lucaswewa/microscope/docs/adr/README.md

# Architecture decision records

An ADR records one significant decision: the context, what was decided, its consequences, and the alternatives that lost. [ADR-0001](0001-record-architecture-decisions.md) explains why we keep them.

## Process

1. Write the ADR in the pull request of the phase that makes the decision. Copy [template.md](template.md) to `NNNN-short-title.md`, using the next free number.
2. Give it the status *Accepted*. Approving the pull request accepts the ADR. If the review changes the decision, the ADR is edited in the same pull request. *Proposed* is only for an ADR written ahead of a decision, to collect review on it.
3. After acceptance, an ADR isn't edited except for its status line. To change a decision, write a new ADR and mark the old one *Superseded by ADR-NNNN*.
4. Add a row to the index below.

ADRs say *why*. What was built, and how, goes in the phase's [implementation notes](../milestone-1/notes/README.md).

## Index

| ADR | Title | Status | Phase |
|---|---|---|---|
| [0001](0001-record-architecture-decisions.md) | Record architecture decisions | Accepted | P00 |
| [0002](0002-independent-implementation-of-openflexure-inspired-behaviour.md) | Independent implementation of OpenFlexure-inspired behaviour | Accepted | P00 |
| [0003](0003-milestone-1-platform-windows-x86-64.md) | Milestone-1 platform: Windows x86_64 | Superseded by ADR-0038 | P00 |
| [0004](0004-depend-on-teta-wot-v0-1-0-without-upstream-changes.md) | Depend on `teta-wot` v0.1.0 without upstream changes | Accepted | P00 |
| [0005](0005-repository-layout-and-crate-boundaries.md) | Repository layout and crate boundaries | Accepted; amended by ADR-0041 | P01 |
| [0006](0006-own-the-server-lifecycle-around-teta-wots-runtime.md) | Own the server lifecycle around `teta-wot`'s runtime | Accepted | P02 |
| [0007](0007-api-prefix-and-openflexure-mirrored-names.md) | API prefix `/api/v1` and OpenFlexure-mirrored names | Accepted | P02 |
| [0008](0008-server-logging-and-log-endpoints.md) | Server logging and log endpoints | Accepted | P03 |
| [0009](0009-frontend-toolchain.md) | Frontend toolchain | Accepted | P04 |
| [0010](0010-rules-for-a-tauri-ready-web-app.md) | Rules for a Tauri-ready web app | Accepted | P04 |
| [0011](0011-design-tokens-and-theming.md) | Design tokens and theming | Accepted; superseded in part by ADR-0047 | P06 |
| [0012](0012-icon-set.md) | Icon set | Accepted | P07 |
| [0013](0013-own-components-on-reka-ui-primitives.md) | Own components on Reka UI primitives | Accepted | P08 |
| [0014](0014-client-transports-td-forms-fetch-streams-polled-invocations.md) | Client transports: TD forms, fetch streams, polled invocations | Accepted | P10 |
| [0015](0015-connection-model.md) | Connection model | Accepted | P11 |
| [0016](0016-serving-and-embedding-the-web-app.md) | Serving and embedding the web app | Accepted | P12 |
| [0017](0017-simulator-architecture.md) | Simulator architecture | Accepted | P13 |
| [0018](0018-hardware-abstraction-through-teta-wot-interfaces.md) | Hardware abstraction through `teta-wot` interfaces | Accepted; superseded in part by ADR-0044 | P15 |
| [0019](0019-stage-units-integer-steps-with-a-um-scale.md) | Stage units: integer steps with a µm scale | Accepted | P15 |
| [0020](0020-camera-frame-pipeline.md) | Camera frame pipeline | Accepted | P17 |
| [0021](0021-generated-api-types.md) | Generated API types | Accepted | P19 |
| [0022](0022-sharpness-metric-and-fast-autofocus.md) | Sharpness metric and fast autofocus | Superseded in part by ADR-0037 | P21 |
| [0023](0023-image-registration-by-phase-correlation.md) | Image registration by phase correlation | Accepted | P22 |
| [0024](0024-server-described-ui-elements.md) | Server-described UI elements | Accepted | P24 |
| [0025](0025-data-folder-layout-and-capture-metadata.md) | Data folder layout and capture metadata | Accepted | P26 |
| [0026](0026-gallery-index-and-data-route.md) | Gallery index and data route | Accepted | P31 |
| [0027](0027-deep-zoom-viewer.md) | Deep-zoom viewer | Accepted | P33 |
| [0028](0028-scan-planning-model.md) | Scan planning model | Accepted | P34 |
| [0029](0029-scan-engine-and-workflow-things.md) | Scan engine and workflow Things | Accepted | P35 |
| [0030](0030-position-based-stitching-with-dzi-output.md) | Position-based stitching with DZI output | Accepted; superseded in part by ADR-0046 | P38 |
| [0031](0031-sequence-model.md) | Sequence model | Accepted | P41 |
| [0032](0032-sidecar-process-contract.md) | Sidecar process contract | Accepted | P44 |
| [0033](0033-local-launcher-and-its-tauri-successor.md) | Local launcher and its Tauri successor | Accepted | P45 |
| [0034](0034-visual-regression-baselines.md) | Visual regression baselines | Accepted | P47 |
| [0035](0035-release-packaging-and-third-party-notices.md) | Release packaging and third-party notices | Accepted | P49 |
| [0036](0036-image-overlay-layers.md) | Image overlay layers | Accepted | P53 |
| [0037](0037-autofocus-accuracy.md) | Autofocus accuracy: focus at the curve's centroid | Accepted | P54 |
| [0038](0038-milestone-2-platforms.md) | Milestone-2 platforms: Windows, Linux and the Raspberry Pi 5 | Accepted; superseded in part by ADR-0040 | M2 P00 |
| [0039](0039-teta-wot-on-linux.md) | `teta-wot` on Linux | Accepted | M2 P01 |
| [0040](0040-linux-ci-on-request-and-parallel-tests.md) | Linux CI on request, and the Rust tests in parallel | Accepted | M2, after P01 |
| [0041](0041-hardware-drivers.md) | Hardware drivers: SDKs, device actors and hardware tests | Accepted | M2 P03a |
| [0042](0042-zaber-stages-through-the-ascii-protocol.md) | Zaber stages through the ASCII protocol | Accepted | M2 P04 |
| [0043](0043-the-sdk-camera-frame-pipeline.md) | The SDK camera frame pipeline | Accepted | M2 P06 |
| [0044](0044-one-camera-thing-for-every-sdk.md) | One camera Thing for every SDK, and Basler cameras through pylon | Accepted | M2 P07 |
| [0046](0046-correlation-stitching.md) | Correlation stitching | Accepted | M2 P12 |
| [0047](0047-accent-colours-a-person-can-choose.md) | Accent colours a person can choose | Accepted | M2, outside a phase |

The [implementation plan](../milestone-1/implementation-plan.md#adr-plan) lists the ADRs planned for later phases.
