lucaswewa/microscope/docs/milestone-2/notes/README.md

# Milestone 2 implementation notes

One file per phase, written in that phase's pull request from [template.md](template.md). The notes say what was built, how to try it, what hardware it was tried on, how it was designed, where it departs from the [phase spec](../phases.md), and what's left to do. The reasons behind significant decisions go in [ADRs](../../adr/README.md).

## Status

A phase's notes are marked *In review* in its own pull request. The next phase's pull request marks them, and the phase's row in the [plan's overview](../implementation-plan.md#7-phase-overview), *Done*, since a merged pull request can't be edited. A driver phase is *Done* only after the owner has run its "How to try it" on the device.

## Index

| Phase | Notes | Status |
|---|---|---|
| P00 | [Milestone 2 groundwork](P00-groundwork.md) | Done |
| P01 | [Linux builds and CI](P01-linux-ci.md) | Done |
| P02 | [The Linux service and packages](P02-linux-service.md) | Done |
| P03a | [Device actors and serial ports](P03a-device-actors.md) | Done |
| P03b | [The SDKs at run time, and listing devices](P03b-sdks.md) | Done |
| P04 | [Zaber stages](P04-zaber.md) | In review, until tried on the stage |
| P06 | [The SDK camera pipeline](P06-camera-pipeline.md) | Done |
| P07 | [Basler cameras](P07-basler.md) | In review, until tried on the camera |
| P12 | [Correlation placement](P12-correlation-placement.md) | In review |
