lucaswewa/microscope/docs/misc/optima.md

# Optic Platform for Targeted Imaging & Microscopy Automation (OPTIMA)

## Features
| Feature | Description |
|----|----|
| Standrd Objectives | 4x/10x/20x/40x |
| Automated motorized three-position turret | Customization possible |
| Excitation Wavelengths | 405 nm (e.g. DAPI) |
| Single-laser, dual laser or quad laser configuration | 488 nm (e.g. GFP) |
| Emission Wavelengths | 520 nm, (e.g. mCherry) |
|  | 635 nm, (e.g. AlexaFluor 647) |
|  | Custom Cube Setup (typically DAPI 488 nm, GFP 520 nm, mCherry) 635 nm, AlexaFluor 647 |
| Imaging Modes | Brightfield, Colored Brightfield, Phase Contrast, Fluorescence, DPC, FLIM (through FLIM Labs) |
| Operating Range (XYZ) | 100x100x20 mm |
| Focusing Drive Range (Zf) | 4 mm |
| Illumination options | LED array for phase-contrast |
| Labware Supported | Microplates (6x-384x), cell culture flasks (T25, T75), Petri- and cell culture dishes, microscope slides (4fold holder), count- and flow chambers, adapter for customized formats |
| Camera Compatibility | Single/Dual-camera in cube assembly (e.g. RGB for Histology, Monochrome for Fluorescence), overview camera top |
| Data Format | OME-ZARR, OME-TIF, JPEG, MP4, PNG, customized |
| Dimensions & Weight | 300x300x300 mm, <16Kg |
| Electric Input | Power Supply: 110/230V, 50/60Hz |
|  | 12V, 5A (optional: battery-driven) |
