lucaswewa/microscope/docs/misc/microscope_algorithms_and_workflows.md

# Microscope Software: Algorithm and Workflow Catalog

Prepared for software serving biotechnology, semiconductors, metallurgy, scientific research, optical device inspection, and adjacent industries.

Last reviewed: October 30, 2026.

## Scope and how to use this catalog

This is a broad planning catalog, rather than a claim to enumerate every microscopy method. It covers optical microscopy first, with extensions for electron, scanning probe, X-ray, and acoustic microscopy. Entries include individual algorithms, algorithm families, application analysis modules, and supporting software capabilities. End-to-end workflows are listed separately in Part II.

Each catalog entry gives a brief description and representative application areas. A family such as thresholding can support several selectable implementations. Application modules deliberately reuse the shared algorithms; for example, cell counting, inclusion counting, and wafer particle counting share detection and measurement infrastructure but need different recipes and validation.

The **Ref Link** column in the algorithm and workflow tables links to a representative application, worked example, or documented implementation. Related entries may share a resource when it demonstrates several methods.

For optical layouts, hardware requirements, open build resources, and a design mapping for all 57 workflows, see [Reference Microscope Designs](microscope_reference_designs.md).

**Input and hardware assumptions**

- Ordinary 2D images support many correction, segmentation, counting, and dimensional analysis methods. Physical measurements require calibrated pixel sizes and suitable image quality.
- Z stacks, time series, multiple channels, tiled acquisitions, spectra, diffraction patterns, and measured height maps carry different information; retain their axes, units, and acquisition metadata.
- Acquisition control requires compatible camera, stage, illumination, and instrument interfaces. Focus-derived height requires a calibrated Z axis and an appropriate sample surface.
- Interferometry, quantitative phase imaging, fluorescence lifetime imaging, Raman analysis, electron diffraction, and similar methods require their corresponding measurements or instrument configurations. They cannot be recovered reliably from arbitrary conventional images.
- Optical lateral resolution, axial resolution, localization precision, height precision, and measurement uncertainty are different quantities. Software must report the quantity actually measured.
- Quantitative analysis should retain raw data and record all corrections. Learned restoration, synthetic staining, and inferred structures need validation against independent measurements before their outputs are used quantitatively.

**Navigation**

- [Part I: Algorithms and analysis modules](#part-i-algorithms-and-analysis-modules)
  - [1. Acquisition and microscope automation](#1-acquisition-and-microscope-automation)
  - [2. Calibration and instrument characterization](#2-calibration-and-instrument-characterization)
  - [3. Image correction, denoising, and restoration](#3-image-correction-denoising-and-restoration)
  - [4. Filtering and feature extraction](#4-filtering-and-feature-extraction)
  - [5. Registration, stitching, and fusion](#5-registration-stitching-and-fusion)
  - [6. Segmentation and object detection](#6-segmentation-and-object-detection)
  - [7. Measurement, morphology, and spatial statistics](#7-measurement-morphology-and-spatial-statistics)
  - [8. Tracking, motion, and temporal analysis](#8-tracking-motion-and-temporal-analysis)
  - [9. Volumetric analysis and 3D reconstruction](#9-volumetric-analysis-and-3d-reconstruction)
  - [10. Computational and quantitative phase microscopy](#10-computational-and-quantitative-phase-microscopy)
  - [11. Quantitative fluorescence and single-molecule analysis](#11-quantitative-fluorescence-and-single-molecule-analysis)
  - [12. Spectral, chemical, and polarization microscopy](#12-spectral-chemical-and-polarization-microscopy)
  - [13. Cell, microbial, and biotechnology assays](#13-cell-microbial-and-biotechnology-assays)
  - [14. Tissue, histology, and organism analysis](#14-tissue-histology-and-organism-analysis)
  - [15. Semiconductor wafers, lithography, and photomasks](#15-semiconductor-wafers-lithography-and-photomasks)
  - [16. Electronics packaging, PCBs, and displays](#16-electronics-packaging-pcbs-and-displays)
  - [17. Metallography and materials microstructure](#17-metallography-and-materials-microstructure)
  - [18. Optical components, fibers, and photonic devices](#18-optical-components-fibers-and-photonic-devices)
  - [19. Surface texture and experimental mechanics](#19-surface-texture-and-experimental-mechanics)
  - [20. Electron microscopy and crystallography](#20-electron-microscopy-and-crystallography)
  - [21. Scanning probe microscopy](#21-scanning-probe-microscopy)
  - [22. X-ray tomography and acoustic microscopy](#22-x-ray-tomography-and-acoustic-microscopy)
  - [23. Additional scientific and industrial applications](#23-additional-scientific-and-industrial-applications)
  - [24. Machine learning and annotation](#24-machine-learning-and-annotation)
  - [25. Data management, visualization, and interoperability](#25-data-management-visualization-and-interoperability)
  - [26. Quality assurance and reproducible execution](#26-quality-assurance-and-reproducible-execution)
- [Part II: End-to-end workflows](#part-ii-end-to-end-workflows)
- [Part III: Implementation planning](#part-iii-implementation-planning)
- [Selected technical references](#selected-technical-references)
- [Reference microscope designs and hardware mappings](microscope_reference_designs.md)

## Part I: Algorithms and analysis modules

### 1. Acquisition and microscope automation

These capabilities operate the instrument or plan image collection. Motorized functions require device support. See the [Micro-Manager acquisition and autofocus guide](https://micro-manager.org/Micro-Manager_User%27s_Guide2) for a practical reference implementation of multidimensional acquisition.

| ID | Algorithm or module | Brief summary | Application areas | Ref Link |
| --- | --- | --- | --- | --- |
| ACQ-01 | Contrast-based autofocus | Maximize a focus score such as Tenengrad, Laplacian variance, or a frequency-domain metric over a Z search. | Routine microscopy, wafer inspection, metallography, slide scanning. | [Autofocus example](https://micro-manager.org/SimpleAutofocus) |
| ACQ-02 | Coarse-to-fine focus search | Find a promising Z interval with large steps, then refine it with smaller steps or fitted focus curves. | Automated scanning, high-magnification inspection, multiwell imaging. | [Autofocus example](https://micro-manager.org/SimpleAutofocus) |
| ACQ-03 | Predictive or learned autofocus | Predict focus displacement from calibrated image features or a trained model, with confidence and fallback search. | High-throughput screening, repetitive industrial inspection. | [Adaptive acquisition tutorials](https://pycro-manager.readthedocs.io/en/latest/tutorials.html) |
| ACQ-04 | Hardware focus-lock control | Maintain a measured reference plane using a focus sensor and feedback; apply specimen offsets separately. | Long live-cell experiments, high-NA imaging, repetitive scans. | [Multidimensional acquisition](https://micro-manager.org/Micro-Manager_User%27s_Guide2) |
| ACQ-05 | Focus surface mapping | Fit a plane, polynomial, spline, or local surface through sampled focus positions. | Tilted wafers, large tissue sections, metallographic mounts. | [Adaptive 3D acquisition](https://micro-manager.org/MicroMagellan) |
| ACQ-06 | Multidimensional acquisition scheduling | Coordinate positions, channels, Z slices, time points, and acquisition order. | Fluorescence experiments, plate screening, confocal research. | [Multidimensional acquisition](https://micro-manager.org/Micro-Manager_User%27s_Guide2) |
| ACQ-07 | Tile and region scan planning | Generate overlapping tiles within rectangular, polygonal, circular, or irregular regions. | Whole-slide imaging, wafers, large components, materials surveys. | [Adaptive 3D acquisition](https://micro-manager.org/MicroMagellan) |
| ACQ-08 | Stage path optimization | Reduce travel and settling time using serpentine routes or constrained route optimization. | High-content screening, wafer review, automated particle inspection. | [Adaptive 3D acquisition](https://micro-manager.org/MicroMagellan) |
| ACQ-09 | Exposure and illumination optimization | Select exposure, gain, and illumination within signal, saturation, and dose constraints. | Fluorescence, reflective surfaces, automated quality inspection. | [Adaptive acquisition tutorials](https://pycro-manager.readthedocs.io/en/latest/tutorials.html) |
| ACQ-10 | Trigger and timestamp synchronization | Align cameras, illumination, scanners, stages, and external stimuli using hardware events and recorded timing. | Fast dynamics, multiview imaging, optogenetics, mechanical testing. | [Fast triggered 3D imaging](https://pycro-manager.readthedocs.io/en/latest/application_notebooks/TZYX_fast_sequencing_z_indexing.html) |
| ACQ-11 | Adaptive region selection | Use an overview scan to select informative regions for higher-resolution acquisition. | Rare-cell search, defect review, tissue imaging, particle analysis. | [Targeted collagen imaging](https://pycro-manager.readthedocs.io/en/latest/application_notebooks/guiding_acq_with_neural_network_attention.html) |
| ACQ-12 | Event-triggered acquisition | Detect an event online and change recording rate, channels, or regions under defined rules. | Mitosis, calcium activity, crack initiation, droplet events. | [Event-driven live-cell imaging](https://pmc.ncbi.nlm.nih.gov/articles/PMC7613693/) |
| ACQ-13 | Dose-aware acquisition | Allocate illumination or electron exposure according to signal needs and cumulative dose budgets. | Live-cell imaging, photosensitive samples, electron microscopy. | [Adaptive acquisition tutorials](https://pycro-manager.readthedocs.io/en/latest/tutorials.html) |
| ACQ-14 | Stage drift feedback | Estimate displacement from references and correct stage or acquisition coordinates over time. | Long time series, nanostructure imaging, correlative microscopy. | [Data-driven microscopy](https://pmc.ncbi.nlm.nih.gov/articles/PMC10088093/) |
| ACQ-15 | Adaptive Z sampling | Adjust stack boundaries and spacing from surface estimates, signal content, and required axial sampling. | Thick specimens, uneven surfaces, organoids, industrial topography. | [Adaptive 3D acquisition](https://micro-manager.org/MicroMagellan) |
| ACQ-16 | Revisit and coordinate navigation | Transform stored object locations into current stage coordinates using fiducials and alignment models. | Defect review, cell revisiting, sample preparation, multimodal studies. | [Multidimensional acquisition](https://micro-manager.org/Micro-Manager_User%27s_Guide2) |

### 2. Calibration and instrument characterization

Calibration should be indexed by objective, zoom, camera mode, wavelength, and relevant instrument settings. The [ImageJ scientific imaging tutorials](https://imagej.net/imaging/) provide background on spatial calibration and chromatic shift.

| ID | Algorithm or module | Brief summary | Application areas | Ref Link |
| --- | --- | --- | --- | --- |
| CAL-01 | Pixel and voxel scale calibration | Estimate physical sampling from traceable grids, rulers, stage motion, and Z references. | All dimensional and volumetric measurements. | [Microscope QC application](https://pmc.ncbi.nlm.nih.gov/articles/9526251/) |
| CAL-02 | Camera-to-stage coordinate calibration | Fit rotation, scale, shear, and axis directions between pixels and stage coordinates. | Automated navigation, mosaics, robotic inspection. | [Adaptive 3D acquisition](https://micro-manager.org/MicroMagellan) |
| CAL-03 | Geometric distortion calibration | Fit radial, tangential, or spatial warp models using a known target. | Large-field metrology, optical inspection, precision mosaics. | [Camera calibration example](https://docs.opencv.org/4.x/dc/dbb/tutorial_py_calibration.html) |
| CAL-04 | Stage backlash and repeatability estimation | Measure approach-direction errors, hysteresis, and revisit variability. | Precision inspection, automated screening, coordinate transfer. | [Gauge R&R example](https://www.itl.nist.gov/div898/handbook/mpc/section4/mpc4.htm) |
| CAL-05 | Z-axis and axial scaling calibration | Measure Z travel and optical axial scaling, including refractive-index effects where modeled. | Confocal volumes, optical sectioning, focus-derived height. | [Microscope QC application](https://pmc.ncbi.nlm.nih.gov/articles/9526251/) |
| CAL-06 | Point spread function estimation | Estimate spatially invariant or varying blur from beads, edges, or an optical model. | Deconvolution, resolution checks, localization microscopy. | [Microscope QC application](https://pmc.ncbi.nlm.nih.gov/articles/9526251/) |
| CAL-07 | Resolution and transfer-function characterization | Measure edge, line, bead, or target responses to characterize image contrast versus spatial frequency. | Microscope acceptance, objective comparison, optical quality. | [MTF characterization example](https://www.imatest.com/imaging/validating_slanted_edge/) |
| CAL-08 | Camera noise and gain characterization | Estimate conversion gain, read noise, dark current, and variance behavior from calibration frames. | Low-light fluorescence, quantitative imaging, detector qualification. | [Camera characterization](https://www.emva.org/standards-technology/emva-1288/) |
| CAL-09 | Sensor nonlinearity and saturation calibration | Measure and correct response nonlinearity within a characterized operating range. | Intensity assays, reflectance imaging, detector comparison. | [Camera characterization](https://www.emva.org/standards-technology/emva-1288/) |
| CAL-10 | Illumination uniformity calibration | Estimate flat-field and shading maps for each relevant optical configuration. | Tile scanning, quantitative fluorescence, surface inspection. | [CellProfiler example pipelines](https://cellprofiler.org/examples) |
| CAL-11 | Chromatic alignment calibration | Estimate channel-dependent translation, distortion, and axial offsets using multicolor references. | Colocalization, multiplex assays, multichannel metrology. | [Microscope QC application](https://pmc.ncbi.nlm.nih.gov/articles/9526251/) |
| CAL-12 | Spectral crosstalk calibration | Measure channel mixing from single-label or single-component controls. | Fluorescence unmixing, spectral microscopy, multiplex assays. | [PixFRET application](https://imagej.net/plugins/pixfret) |
| CAL-13 | Color calibration and white balance | Map camera responses to a controlled color representation using reference targets and illumination. | Histology, mineralogy, industrial color inspection. | [Color-checker calibration example](https://docs.opencv.org/4.12.0/d1/dc1/tutorial_ccm_color_correction_model.html) |
| CAL-14 | Temporal and scan calibration | Characterize frame timing, trigger latency, rolling shutter, scan spacing, and line timing. | Motion measurement, high-speed imaging, raster microscopy. | [Fast triggered 3D imaging](https://pycro-manager.readthedocs.io/en/latest/application_notebooks/TZYX_fast_sequencing_z_indexing.html) |
| CAL-15 | Height-reference calibration | Verify vertical response and lateral sampling using step-height, flatness, or roughness artifacts. | Interferometry, confocal profilometry, scanning probe metrology. | [Calibration and uncertainties](https://gwyddion.net/documentation/user-guide-en/caldata.html) |
| CAL-16 | Measurement uncertainty propagation | Propagate calibration, repeatability, segmentation, and model contributions to reported uncertainty. | Industrial metrology, quantitative research, instrument validation. | [Dimensional uncertainty study](https://www.nist.gov/publications/dimensional-measurement-uncertainty-data-part-2-uncertainty-rr) |

### 3. Image correction, denoising, and restoration

Apply corrections in a documented order and preserve the unprocessed measurements. The [ImageJ deconvolution guide](https://imagej.net/imaging/deconvolution) describes PSF-based restoration and its input requirements.

| ID | Algorithm or module | Brief summary | Application areas | Ref Link |
| --- | --- | --- | --- | --- |
| COR-01 | Dark and offset correction | Subtract calibrated electronic offsets and exposure-dependent dark signal. | Fluorescence, spectroscopy, long-exposure imaging. | [Camera characterization](https://www.emva.org/standards-technology/emva-1288/) |
| COR-02 | Flat-field and shading correction | Normalize spatial sensitivity and illumination using matched reference images or estimated fields. | Quantitative intensity analysis, mosaics, whole-slide scans. | [CellProfiler example pipelines](https://cellprofiler.org/examples) |
| COR-03 | Background estimation and subtraction | Estimate background using rolling-ball, polynomial, morphological, or robust surface models. | Fluorescence spots, etched materials, uneven illumination. | [Use rolling-ball algorithm for estimating background intensity](https://scikit-image.org/docs/stable/auto_examples/segmentation/plot_rolling_ball.html) |
| COR-04 | Bad-pixel and impulse correction | Identify and replace hot, dead, or impulsive pixels while retaining a correction mask. | Scientific cameras, electron detectors, spectroscopy. | [Fill in defects with inpainting](https://scikit-image.org/docs/stable/auto_examples/filters/plot_inpaint.html) |
| COR-05 | Median and rank denoising | Suppress isolated noise using neighborhood order statistics. | Particle images, brightfield microscopy, detector artifacts. | [Denoising a picture](https://scikit-image.org/docs/stable/auto_examples/filters/plot_denoise.html) |
| COR-06 | Gaussian and variance-aware smoothing | Reduce high-frequency noise with explicit spatial scale and, where relevant, a noise model. | Segmentation preprocessing, low-signal imaging. | [Denoising a picture](https://scikit-image.org/docs/stable/auto_examples/filters/plot_denoise.html) |
| COR-07 | Bilateral and nonlocal means denoising | Average similar intensities or patches while reducing smoothing across strong boundaries. | Cells, materials textures, electron images. | [Non-local means denoising for preserving textures](https://scikit-image.org/docs/stable/auto_examples/filters/plot_nonlocal_means.html) |
| COR-08 | Wavelet and BM3D-style denoising | Shrink multiscale coefficients or jointly filter groups of similar patches. | Low-light microscopy, electron microscopy, textured specimens. | [Shift-invariant wavelet denoising](https://scikit-image.org/docs/stable/auto_examples/filters/plot_cycle_spinning.html) |
| COR-09 | Total variation and anisotropic diffusion | Regularize noise while favoring piecewise-smooth regions or directional structure. | Phase images, tomography, boundary-sensitive analysis. | [Denoising a picture](https://scikit-image.org/docs/stable/auto_examples/filters/plot_denoise.html) |
| COR-10 | Poisson-Gaussian noise treatment | Use count-aware estimators or variance stabilization matched to photon and read noise. | Fluorescence, low-dose electron imaging, quantitative restoration. | [Mixed-noise light-sheet reconstruction](https://pmc.ncbi.nlm.nih.gov/articles/PMC7613773/) |
| COR-11 | Wiener and regularized inverse filtering | Invert a characterized blur with stabilization against noise amplification. | Optical restoration, engineered imaging systems. | [Image Deconvolution](https://scikit-image.org/docs/stable/auto_examples/filters/plot_restoration.html) |
| COR-12 | Richardson-Lucy deconvolution | Iteratively estimate an object from a PSF and a photon-counting image formation model. | Widefield fluorescence, confocal stacks, light-sheet imaging. | [Image Deconvolution](https://scikit-image.org/docs/stable/auto_examples/filters/plot_restoration.html) |
| COR-13 | Blind and spatially varying deconvolution | Jointly estimate uncertain blur or use location-dependent PSFs under constraints. | Thick specimens, aberrated imaging, nonuniform optical systems. | [Depth-varying deconvolution study](https://pmc.ncbi.nlm.nih.gov/articles/PMC5155489/) |
| COR-14 | Learned and self-supervised denoising | Restore images using paired training, independent noisy observations, or valid noise assumptions. | Low-dose imaging, live cells, high-throughput research. | [Noise2Void microscopy examples](https://github.com/juglab/n2v) |
| COR-15 | Stripe, line, and scan artifact correction | Remove characterized banding, raster discontinuities, or light-sheet stripes with masks and filtering. | Light-sheet, SEM, confocal, scanning probe images. | [Scan Line Artefacts](https://gwyddion.net/documentation/user-guide-en/scan-line-defects.html) |
| COR-16 | Photobleaching trend correction | Estimate reference or model-based signal decay, preserving genuine biological changes separately. | Long fluorescence time series, FRAP preprocessing. | [Photobleaching correction examples](https://imagej.net/plugins/bleach-correction) |
| COR-17 | HDR radiometric fusion | Combine registered exposures with a calibrated response to extend measurable intensity range. | Reflective metals, optical components, mixed-brightness specimens. | [HDR exposure fusion example](https://docs.opencv.org/4.x/d2/df0/tutorial_py_hdr.html) |

### 4. Filtering and feature extraction

These are reusable building blocks rather than complete application workflows. Representative operations are documented in [scikit-image morphology](https://scikit-image.org/docs/stable/api/skimage.morphology).

| ID | Algorithm or module | Brief summary | Application areas | Ref Link |
| --- | --- | --- | --- | --- |
| FEA-01 | Contrast stretching and histogram equalization | Remap display intensities globally or locally, including CLAHE; track quantitative use separately. | Visual review, low-contrast structures, operator assistance. | [Local Histogram Equalization](https://scikit-image.org/docs/stable/auto_examples/color_exposure/plot_local_equalize.html) |
| FEA-02 | Gradient and edge detection | Compute Sobel, Scharr, Canny, or derivative-of-Gaussian responses. | Boundaries, scratches, dimensional measurement. | [Canny edge detector](https://scikit-image.org/docs/stable/auto_examples/edges/plot_canny.html) |
| FEA-03 | Laplacian and scale-space blob detection | Locate bright or dark spots across scales using LoG or DoG responses. | Nuclei, vesicles, particles, pinholes. | [Blob Detection](https://scikit-image.org/docs/stable/auto_examples/features_detection/plot_blob.html) |
| FEA-04 | Ridge and vessel enhancement | Use Hessian eigenvalues or directional filters to enhance elongated structures. | Neurites, vessels, cracks, fibers, interconnects. | [Ridge operators](https://scikit-image.org/docs/stable/auto_examples/edges/plot_ridge_filter.html) |
| FEA-05 | Mathematical morphology | Apply erosion, dilation, opening, closing, top-hat, and reconstruction operations. | Mask cleanup, small-feature extraction, background estimation. | [Morphological Filtering](https://scikit-image.org/docs/stable/auto_examples/applications/plot_morphology.html) |
| FEA-06 | Fourier-domain filtering | Apply low-pass, high-pass, band-pass, or notch filters with controlled frequency response. | Periodic structures, scan artifacts, spatial-frequency analysis. | [Butterworth Filters](https://scikit-image.org/docs/stable/auto_examples/filters/plot_butterworth.html) |
| FEA-07 | Wavelet and multiscale features | Describe structure at several spatial scales using localized basis functions. | Texture classification, defects, biological phenotypes. | [Shift-invariant wavelet denoising](https://scikit-image.org/docs/stable/auto_examples/filters/plot_cycle_spinning.html) |
| FEA-08 | Gabor and steerable filters | Measure oriented patterns at selected directions and wavelengths. | Fibers, machining marks, gratings, cell alignment. | [Gabor filter banks for texture classification](https://scikit-image.org/docs/stable/auto_examples/features_detection/plot_gabor.html) |
| FEA-09 | Structure tensor analysis | Estimate dominant orientation, coherence, and local directional organization. | Collagen, composites, grains, cellular alignment. | [Fiber orientation examples](https://bigwww.epfl.ch/demo/orientation/) |
| FEA-10 | Texture descriptors | Calculate co-occurrence, local binary pattern, run-length, or related texture statistics. | Histology, metallography, surface classification. | [GLCM Texture Features](https://scikit-image.org/docs/stable/auto_examples/features_detection/plot_glcm.html) |
| FEA-11 | Hough and Radon transforms | Detect parameterized lines, circles, or oriented structures by accumulating evidence. | Circular defects, fibers, wafer alignment, line arrays. | [Straight line Hough transform](https://scikit-image.org/docs/stable/auto_examples/edges/plot_line_hough_transform.html) |
| FEA-12 | Template and matched filtering | Find known patterns using normalized correlation or a noise-aware matched response. | Fiducials, repeated devices, fluorescent spots. | [Template Matching](https://scikit-image.org/docs/stable/auto_examples/features_detection/plot_template.html) |
| FEA-13 | Keypoint and local descriptor extraction | Identify distinctive points and compute descriptors for matching across images. | Registration, object retrieval, multimodal alignment. | [ORB feature detector and binary descriptor](https://scikit-image.org/docs/stable/auto_examples/features_detection/plot_orb.html) |
| FEA-14 | Color and optical-density features | Extract calibrated color components, ratios, or absorbance-like features from reference intensities. | Stained tissue, minerals, corrosion, coating inspection. | [Separating stains](https://qupath.readthedocs.io/en/stable/docs/tutorials/separating_stains.html) |

### 5. Registration, stitching, and fusion

Choose transformations consistent with the specimen and acquisition. A flexible warp can hide real deformation or manufacturing errors if applied without constraints.

| ID | Algorithm or module | Brief summary | Application areas | Ref Link |
| --- | --- | --- | --- | --- |
| REG-01 | Phase-correlation alignment | Estimate image translation from normalized Fourier cross-power spectra, optionally at subpixel precision. | Drift correction, tile placement, repeated inspections. | [Image Registration](https://scikit-image.org/docs/stable/auto_examples/registration/plot_register_translation.html) |
| REG-02 | Intensity-based rigid and affine registration | Optimize similarity while permitting selected translation, rotation, scale, or shear parameters. | Time series, channel alignment, reference comparison. | [Using geometric transformations](https://scikit-image.org/docs/stable/auto_examples/transform/plot_geometric.html) |
| REG-03 | Feature-based robust registration | Match local features and reject outliers using RANSAC or robust estimation. | Mosaics, damaged specimens, changing fields of view. | [Robust matching using RANSAC](https://scikit-image.org/docs/stable/auto_examples/transform/plot_matching.html) |
| REG-04 | Multimodal registration | Use mutual information, descriptors, or learned similarity across differing contrast mechanisms. | Optical-to-SEM correlation, fluorescence-to-brightfield alignment. | [Multimodal registration examples](https://simpleitk.readthedocs.io/en/master/registrationOverview.html) |
| REG-05 | Deformable registration | Fit B-spline, optical-flow, or diffeomorphic warps with regularization and deformation reporting. | Tissue sections, live specimens, serial imaging. | [Registration using optical flow](https://scikit-image.org/docs/stable/auto_examples/registration/plot_opticalflow.html) |
| REG-06 | Global tile graph optimization | Solve tile positions jointly from overlaps and stage priors to reduce accumulated mosaic error. | Whole slides, wafer mosaics, large-area materials scans. | [Large-volume stitching](https://imagej.net/plugins/bigstitcher/) |
| REG-07 | Mosaic seam and brightness balancing | Blend overlaps and compensate exposure differences while preserving quantitative originals. | Whole-slide viewing, component overviews, microscopy atlases. | [Microscopy stitching example](https://imagej.net/plugins/image-stitching) |
| REG-08 | 3D stack registration | Align volumes using image similarity, landmarks, or surface features. | Longitudinal imaging, serial scans, multiview microscopy. | [Large-volume stitching](https://imagej.net/plugins/bigstitcher/) |
| REG-09 | Fiducial-based coordinate transfer | Fit coordinate transformations from corresponding beads, markers, or lithographic landmarks. | Correlative microscopy, FIB targeting, repeat defect review. | [Correlative semiconductor failure analysis](https://www.zeiss.com/microscopy/us/applications/semiconductors-electronics/failure-analysis-3d-characterization.html) |
| REG-10 | Extended depth-of-field fusion | Select or blend locally sharp Z slices into an all-in-focus image. | Rough parts, insects, minerals, metallographic surfaces. | [Extended-focus specimen example](https://bigwww.epfl.ch/demo/edf/) |
| REG-11 | Multiview image fusion | Combine registered views using confidence, visibility, or joint deconvolution models. | Light-sheet microscopy, 3D specimen imaging. | [Multiview deconvolution example](https://imagej.net/plugins/multi-view-deconvolution) |
| REG-12 | Super-resolution from shifted frames | Reconstruct additional sampling information from calibrated subpixel shifts and an imaging model. | Static specimens, engineered acquisition, resolution research. | [Subpixel-shift super-resolution example](https://pmc.ncbi.nlm.nih.gov/articles/PMC3364049/) |
| REG-13 | Correlative layer overlays | Display aligned modalities, annotations, spectra, and measurement maps with coordinate provenance. | Failure analysis, multimodal biology, materials characterization. | [Correlative semiconductor failure analysis](https://www.zeiss.com/microscopy/us/applications/semiconductors-electronics/failure-analysis-3d-characterization.html) |

### 6. Segmentation and object detection

Support both conventional and learned approaches; object density, image contrast, sample preparation, and training coverage determine which works well.

| ID | Algorithm or module | Brief summary | Application areas | Ref Link |
| --- | --- | --- | --- | --- |
| SEG-01 | Global thresholding | Separate foreground using fixed, Otsu, entropy, triangle, or mixture-based thresholds. | Particles, phases, high-contrast cells, contamination. | [Thresholding](https://scikit-image.org/docs/stable/auto_examples/segmentation/plot_thresholding.html) |
| SEG-02 | Adaptive local thresholding | Compute spatially varying thresholds, including Sauvola- or Niblack-style methods. | Unevenly illuminated tissue, grains, low-contrast defects. | [Niblack and Sauvola Thresholding](https://scikit-image.org/docs/stable/auto_examples/segmentation/plot_niblack_sauvola.html) |
| SEG-03 | Multilevel and multichannel thresholding | Assign multiple classes using intensity bands, channel logic, or joint thresholds. | Material phases, fluorescence phenotypes, coating regions. | [Multi-Otsu Thresholding](https://scikit-image.org/docs/stable/auto_examples/segmentation/plot_multiotsu.html) |
| SEG-04 | Connected-component labeling | Assign object identities to connected foreground regions with explicit connectivity rules. | Object counting, defects, particles, pores. | [Label image regions](https://scikit-image.org/docs/stable/auto_examples/segmentation/plot_label.html) |
| SEG-05 | Marker-controlled watershed | Split touching structures using seed markers and distance or gradient landscapes. | Nuclei, grains, packed particles, droplets. | [Watershed segmentation](https://scikit-image.org/docs/stable/auto_examples/segmentation/plot_watershed.html) |
| SEG-06 | Region growing and reconstruction | Expand seed regions according to intensity, connectivity, or reference-mask constraints. | Voids, cells, inclusions, tissue compartments. | [Flood Fill](https://scikit-image.org/docs/stable/auto_examples/segmentation/plot_floodfill.html) |
| SEG-07 | Active contours and level sets | Evolve boundaries using image evidence and shape or smoothness priors. | Membranes, organoids, interfaces, irregular defects. | [Active Contour Model](https://scikit-image.org/docs/stable/auto_examples/edges/plot_active_contours.html) |
| SEG-08 | Graph cuts and random walker | Partition images using seeded graph optimization or probabilistic label propagation. | Interactive segmentation, complex backgrounds, materials phases. | [Random walker segmentation](https://scikit-image.org/docs/stable/auto_examples/segmentation/plot_random_walker_segmentation.html) |
| SEG-09 | Superpixel segmentation | Group locally similar pixels into compact regions for later classification or editing. | Whole-slide images, large materials maps, annotation tools. | [Comparison of segmentation and superpixel algorithms](https://scikit-image.org/docs/stable/auto_examples/segmentation/plot_segmentations.html) |
| SEG-10 | Pixel classification | Train random forests, boosting, or other classifiers on multiscale pixel features. | Small annotated datasets, phase identification, tissue classification. | [Trainable segmentation using local features and random forests](https://scikit-image.org/docs/stable/auto_examples/segmentation/plot_trainable_segmentation.html) |
| SEG-11 | Semantic deep segmentation | Use U-Net-like or transformer models to assign a class to each pixel or voxel. | Tissue regions, pores, cracks, fluorescence structures. | [Interactive classification examples](https://www.ilastik.org/documentation/) |
| SEG-12 | Instance segmentation | Separate individual objects using boundary, proposal, flow, or star-convex representations. | Cells, nuclei, colonies, overlapping particles. | [StarDist segmentation examples](https://github.com/stardist/stardist) |
| SEG-13 | Object detection and keypoint localization | Predict object boxes, centers, or landmarks when complete masks are unnecessary. | Defect triage, cell search, fiducials, device localization. | [Blob Detection](https://scikit-image.org/docs/stable/auto_examples/features_detection/plot_blob.html) |
| SEG-14 | Prompt-assisted segmentation | Produce editable masks from points, boxes, or reference objects using a suitable model. | Annotation, rare defects, interactive research analysis. | [Interactive microscopy segmentation](https://github.com/computational-cell-analytics/micro-sam) |
| SEG-15 | Anomaly segmentation | Localize deviations from a learned or measured normal appearance. | Rare manufacturing defects, contamination, process excursions. | [Visual anomaly detection examples](https://anomalib.readthedocs.io/en/latest/) |
| SEG-16 | Topology-aware mask refinement | Repair boundaries, separate bridges, fill selected holes, and enforce justified connectivity constraints. | Vessels, grain networks, interconnects, porous materials. | [3D morphology applications](https://imagej.net/plugins/morpholibj) |
| SEG-17 | Counting with border and overlap handling | Apply counting frames, exclusion rules, tile deduplication, or density estimation as appropriate. | Cell populations, particles, inclusion surveys, wafer scans. | [CellProfiler example pipelines](https://cellprofiler.org/examples) |

### 7. Measurement, morphology, and spatial statistics

Record coordinate systems and units for every result. Three-dimensional inferences from two-dimensional sections require explicit sampling and stereological assumptions.

| ID | Algorithm or module | Brief summary | Application areas | Ref Link |
| --- | --- | --- | --- | --- |
| MEA-01 | Interactive geometric measurement | Measure calibrated lengths, angles, areas, radii, and distances with editable annotations. | General microscopy, failure analysis, operator inspection. | [Feature Measurement](https://gwyddion.net/documentation/user-guide-en/feature-measurement.html) |
| MEA-02 | Subpixel edge and profile fitting | Fit intensity transitions or physical edge models to estimate boundary positions beyond pixel spacing. | Line widths, gaps, device dimensions, optical inspection. | [CD-SEM dimensional analysis](https://www.hitachi-hightech.com/us/en/products/advanced-analytical/microscopy/cdsem.html) |
| MEA-03 | Primitive and contour fitting | Fit lines, circles, ellipses, splines, or parametric shapes using robust residual minimization. | Holes, vias, fibers, roundness, dimensional metrology. | [Robust line model estimation using RANSAC](https://scikit-image.org/docs/stable/auto_examples/transform/plot_ransac.html) |
| MEA-04 | Size and shape descriptors | Calculate area, perimeter, Feret dimensions, equivalent diameter, circularity, solidity, and aspect ratio. | Cells, powders, inclusions, defects, droplets. | [Measure region properties](https://scikit-image.org/docs/stable/auto_examples/segmentation/plot_regionprops.html) |
| MEA-05 | Intensity and concentration-proxy statistics | Measure background-corrected intensity distributions with normalization and assay-specific calibration. | Fluorescence, absorption imaging, reporter assays. | [Measure fluorescence intensity at the nuclear envelope](https://scikit-image.org/docs/stable/auto_examples/applications/plot_fluorescence_nuclear_envelope.html) |
| MEA-06 | Boundary curvature and shape signatures | Describe contour curvature, Fourier descriptors, or shape deviations from a reference. | Cell morphology, edge defects, particle classification. | [Measure region properties](https://scikit-image.org/docs/stable/auto_examples/segmentation/plot_regionprops.html) |
| MEA-07 | Distance transforms and local thickness | Calculate distances to boundaries and local feature widths in calibrated coordinates. | Pore throats, membranes, fibers, coatings, cracks. | [3D structure measurements](https://bonej.org/) |
| MEA-08 | Skeleton and network graph analysis | Extract centerlines and measure branch lengths, junctions, connectivity, and path geometry. | Neurites, vessels, cracks, fibrous materials. | [Neuron tracing examples](https://imagej.net/plugins/snt/) |
| MEA-09 | Nearest-neighbor and proximity analysis | Quantify distances between objects, boundaries, phases, or compartments. | Cell interactions, defect spacing, inclusion distributions. | [Spatial cell-neighborhood example](https://squidpy.readthedocs.io/en/stable/notebooks/tutorials/tutorial_vizgen.html) |
| MEA-10 | Spatial point-pattern analysis | Use pair correlation, Ripley's functions, or spatial null models to characterize clustering. | Molecular organization, cell neighborhoods, particle distributions. | [Spatial cell-neighborhood example](https://squidpy.readthedocs.io/en/stable/notebooks/tutorials/tutorial_vizgen.html) |
| MEA-11 | Orientation and anisotropy distributions | Measure preferred directions and dispersion from objects, tensors, or frequency spectra. | Fibers, grains, collagen, patterned surfaces. | [Estimate anisotropy in a 3D microscopy image](https://scikit-image.org/docs/stable/auto_examples/applications/plot_3d_structure_tensor.html) |
| MEA-12 | Stereological estimation | Estimate quantities such as volume fraction or length density from appropriately sampled sections. | Metallography, histology, porous media, composites. | [3D structure measurements](https://bonej.org/) |
| MEA-13 | Size distributions and weighted summaries | Report number-, area-, or volume-weighted distributions with clear weighting and censoring rules. | Powders, grains, cells, pores, emulsion droplets. | [Particle Distribution Solutions](https://evidentscientific.com/en/landing/microscope-solutions-for-materialography/particle-distribution-solutions) |
| MEA-14 | Fractal and multiscale complexity | Estimate scale-dependent complexity with explicit fitting ranges and sensitivity checks. | Fractures, aggregates, porous structures, biological branching. | [Fractal Analysis](https://gwyddion.net/documentation/user-guide-en/fractal-analysis.html) |
| MEA-15 | Statistical comparison and confidence intervals | Compare specimen-level results using appropriate replication, bootstrap, or hierarchical models. | Assay comparisons, process validation, research studies. | [Measurement process examples](https://www.itl.nist.gov/div898/handbook/mpc/mpc_d.htm) |

### 8. Tracking, motion, and temporal analysis

The [TrackMate documentation](https://imagej.net/plugins/trackmate/) illustrates modular detection, linking, track editing, and trajectory measurements.

| ID | Algorithm or module | Brief summary | Application areas | Ref Link |
| --- | --- | --- | --- | --- |
| TRK-01 | Nearest-neighbor and assignment tracking | Link detected objects across frames using distance gates and linear assignment costs. | Cells, particles, droplets, moving defects. | [Cell and particle tracking](https://imagej.net/plugins/trackmate/) |
| TRK-02 | Kalman and particle-filter tracking | Predict motion and update uncertain states from noisy detections. | Fast particles, sparse trajectories, microfluidics. | [Particle-tracking walkthrough](https://soft-matter.github.io/trackpy/dev/tutorial/walkthrough.html) |
| TRK-03 | Global and network-flow tracking | Optimize trajectories over multiple frames, including missed detections and gap closing. | Crowded cells, long movies, challenging particle tracking. | [Cell and particle tracking](https://imagej.net/plugins/trackmate/) |
| TRK-04 | Lineage and division tracking | Model parent-child relationships and review division, fusion, or ambiguous events. | Cell proliferation, microbial lineages, developmental biology. | [Cell and particle tracking](https://imagej.net/plugins/trackmate/) |
| TRK-05 | Optical flow | Estimate dense or sparse apparent displacement between images. | Tissue motion, cell dynamics, material deformation. | [Registration using optical flow](https://scikit-image.org/docs/stable/auto_examples/registration/plot_opticalflow.html) |
| TRK-06 | Particle image and particle tracking velocimetry | Estimate flow from tracer ensembles or individual tracer trajectories. | Microfluidics, fluid mechanics, biological transport. | [Particle-image velocimetry example](https://openpiv.readthedocs.io/en/latest/src/tutorial1.html) |
| TRK-07 | Kymograph analysis | Convert intensity along a path over time into slopes, events, and transport measurements. | Axonal transport, cilia, moving interfaces, growth fronts. | [TrackMate kymograph example](https://imagej.net/plugins/trackmate/extensions/trackmate-kymograph) |
| TRK-08 | Trajectory statistics and diffusion models | Estimate speed, persistence, mean squared displacement, and diffusion parameters with noise corrections. | Single particles, membrane transport, cell migration. | [Particle-tracking walkthrough](https://soft-matter.github.io/trackpy/dev/tutorial/walkthrough.html) |
| TRK-09 | Motion-state classification | Infer confined, directed, diffusive, or switching behavior using explicit temporal models. | Molecular transport, vesicles, motility studies. | [Single-particle state analysis](https://github.com/bmelinden/vbSPT) |
| TRK-10 | Temporal signal and oscillation analysis | Measure peaks, periods, spectra, autocorrelation, and stimulus-locked responses. | Calcium activity, beating cells, cyclic mechanical response. | [Calcium-imaging analysis](https://caiman.readthedocs.io/en/latest/) |
| TRK-11 | Change-point and event detection | Detect abrupt shifts or onset times with model-based thresholds or statistical tests. | Cell death, phase changes, fracture onset, switching devices. | [Event-driven live-cell imaging](https://pmc.ncbi.nlm.nih.gov/articles/PMC7613693/) |
| TRK-12 | Dynamic boundary and front propagation | Track moving contours and estimate local expansion, erosion, or invasion speeds. | Wound closure, crystal growth, corrosion, solidification. | [Track solidification of a metallic alloy](https://scikit-image.org/docs/stable/auto_examples/applications/plot_solidification_tracking.html) |
| TRK-13 | Track quality and uncertainty scoring | Flag identity switches, implausible motion, missing frames, and low-confidence links for review. | Quantitative migration, automated screening, particle dynamics. | [Cell and particle tracking](https://imagej.net/plugins/trackmate/) |
| TRK-14 | Differential dynamic microscopy | Fit time-dependent image structure functions to estimate population dynamics under an appropriate imaging and motion model. | Colloids, microorganisms, soft matter, transport research. | [DDM flow-dynamics application](https://pmc.ncbi.nlm.nih.gov/articles/PMC8513683/) |
| TRK-15 | Particle-based microrheology | Infer viscoelastic response from calibrated probe motion with thermal, hydrodynamic, and material assumptions. | Gels, polymers, intracellular mechanics, biomaterials. | [Particle microrheology application](https://pmc.ncbi.nlm.nih.gov/articles/PMC4912560/) |

### 9. Volumetric analysis and 3D reconstruction

Use calibrated voxel spacing and distinguish reconstructed intensity volumes, estimated surfaces, and measured topography. An all-in-focus image alone is not a height measurement.

| ID | Algorithm or module | Brief summary | Application areas | Ref Link |
| --- | --- | --- | --- | --- |
| VOL-01 | Z projection and slab extraction | Generate maximum, minimum, mean, sum, percentile, or local-depth projections with recorded rules. | Fluorescence stacks, quick inspection, volumetric review. | [Explore 3D images (of cells)](https://scikit-image.org/docs/stable/auto_examples/applications/plot_3d_image_processing.html) |
| VOL-02 | Orthogonal and oblique reslicing | Sample arbitrary planes or curved paths through a calibrated volume. | Organoids, cross-sectional inspection, tomography. | [Explore 3D images (of cells)](https://scikit-image.org/docs/stable/auto_examples/applications/plot_3d_image_processing.html) |
| VOL-03 | 3D segmentation and labeling | Identify connected volumetric objects and boundaries while accounting for anisotropic sampling. | Cells, pores, inclusions, internal defects. | [Explore 3D images (of cells)](https://scikit-image.org/docs/stable/auto_examples/applications/plot_3d_image_processing.html) |
| VOL-04 | Surface meshing | Extract surfaces using marching-cubes-style methods and controlled mesh repair or simplification. | Morphometry, 3D inspection, export to modeling software. | [Marching Cubes](https://scikit-image.org/docs/stable/auto_examples/edges/plot_marching_cubes.html) |
| VOL-05 | Volumetric morphometry | Measure volume, surface area, sphericity, principal axes, and spatial distributions. | Organoids, particles, voids, reconstructed microstructures. | [Explore and visualize region properties with pandas](https://scikit-image.org/docs/stable/auto_examples/segmentation/plot_regionprops_table.html) |
| VOL-06 | 3D skeletons and topology | Measure branching, connected paths, Euler characteristics, and network properties. | Vasculature, porous media, fibers, neuronal networks. | [3D structure measurements](https://bonej.org/) |
| VOL-07 | Focus-variation surface estimation | Estimate surface height from local focus curves across a calibrated Z stack and reject ambiguous pixels. | Textured machined parts, fracture surfaces, rough specimens. | [Extended-focus specimen example](https://bigwww.epfl.ch/demo/edf/) |
| VOL-08 | Confocal height extraction | Fit axial intensity peaks to estimate surface positions and associated quality values. | Surface metrology, step heights, multilayer interfaces. | [Confocal step-height measurement](https://evidentscientific.com/en/applications/ie-step-measurement-of-transparent-film-applied-to-a-glass-surface) |
| VOL-09 | Stereo reconstruction | Triangulate corresponding points from calibrated viewing geometries. | SEM topography, microscopic assembly, surface reconstruction. | [SEM stereophotogrammetry example](https://pmc.ncbi.nlm.nih.gov/articles/PMC8168440/) |
| VOL-10 | Serial-section volume reconstruction | Align, order, and resample physical sections while tracking missing or distorted sections. | Histology, serial block-face imaging, metallography. | [Large-volume stitching](https://imagej.net/plugins/bigstitcher/) |
| VOL-11 | Pore-network extraction | Reduce segmented void space to pores and throats with connectivity and size measurements. | Batteries, catalysts, filtration, geological samples. | [Pore-network extraction example](https://porespy.org/examples/networks/tutorials/snow_advanced.html) |
| VOL-12 | Surface-to-reference comparison | Register measured surfaces to a nominal shape and map signed deviations without removing relevant errors. | Manufactured parts, optical devices, wear inspection. | [Fitting 3D Shapes](https://gwyddion.net/documentation/user-guide-en/fitting-3d-shapes.html) |
| VOL-13 | Volumetric colocalization and proximity | Measure 3D overlap and distances with resolution-aware interpretation and suitable null models. | Organelle contacts, multimaterial interfaces, spatial biology. | [Colocalization metrics](https://scikit-image.org/docs/stable/auto_examples/applications/plot_colocalization_metrics.html) |

### 10. Computational and quantitative phase microscopy

These methods depend on specific illumination, interferometric, defocus, angular, or wavefront measurements. The original [Fourier ptychographic microscopy paper](https://www.nature.com/articles/nphoton.2013.187) is a reference for angularly diverse intensity reconstruction.

| ID | Algorithm or module | Brief summary | Application areas | Ref Link |
| --- | --- | --- | --- | --- |
| QPI-01 | Transport-of-intensity phase recovery | Estimate phase from calibrated defocus intensity changes under a stated propagation model. | Label-free cells, transparent materials, optical research. | [Cell optical-path measurement](https://pmc.ncbi.nlm.nih.gov/articles/PMC4162510/) |
| QPI-02 | Differential phase contrast reconstruction | Recover phase from asymmetric illumination measurements and calibrated transfer functions. | Live-cell imaging, transparent specimens, computational microscopy. | [Time-lapse DPC application](https://pmc.ncbi.nlm.nih.gov/articles/PMC9110021/) |
| QPI-03 | Off-axis digital holographic reconstruction | Isolate a holographic sideband and recover complex optical fields from an interferogram. | Cell morphology, optical-path measurement, microfluidics. | [Holographic cell-mass study](https://pmc.ncbi.nlm.nih.gov/articles/PMC7809366/) |
| QPI-04 | Multi-height phase retrieval | Recover complex fields iteratively from intensity measurements at multiple propagation distances. | Lensless microscopy, particles, transparent structures. | [Multi-height phase recovery example](https://pmc.ncbi.nlm.nih.gov/articles/PMC5129015/) |
| QPI-05 | Fourier ptychographic reconstruction | Combine images from different illumination angles to estimate complex sample transmission and pupil effects. | Wide-field computational microscopy, pathology research, metrology research. | [Fourier ptychography application](https://pmc.ncbi.nlm.nih.gov/articles/PMC4277232/) |
| QPI-06 | Real-space ptychographic reconstruction | Recover a specimen and illumination probe from overlapping coherent measurements. | Optical, X-ray, and electron computational imaging. | [Live-cell real-space ptychography](https://pmc.ncbi.nlm.nih.gov/articles/PMC3734479/) |
| QPI-07 | Optical diffraction tomography | Reconstruct refractive-index volumes from angularly diverse complex-field measurements. | Label-free cell structure, biomaterials, transparent particles. | [Live-cell refractive-index mapping](https://pmc.ncbi.nlm.nih.gov/articles/PMC2832333/) |
| QPI-08 | Phase unwrapping | Resolve phase discontinuities using quality-guided, branch-cut, least-squares, or temporal methods. | Holography, interferometry, quantitative phase imaging. | [Phase Unwrapping](https://scikit-image.org/docs/stable/auto_examples/filters/plot_phase_unwrap.html) |
| QPI-09 | Phase aberration and background correction | Estimate reference wavefronts, background curvature, or pupil aberrations without erasing specimen signal. | Quantitative phase, holography, optical testing. | [DryMass cell-analysis example](https://pmc.ncbi.nlm.nih.gov/articles/PMC7268593/) |
| QPI-10 | Optical-path and dry-mass estimation | Convert phase to optical-path difference and, with justified refractive assumptions, cellular dry-mass estimates. | Cell growth, biophysics, label-free biotechnology. | [DryMass cell-analysis example](https://pmc.ncbi.nlm.nih.gov/articles/PMC7268593/) |
| QPI-11 | Light-field reconstruction and digital refocusing | Reconstruct depth or refocused images from calibrated microlens or angular measurements. | Fast volumetric imaging, neuroscience, particle fields. | [Neural activity by light-field imaging](https://pmc.ncbi.nlm.nih.gov/articles/PMC9723040/) |
| QPI-12 | Computational adaptive optics | Estimate and compensate wavefront errors using measured or model-based aberrations. | Deep tissue, advanced fluorescence, optical system research. | [Computational adaptive optics](https://pmc.ncbi.nlm.nih.gov/articles/PMC13100136/) |

### 11. Quantitative fluorescence and single-molecule analysis

The [Nikon MicroscopyU fluorescence resources](https://www.microscopyu.com/techniques/fluorescence) introduce acquisition methods, spectral unmixing, colocalization, and interaction measurements. Specialized methods below need their corresponding raw data and controls.

| ID | Algorithm or module | Brief summary | Application areas | Ref Link |
| --- | --- | --- | --- | --- |
| FLU-01 | Compartment fluorescence quantification | Measure corrected signal in nuclei, cytoplasm, membranes, or other segmented regions. | Reporter assays, protein expression, drug screening. | [Measure fluorescence intensity at the nuclear envelope](https://scikit-image.org/docs/stable/auto_examples/applications/plot_fluorescence_nuclear_envelope.html) |
| FLU-02 | Ratiometric fluorescence analysis | Form calibrated ratios with background, crosstalk, and denominator-quality checks. | Ion indicators, pH sensors, biosensors. | [CellProfiler example pipelines](https://cellprofiler.org/examples) |
| FLU-03 | Colocalization statistics | Calculate Pearson, Manders, object-based, or spatial statistics with thresholds and randomization controls. | Organelle relationships, molecular distribution, multiplex assays. | [Colocalization metrics](https://scikit-image.org/docs/stable/auto_examples/applications/plot_colocalization_metrics.html) |
| FLU-04 | FRET efficiency estimation | Estimate energy transfer using corrected intensity ratios, acceptor photobleaching, or donor lifetime data. | Protein interactions, biosensors, structural biology. | [PixFRET application](https://imagej.net/plugins/pixfret) |
| FLU-05 | FRAP recovery modeling | Fit normalized recovery curves with reference regions, bleaching corrections, and suitable kinetic models. | Membrane mobility, diffusion, binding dynamics. | [FRAP recovery analysis](https://imagej.net/plugins/frap-tools) |
| FLU-06 | FLIP and photoactivation analysis | Quantify signal redistribution after controlled bleaching or activation. | Cellular exchange, transport, compartment connectivity. | [Protein-transport FLIP application](https://pmc.ncbi.nlm.nih.gov/articles/PMC3557157/) |
| FLU-07 | Fluorescence lifetime fitting | Estimate lifetimes from time-domain or frequency-domain measurements, including instrument response. | FLIM, metabolic imaging, lifetime-based sensors. | [FLIM analysis example](https://imagej.net/plugins/flimj/) |
| FLU-08 | FLIM phasor analysis | Transform lifetime measurements into phasor coordinates for component interpretation and clustering. | Metabolism, mixed populations, fluorophore environments. | [FLIM analysis example](https://imagej.net/plugins/flimj/) |
| FLU-09 | Fluorescence correlation spectroscopy | Fit temporal correlation curves with geometry, background, and photophysical terms. | Molecular diffusion, concentration, reaction dynamics. | [Imaging FCS application](https://pmc.ncbi.nlm.nih.gov/articles/PMC9382319/) |
| FLU-10 | Number-and-brightness and image correlation | Estimate molecular brightness or dynamics from calibrated temporal fluctuations and spatial correlations. | Protein oligomerization, membrane organization, transport. | [Imaging FCS application](https://pmc.ncbi.nlm.nih.gov/articles/PMC9382319/) |
| FLU-11 | Single-emitter localization | Fit Gaussian or measured PSF models to estimate emitter coordinates and localization uncertainty. | PALM, STORM, single-particle measurements. | [ThunderSTORM localization example](https://zitmen.github.io/thunderstorm/) |
| FLU-12 | 3D and multi-emitter localization | Fit overlapping or engineered PSFs using calibrated axial models and appropriate noise likelihoods. | Dense localization microscopy, 3D molecular mapping. | [ThunderSTORM localization example](https://zitmen.github.io/thunderstorm/) |
| FLU-13 | Localization drift and blinking correction | Correct coordinate drift and assess repeated detections from emitter blinking. | Single-molecule reconstruction, quantitative molecule studies. | [ThunderSTORM localization example](https://zitmen.github.io/thunderstorm/) |
| FLU-14 | Localization rendering and clustering | Render localization lists and measure clusters with uncertainty and labeling-density checks. | Nanoscale membrane organization, molecular assemblies. | [ThunderSTORM localization example](https://zitmen.github.io/thunderstorm/) |
| FLU-15 | Structured illumination reconstruction | Reconstruct SIM data from calibrated pattern phases, orientations, and optical transfer functions. | Super-resolution fluorescence, live-cell structural research. | [SIM reconstruction examples](https://github.com/fairSIM/fairSIM) |
| FLU-16 | Fluctuation-based reconstruction | Use temporal cumulants or radial fluctuation models to reconstruct structure and quantify artifacts. | SOFI-like imaging, fluorescence method development. | [3D SOFI application](https://pmc.ncbi.nlm.nih.gov/articles/PMC2799731/) |
| FLU-17 | Resolution and reconstruction quality checks | Estimate Fourier correlation, localization precision, artifacts, and reference consistency using method-appropriate controls. | Super-resolution validation, imaging-core quality assurance. | [Resolution-check example](https://imagej.net/plugins/fourier-ring-correlation) |

### 12. Spectral, chemical, and polarization microscopy

These modules process measured spectra or polarization states. Chemical identification needs suitable reference libraries, calibration, and discrimination between plausible alternatives.

| ID | Algorithm or module | Brief summary | Application areas | Ref Link |
| --- | --- | --- | --- | --- |
| SPC-01 | Spectral axis and response calibration | Correct wavelength or wavenumber axes and detector response using reference measurements. | Raman, FTIR, hyperspectral fluorescence, reflectance. | [Built-in protocols](https://ramanspy.readthedocs.io/en/latest/auto_tutorials/v-preprocessing/plot_iv_predefined_pipeline.html) |
| SPC-02 | Spectral baseline and spike correction | Remove modeled backgrounds and cosmic-ray spikes while retaining narrow real peaks. | Raman maps, chemical imaging, materials spectroscopy. | [Built-in methods](https://ramanspy.readthedocs.io/en/latest/auto_tutorials/v-preprocessing/plot_i_predefined_methods.html) |
| SPC-03 | Spectral smoothing and normalization | Apply Savitzky-Golay or other controlled smoothing and physically appropriate normalization. | Spectral classification, comparison across measurements. | [Built-in methods](https://ramanspy.readthedocs.io/en/latest/auto_tutorials/v-preprocessing/plot_i_predefined_methods.html) |
| SPC-04 | Peak detection and spectral fitting | Fit peak locations, widths, areas, and overlapping components with residual and uncertainty checks. | Chemical mapping, stress-sensitive Raman peaks, phase identification. | [Cell phenotyping](https://ramanspy.readthedocs.io/en/latest/auto_examples/plot_i_package_overview.html) |
| SPC-05 | Reference-based spectral unmixing | Estimate component contributions using nonnegative or constrained mixture models. | Multiplex fluorescence, chemical mixtures, autofluorescence removal. | [Built-in unmixing methods](https://ramanspy.readthedocs.io/en/latest/auto_tutorials/vi-analysis/plot_iii_unmixing.html) |
| SPC-06 | Blind source separation | Use PCA, ICA, NMF, or multivariate curve resolution to explore mixed spectral signals. | Hyperspectral discovery, materials mixtures, tissue imaging. | [Built-in decomposition methods](https://ramanspy.readthedocs.io/en/latest/auto_tutorials/vi-analysis/plot_i_decomposition.html) |
| SPC-07 | Spectral library matching | Compare calibrated spectra using correlation, spectral angle, or model-based distances. | Contaminant identification, polymers, minerals, microplastics. | [Loading the RRUFF dataset](https://ramanspy.readthedocs.io/en/latest/auto_tutorials/iii-datasets/ii_rruff.html) |
| SPC-08 | Chemometric prediction | Predict composition or properties from validated regression or classification models. | Pharmaceutical particles, process monitoring, material identification. | [Integrative analysis: Support Vector Machine (SVM) classification](https://ramanspy.readthedocs.io/en/latest/auto_tutorials/vi-analysis/plot_iv_integrative_svm.html) |
| SPC-09 | Raman and FTIR chemical maps | Convert per-pixel spectra into peak, component, or class maps with spatial quality masks. | Drug formulation, biomaterials, semiconductors, contamination. | [Microplastic chemical mapping](https://www.renishaw.com/en/study-polymers-and-microplastics-with-raman-spectroscopy--25887) |
| SPC-10 | Stokes and Mueller matrix reconstruction | Recover polarization descriptors from calibrated analyzer and illumination states. | Optical coatings, anisotropic materials, polarization research. | [Tissue Mueller-matrix application](https://pmc.ncbi.nlm.nih.gov/articles/PMC8390965/) |
| SPC-11 | Retardance and birefringence mapping | Estimate retardance and optic-axis orientation from calibrated polarized measurements. | Polymers, crystals, collagen, glass stress. | [Quantitative retardance imaging](https://pmc.ncbi.nlm.nih.gov/articles/PMC6484989/) |
| SPC-12 | Polarization texture and domain analysis | Quantify angular response, domains, and orientation from rotating-polarizer or equivalent datasets. | Mineralogy, liquid crystals, metallurgy, optical devices. | [Tissue Stokes imaging example](https://pmc.ncbi.nlm.nih.gov/articles/PMC5695942/) |
| SPC-13 | Nonlinear optical signal analysis | Quantify measured SHG, THG, or coherent Raman images using modality-specific interpretation. | Collagen, crystal organization, label-free tissue, nonlinear optics. | [Targeted collagen imaging](https://pycro-manager.readthedocs.io/en/latest/application_notebooks/guiding_acq_with_neural_network_attention.html) |

### 13. Cell, microbial, and biotechnology assays

These are application analysis modules built from the shared methods above. The [CellProfiler example pipelines](https://cellprofiler.org/examples) provide practical examples of cell measurements and image-based assays.

| ID | Algorithm or module | Brief summary | Application areas | Ref Link |
| --- | --- | --- | --- | --- |
| BIO-01 | Cell and nucleus counting | Segment individual cells or nuclei and report counts, density, and exclusion reasons. | Cell culture, proliferation, assay normalization. | [CellProfiler example pipelines](https://cellprofiler.org/examples) |
| BIO-02 | Culture confluence estimation | Estimate the fraction of the valid culture area covered by cells and track it over time. | Bioprocessing, culture monitoring, treatment response. | [CellProfiler example pipelines](https://cellprofiler.org/examples) |
| BIO-03 | Viability and cytotoxicity analysis | Classify cells from validated live/dead indicators and report counts or assay-specific ratios. | Drug discovery, biomaterials, manufacturing quality. | [High-content assay examples](https://documents.thermofisher.com/TFS-Assets/BID/Reference-Materials/high-content-imaging-analysis-software-fluorescent-labels-bioprobes-77-article.pdf) |
| BIO-04 | Proliferation and cell-cycle analysis | Quantify divisions, incorporation markers, or calibrated DNA-content distributions. | Oncology research, cell biology, screening. | [High-content assay examples](https://documents.thermofisher.com/TFS-Assets/BID/Reference-Materials/high-content-imaging-analysis-software-fluorescent-labels-bioprobes-77-article.pdf) |
| BIO-05 | Apoptosis and cell-death phenotyping | Combine morphology and appropriate markers to classify defined death-related phenotypes. | Toxicology, therapeutic screening, stress-response research. | [Imaging apoptosis application](https://www.thermofisher.com/de/en/home/references/newsletters-and-journals/bioprobes-journal-of-cell-biology-applications/bioprobes-issues-2011/bioprobes-64-april-2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) |
| BIO-06 | Nuclear translocation | Measure nuclear-to-cytoplasmic signal ratios after compartment segmentation. | Signaling pathways, receptor activation, drug screening. | [CellProfiler example pipelines](https://cellprofiler.org/examples) |
| BIO-07 | Organelle morphology and distribution | Quantify mitochondrial, lysosomal, Golgi, or other labeled structures and spatial organization. | Cell health, metabolism, mechanism studies. | [Mitochondrial network analysis](https://imagej.net/plugins/mina) |
| BIO-08 | Puncta, foci, and aggregate analysis | Detect and measure labeled spots, count per-cell objects, and distinguish diffuse signal. | DNA damage, autophagy, protein aggregation, infection. | [CellProfiler example pipelines](https://cellprofiler.org/examples) |
| BIO-09 | Cell painting and morphological profiling | Aggregate multichannel shape, texture, and intensity features into normalized perturbation profiles. | Phenotypic screening, mechanism discovery, compound comparison. | [Cell Painting profiling application](https://www.broadinstitute.org/publications/broad10406) |
| BIO-10 | Wound-healing and migration analysis | Measure gap closure, boundary motion, and optionally individual trajectories. | Motility, tissue repair, cancer research. | [CellProfiler example pipelines](https://cellprofiler.org/examples) |
| BIO-11 | Invasion and chemotaxis analysis | Quantify directed migration and penetration into defined matrices or gradients. | Immunology, metastasis research, microfluidic assays. | [3D chemotaxis assay workflow](https://pmc.ncbi.nlm.nih.gov/articles/PMC6909357/) |
| BIO-12 | Colony and clonogenic analysis | Detect colonies and measure number, area, growth, and assay-specific survival fractions. | Microbiology, radiation biology, cell manufacturing. | [CellProfiler example pipelines](https://cellprofiler.org/examples) |
| BIO-13 | Microbial morphology and growth | Measure cell dimensions, growth rates, division timing, and filamentation in supported contrast modes. | Antibiotic research, fermentation, synthetic biology. | [Bacterial growth and lineage analysis](https://pmc.ncbi.nlm.nih.gov/articles/PMC8797229/) |
| BIO-14 | Biofilm structure analysis | Quantify biovolume, thickness, coverage, roughness, and labeled subpopulations in 3D. | Infection research, industrial fouling, environmental microbiology. | [Biofilm quantification examples](https://drescherlab.org/data/biofilmQ/) |
| BIO-15 | Spheroid and organoid analysis | Measure size, shape, viable regions, lumen structure, and longitudinal growth. | Drug response, developmental biology, tissue engineering. | [Gastruloid image-analysis example](https://github.com/fmi-basel/gliberal-gastruloid-2023-methods) |
| BIO-16 | Calcium and voltage activity extraction | Extract motion-corrected signals, events, and population activity from suitable indicators. | Neuroscience, cardiac research, functional screening. | [Calcium-imaging analysis](https://caiman.readthedocs.io/en/latest/) |
| BIO-17 | Comet and micronucleus assays | Measure DNA-damage-related tail features or micronuclei with explicit scoring rules. | Genotoxicity research, toxicology, biotechnology. | [CellProfiler example pipelines](https://cellprofiler.org/examples) |
| BIO-18 | Infection and intracellular pathogen burden | Associate pathogen signals with host cells and quantify infection fractions or burden. | Virology, parasitology, antimicrobial screening. | [Bioimage benchmark examples](https://bbbc.broadinstitute.org/) |
| BIO-19 | In situ hybridization spot analysis | Detect transcript or probe signals and assign them to cells, nuclei, or tissue regions. | Gene-expression research, FISH, spatial biology. | [Spatial cell-neighborhood example](https://squidpy.readthedocs.io/en/stable/notebooks/tutorials/tutorial_vizgen.html) |

### 14. Tissue, histology, and organism analysis

The [QuPath documentation](https://qupath.readthedocs.io/en/stable/index.html) covers whole-slide regions, stain separation, cell detection, classification, and multiplexed analysis. Research analysis modules need additional task-specific validation before clinical use.

| ID | Algorithm or module | Brief summary | Application areas | Ref Link |
| --- | --- | --- | --- | --- |
| TIS-01 | Tissue detection and artifact masking | Separate specimen from glass and flag folds, pen marks, blur, bubbles, or torn tissue. | Whole-slide research, automated slide quality control. | [Detecting tissue](https://qupath.readthedocs.io/en/stable/docs/tutorials/thresholding.html) |
| TIS-02 | Stain separation and normalization | Estimate stain contributions from optical-density images and harmonize defined acquisition variation. | Brightfield histology, immunohistochemistry research. | [Separating stains](https://qupath.readthedocs.io/en/stable/docs/tutorials/separating_stains.html) |
| TIS-03 | Positive-cell and positive-area scoring | Measure marker-positive cell fractions or stained area using assay-specific controls and thresholds. | Biomarker research, pathology studies, tissue screening. | [Cell detection](https://qupath.readthedocs.io/en/stable/docs/tutorials/cell_detection.html) |
| TIS-04 | Tissue compartment segmentation | Identify defined tissue regions, glands, vessels, stroma, or necrotic areas. | Tissue morphometry, oncology research, organ studies. | [Pixel classification](https://qupath.readthedocs.io/en/stable/docs/tutorials/pixel_classification.html) |
| TIS-05 | Multiplex cell phenotyping | Combine cell-level marker measurements into reviewed phenotype rules or trained classifiers. | Immunology, spatial proteomics, tumor microenvironment research. | [Multiplexed analysis](https://qupath.readthedocs.io/en/stable/docs/tutorials/multiplex_analysis.html) |
| TIS-06 | Spatial neighborhood and interaction analysis | Relate cell phenotypes to local composition, distance, and compartment context. | Spatial biology, immuno-oncology research. | [Spatial cell-neighborhood example](https://squidpy.readthedocs.io/en/stable/notebooks/tutorials/tutorial_vizgen.html) |
| TIS-07 | Collagen and extracellular matrix analysis | Quantify fiber orientation, thickness, density, and organization in supported contrast modes. | Fibrosis research, wound repair, biomaterials. | [Fiber orientation examples](https://bigwww.epfl.ch/demo/orientation/) |
| TIS-08 | Neurite tracing and Sholl analysis | Reconstruct neuronal processes and measure length, branching, and radial intersections. | Neurodevelopment, neurotoxicity, regeneration studies. | [Neuronal branching analysis](https://imagej.net/plugins/sholl-analysis) |
| TIS-09 | Synapse and dendritic spine analysis | Detect labeled synapses or spines and measure density, morphology, or longitudinal changes. | Neuroscience, plasticity research, advanced fluorescence. | [Dendritic spine analysis](https://imagej.net/plugins/spot-spine) |
| TIS-10 | Vascular and angiogenesis analysis | Segment vascular networks and measure length, branching, coverage, and sprouting. | Drug development, tissue engineering, cancer research. | [Vessel-formation assay analysis](https://pmc.ncbi.nlm.nih.gov/articles/PMC7360583/) |
| TIS-11 | Embryo and developmental lineage analysis | Track cells and anatomical landmarks across time with lineage and stage annotations. | Developmental biology, model organisms, morphogenesis. | [Cell and particle tracking](https://imagej.net/plugins/trackmate/) |
| TIS-12 | Small-organism pose and behavior | Estimate posture, locomotion, trajectories, and stimulus responses for defined organisms. | C. elegans, zebrafish, toxicology, behavioral research. | [Worm phenotyping examples](https://cellprofiler.org/wormtoolbox) |
| TIS-13 | Plant tissue and stomatal analysis | Measure stomata, cell walls, leaf structure, or labeled subcellular features. | Plant science, agriculture, environmental research. | [Stomata analysis example](https://github.com/Milo-L/StomataQuant) |
| TIS-14 | Clearing and expansion microscopy analysis | Reconstruct large labeled volumes and apply measured clearing or expansion corrections. | Brain mapping, tissue architecture, high-resolution biological research. | [Expanded-cell ultrastructure study](https://pmc.ncbi.nlm.nih.gov/articles/PMC6314451/) |

### 15. Semiconductor wafers, lithography, and photomasks

Optical microscopy supports optically resolvable features and defect screening. Nanoscale dimensional work may require SEM, AFM, scatterometry, or other qualified metrology. The [ZEISS semiconductor application overview](https://www.zeiss.com/microscopy/us/applications/semiconductors-electronics.html) provides context for the range of inspection modalities.

| ID | Algorithm or module | Brief summary | Application areas | Ref Link |
| --- | --- | --- | --- | --- |
| SEMI-01 | Wafer, notch, and die-grid alignment | Locate the wafer outline, orientation features, and die lattice to establish inspection coordinates. | Wafer inspection, review navigation, automated mapping. | [Automated wafer inspection](https://www.zeiss.com/microscopy/en/l/great-britain/campaigns/2025/unlocking-innovation-ai-and-automation-in-wafer-solutions.html) |
| SEMI-02 | Die-to-die defect comparison | Compare registered repeated dies while modeling normal intensity and process variation. | Repeating pattern inspection, process monitoring. | [Automated wafer inspection](https://www.zeiss.com/microscopy/en/l/great-britain/campaigns/2025/unlocking-innovation-ai-and-automation-in-wafer-solutions.html) |
| SEMI-03 | Image-to-design comparison | Register measured features to rasterized layout data through a suitable imaging model. | Photomasks, lithography, patterned-device inspection. | [Mask defect qualification](https://www.zeiss.com/semiconductor-manufacturing-technology/products/photomask-solutions/mask-qualification.html) |
| SEMI-04 | Repeating-pattern self-reference | Build local or robust references from repeated cells when a separate defect-free image is unavailable. | Memory arrays, gratings, periodic semiconductor structures. | [Mask defect qualification](https://www.zeiss.com/semiconductor-manufacturing-technology/products/photomask-solutions/mask-qualification.html) |
| SEMI-05 | Critical dimension measurement | Estimate line, space, contact, or feature dimensions using calibrated, modality-specific edge models. | Lithography, etching, process control. | [CD-SEM dimensional analysis](https://www.hitachi-hightech.com/us/en/products/advanced-analytical/microscopy/cdsem.html) |
| SEMI-06 | Pitch and periodicity measurement | Estimate repeated-feature spacing using spectral, correlation, or edge-location methods. | Gratings, interconnect arrays, lithographic patterns. | [CD-SEM dimensional analysis](https://www.hitachi-hightech.com/us/en/products/advanced-analytical/microscopy/cdsem.html) |
| SEMI-07 | Overlay and alignment error | Measure relative displacement between designated layer marks or structures. | Multilayer lithography, wafer bonding, alignment process control. | [Mask registration metrology](https://www.zeiss.com/semiconductor-manufacturing-technology/products/photomask-solutions/mask-metrology.html) |
| SEMI-08 | Line-edge and line-width roughness | Analyze edge-position fluctuations with stated bandwidth, sampling, noise correction, and detrending. | Resist development, etch quality, nanoscale SEM metrology. | [CD-SEM dimensional analysis](https://www.hitachi-hightech.com/us/en/products/advanced-analytical/microscopy/cdsem.html) |
| SEMI-09 | Opens, bridges, and pattern topology | Detect connectivity errors and deviations in extracted line or space networks. | Interconnects, masks, patterned conductors. | [Mask defect qualification](https://www.zeiss.com/semiconductor-manufacturing-technology/products/photomask-solutions/mask-qualification.html) |
| SEMI-10 | Contact and via geometry | Measure diameter, ellipticity, placement, spacing, and missing or merged features. | Via fabrication, contact arrays, advanced packaging. | [CD-SEM dimensional analysis](https://www.hitachi-hightech.com/us/en/products/advanced-analytical/microscopy/cdsem.html) |
| SEMI-11 | Particle and contamination inspection | Detect surface particles and stains, then classify size, appearance, and location. | Wafer cleanliness, process contamination, yield studies. | [Automated wafer inspection](https://www.zeiss.com/microscopy/en/l/great-britain/campaigns/2025/unlocking-innovation-ai-and-automation-in-wafer-solutions.html) |
| SEMI-12 | Scratch, pit, and edge-chip inspection | Segment elongated damage, depressions, and boundary loss across defined wafer regions. | Wafer handling, polishing, incoming material inspection. | [Automated wafer inspection](https://www.zeiss.com/microscopy/en/l/great-britain/campaigns/2025/unlocking-innovation-ai-and-automation-in-wafer-solutions.html) |
| SEMI-13 | Etch and deposition uniformity maps | Aggregate measured feature or surface properties across dies and wafer coordinates. | Process development, chamber matching, uniformity studies. | [Optical CD and film metrology](https://www.zeiss.com/spectroscopy/applications-industries/oem-applications/semiconductor.html) |
| SEMI-14 | Focus-exposure matrix analysis | Measure feature quality and dimensions across programmed focus and exposure conditions. | Lithography process-window characterization. | [Mask defect qualification](https://www.zeiss.com/semiconductor-manufacturing-technology/products/photomask-solutions/mask-qualification.html) |
| SEMI-15 | Photomask defect classification | Classify missing or extra absorber, pinholes, edge defects, and contamination at supported resolution. | Mask manufacturing, mask qualification, repair review. | [Mask defect qualification](https://www.zeiss.com/semiconductor-manufacturing-technology/products/photomask-solutions/mask-qualification.html) |
| SEMI-16 | Wafer-map spatial pattern analysis | Detect rings, scratches, edge concentrations, clusters, or repeating signatures in mapped results. | Yield engineering, equipment fault investigation. | [Automated wafer inspection](https://www.zeiss.com/microscopy/en/l/great-britain/campaigns/2025/unlocking-innovation-ai-and-automation-in-wafer-solutions.html) |
| SEMI-17 | Crystal and epitaxial defect mapping | Detect modality-visible pits, stacking-fault signatures, dislocations, or surface defects with validated labels. | SiC, GaN, compound semiconductors, substrate development. | [Etched-SiC defect inspection](https://evidentscientific.com/en/applications/defect-detection-on-etched-silicon-carbide-sic-wafers) |
| SEMI-18 | Site-specific defect relocation | Transfer defect coordinates between inspection, review, and sample-preparation instruments. | Root-cause analysis, SEM review, FIB cross-section targeting. | [Correlative semiconductor failure analysis](https://www.zeiss.com/microscopy/us/applications/semiconductors-electronics/failure-analysis-3d-characterization.html) |

### 16. Electronics packaging, PCBs, and displays

Combine optical inspection with measured height, X-ray, or acoustic data when buried geometry matters. A surface image cannot establish internal connectivity or hidden void content.

| ID | Algorithm or module | Brief summary | Application areas | Ref Link |
| --- | --- | --- | --- | --- |
| ELE-01 | Solder joint and fillet inspection | Measure visible solder shape, wetting-related geometry, bridges, and insufficient or excess material. | PCB assembly, electronics manufacturing. | [Solder and flux inspection](https://evidentscientific.com/en/landing/microscope-solutions-for-pcb-manufacturing/pasting-the-solder-on-the-pcb) |
| ELE-02 | Bump and ball geometry analysis | Measure bump diameter, spacing, coplanarity, and height where suitable 3D measurements exist. | Flip-chip, BGA, advanced packaging. | [Advanced packaging inspection](https://evidentscientific.com/en/solutions/advanced-packaging-inspection) |
| ELE-03 | Wire bond inspection | Detect wires and bonds, measure placement and visible deformation, and analyze loops from 3D data. | Semiconductor packaging, power electronics. | [Wire-loop height measurement](https://evidentscientific.com/en/applications/ie-loop-height-measurement-for-wire-bonding) |
| ELE-04 | Die placement and bond-line analysis | Measure die offset, rotation, edge gaps, and visible adhesive or bond-line geometry. | Die attach, packaging, microassembly. | [Advanced packaging inspection](https://evidentscientific.com/en/solutions/advanced-packaging-inspection) |
| ELE-05 | Package delamination and internal void analysis | Segment internal anomalies from appropriate X-ray or acoustic datasets and map affected regions. | Package reliability, wafer bonding, failure analysis. | [Package acoustic inspection](https://calce.umd.edu/scanning-acoustic-microscopy-sam) |
| ELE-06 | PCB trace and pad metrology | Measure line widths, clearances, pad geometry, and visible conductor discontinuities. | PCB manufacturing, flexible circuits, process inspection. | [Flexible-PCB wiring inspection](https://evidentscientific.com/en/applications/ie-wiring-inspections-for-flexible-printed-circuit-boards-pcbs) |
| ELE-07 | Plated-hole and cross-section analysis | Measure plating thickness, annular geometry, cracks, and voids on prepared sections. | PCB quality, connectors, reliability studies. | [Using Image Analysis Software to Measure Throwing Power or PCB Copper Plating Thickness Uniformity](https://evidentscientific.com/en/applications/ie-using-image-analysis-software-to-measure-throwing-power-or-pcb-copper-plating-thickness-uniformity) |
| ELE-08 | Component presence and orientation | Compare assemblies with a reference and read supported markings or polarity cues. | Automated optical inspection, assembly verification. | [PCB inspection examples](https://www.leica-microsystems.com/applications/industrial-microscopy-markets/electronics-semiconductor/pcb-inspection/) |
| ELE-09 | Connector and contact inspection | Detect contamination, bent pins, wear, plating loss, or alignment errors. | Electronics, automotive connectors, precision contacts. | [PCB inspection examples](https://www.leica-microsystems.com/applications/industrial-microscopy-markets/electronics-semiconductor/pcb-inspection/) |
| ELE-10 | MEMS geometry and motion | Measure microstructure dimensions, displacement, stiction, and dynamic response with suitable data. | Sensors, actuators, microfabrication research. | [MEMS surface metrology](https://www.zygo.com/applications/what-we-measure/mems) |
| ELE-11 | Display pixel and subpixel inspection | Detect dead, stuck, miscolored, or malformed pixels from calibrated lit and unlit images. | LCD, OLED, microLED, display manufacturing. | [MicroLED defect metrology](https://www.radiantvisionsystems.com/learn/presentations/metrology-and-quality-control-microled-displays) |
| ELE-12 | Display uniformity and mura analysis | Map luminance and chromatic variation after calibrated imaging and spatial correction. | Display panels, microdisplays, LED arrays. | [MicroLED uniformity example](https://www.radiantvisionsystems.com/learn/white-papers/measuring-and-correcting-microled-display-uniformity) |
| ELE-13 | LED and microLED placement | Measure device position, rotation, pitch, missing elements, and transfer defects. | MicroLED transfer, photonic assembly, semiconductor packaging. | [MicroLED defect metrology](https://www.radiantvisionsystems.com/learn/presentations/metrology-and-quality-control-microled-displays) |
| ELE-14 | Correlative electrical failure localization | Overlay optical or thermal emission and electrical-test coordinates with structural images. | Semiconductor failure analysis, reliability engineering. | [Correlative semiconductor failure analysis](https://www.zeiss.com/microscopy/us/applications/semiconductors-electronics/failure-analysis-3d-characterization.html) |

### 17. Metallography and materials microstructure

Preparation, etching, field selection, and counting rules strongly affect results. [ASTM E112](https://store.astm.org/e0112-13.html) addresses planar average grain size, while [ASTM E1382](https://store.astm.org/standards/e1382) addresses semiautomatic and automatic image analysis. Implement the applicable purchased standard and edition when a standards-based result is required; the summaries here do not reproduce its full procedure.

| ID | Algorithm or module | Brief summary | Application areas | Ref Link |
| --- | --- | --- | --- | --- |
| MAT-01 | Grain boundary and grain segmentation | Delineate grains from etched, polarized, or orientation-sensitive measurements and handle ambiguous boundaries. | Metals, ceramics, microstructure research. | [Grain Size Solutions](https://evidentscientific.com/en/landing/microscope-solutions-for-materialography/grain-size-solutions) |
| MAT-02 | Intercept grain-size analysis | Count grain intersections along defined test lines and estimate mean intercept statistics. | Metallurgical quality, heat-treatment studies, grain-size testing. | [Evaluation of Steel Grain Size](https://evidentscientific.com/en/applications/ie-evaluation-of-steel-grain-size) |
| MAT-03 | Planimetric grain-size analysis | Count grains within calibrated areas using appropriate boundary rules and convert to specified size measures. | Metallography, process qualification, grain growth. | [Evaluation of Steel Grain Size](https://evidentscientific.com/en/applications/ie-evaluation-of-steel-grain-size) |
| MAT-04 | Grain-size distribution and duplex structures | Characterize individual grain sizes, mixed populations, and unusually coarse grains. | Recrystallization, abnormal grain growth, alloy development. | [Grain Size Solutions](https://evidentscientific.com/en/landing/microscope-solutions-for-materialography/grain-size-solutions) |
| MAT-05 | Phase and constituent fraction analysis | Estimate segmented area fractions or point-count fractions with appropriate sampling interpretation. | Multiphase alloys, ceramics, heat-treatment research. | [Phase Analysis Solutions](https://evidentscientific.com/en/landing/microscope-solutions-for-materialography/phase-analysis-solutions) |
| MAT-06 | Nonmetallic inclusion analysis | Measure inclusion size, shape, distribution, and method-specific ratings; add chemistry from suitable measurements. | Steel cleanliness, bearing steels, fatigue studies. | [Nonmetallic Inclusion Analysis in Steel](https://ims.evidentscientific.com/en/applications/nonmetallic-inclusion-analysis-in-steel) |
| MAT-07 | Graphite morphology analysis | Quantify graphite nodularity, form, size, count, and area fraction using defined classification rules. | Ductile, gray, and compacted graphite cast irons. | [Evaluation of spheroidal graphite cast iron](https://evidentscientific.com/en/applications/ie-evaluation-of-spheroidal-graphite-cast-iron) |
| MAT-08 | Porosity and void fraction | Measure pore areas or volumes, shapes, distributions, and connectivity for the available data. | Castings, sintered parts, additive manufacturing. | [Porosity Analysis Solutions](https://evidentscientific.com/en/landing/microscope-solutions-for-materialography/porosity-analysis-solutions) |
| MAT-09 | Dendrite arm spacing | Measure primary or secondary dendrite spacing using directional and geometric analysis. | Cast alloys, solidification studies, process development. | [Dendrite Arm Spacing Solutions](https://evidentscientific.com/en/landing/microscope-solutions-for-materialography/dendrite-arm-s-spacing-solutions) |
| MAT-10 | Lamellar and interphase spacing | Estimate feature spacing from calibrated line profiles, orientation, or frequency analysis. | Pearlite, eutectics, layered microstructures. | [Automated pearlite-spacing analysis](https://pmc.ncbi.nlm.nih.gov/articles/PMC12898790/) |
| MAT-11 | Precipitate and carbide morphometry | Measure visible particle distributions and morphology; separate phase identity from image appearance. | Alloy aging, tool steels, superalloys. | [Nickel-alloy carbide measurements](https://www.clemex.com/wp-content/uploads/2019/07/673-carbides-analysis-in-nickel-based-alloy.pdf) |
| MAT-12 | Banding and microstructural anisotropy | Quantify directional segregation or constituent distributions with sampling-aware orientation statistics. | Rolled steels, forged alloys, process optimization. | [Steel banding application](https://www.clemex.com/applications/astm-e1268-banding-analysis) |
| MAT-13 | Coating and layer thickness | Measure local normal thickness on prepared sections and summarize variation and discontinuities. | Plating, thermal spray, multilayer coatings, corrosion protection. | [Layer/Coating Thickness Measurement Solutions](https://evidentscientific.com/en/landing/microscope-solutions-for-materialography/layer-coating-thickness-measurement-solutions) |
| MAT-14 | Case depth and decarburization | Measure affected zones from validated microstructural or hardness criteria and report method dependence. | Carburizing, nitriding, heat-treatment quality. | [Steel decarburization example](https://www.clemex.com/applications/depth-of-decarburization-of-steel-as-per-astm-e1077) |
| MAT-15 | Weld and heat-affected-zone analysis | Segment weld regions and measure penetration, inclusions, cracks, porosity, and local structure. | Welding development, joining quality, failure analysis. | [Measuring Weld Throat Thickness with EVIDENT Stream Image Analysis Software](https://ims.evidentscientific.com/en/applications/ie-measuring-weld-throat-thickness-with-evident-stream-image-analysis-software) |
| MAT-16 | Crack and fracture morphometry | Measure crack length, branching, opening, surface texture, or fracture features visible in the selected modality. | Fatigue, brittle fracture, structural reliability. | [Fractured-metal surface analysis](https://ims.evidentscientific.com/en/applications/analyzing-fractured-metal-surfaces) |
| MAT-17 | Corrosion and pitting analysis | Quantify affected area, pit geometry, depth from measured topography, and progression over time. | Coating development, alloys, environmental durability. | [Corrosion microscopy examples](https://adobeassets.evidentscientific.com/content/dam/downloads/276829919/AOM_compendium_II_final.pdf) |
| MAT-18 | Additive-manufacturing microstructure | Measure melt-pool geometry, lack-of-fusion signatures, inclusions, pores, and directional structures. | Metal printing, build qualification, process research. | [Additive-manufacturing microscopy](https://asset-downloads.zeiss.com/catalogs/download/mic/9a2b3b52-84cc-45a1-8b82-9244ba959ce4/EN_wp_Applications_of_microscopy_in_additive_manufacturing.pdf) |
| MAT-19 | Fiber and composite analysis | Quantify reinforcement fraction, orientation, spacing, porosity, and interface damage. | Composites, aerospace materials, polymer reinforcement. | [Estimate anisotropy in a 3D microscopy image](https://scikit-image.org/docs/stable/auto_examples/applications/plot_3d_structure_tensor.html) |
| MAT-20 | Microhardness indent measurement | Locate suitable Vickers or Knoop indent corners and calculate hardness using force and prescribed geometry. | Heat treatment, weld maps, case-depth studies. | [Automated microhardness mapping](https://www.clemex.com/software/automated-hardness-testing-cmt) |

### 18. Optical components, fibers, and photonic devices

Surface imperfection specifications and fiber inspection rules depend on the chosen standard and product. See [ISO 10110-7](https://committee.iso.org/standard/65444.html?browse=tc) for optical surface imperfection notation and [IEC 61300-3-35](https://webstore.iec.ch/en/publication/64254) for fiber-end inspection. Visual inspection complements optical performance measurements.

| ID | Algorithm or module | Brief summary | Application areas | Ref Link |
| --- | --- | --- | --- | --- |
| OPT-01 | Scratch, pit, and dig detection | Detect and measure localized surface imperfections under controlled illumination and magnification. | Lenses, mirrors, windows, precision optics. | [Surface quality inspection example](https://www.edmundoptics.com/knowledge-center/application-notes/lasers/understanding-surface-quality-specifications) |
| OPT-02 | Specification-based surface grading | Apply product-specific area or visibility grading with calibrated references; retain the chosen grading system. | Optical acceptance, supplier inspection, coated optics. | [Surface quality inspection example](https://www.edmundoptics.com/knowledge-center/application-notes/lasers/understanding-surface-quality-specifications) |
| OPT-03 | Coating defect inspection | Detect pinholes, peeling, stains, discoloration, and local reflectance or transmission variation. | Antireflection coatings, mirrors, filters, optical windows. | [Optical coating applications](https://www.edmundoptics.com/capabilities/precision-optics/capabilities/optical-coatings/) |
| OPT-04 | Edge chip and bevel measurement | Measure chip extent, edge continuity, and bevel geometry in defined inspection regions. | Lens manufacture, prisms, precision glass. | [Surface quality inspection example](https://www.edmundoptics.com/knowledge-center/application-notes/lasers/understanding-surface-quality-specifications) |
| OPT-05 | Bubbles, inclusions, and striae analysis | Detect internal features with suitable transmission or phase-sensitive acquisition and report visibility limits. | Optical glass, crystals, polymer optics. | [Optical glass inclusions and bubbles](https://www.edmundoptics.com/knowledge-center/application-notes/lasers/homogeneity-and-scatter-from-inclusions-and-bubbles/) |
| OPT-06 | Microlens array metrology | Measure lenslet pitch, aperture, placement, missing elements, and height or form from suitable 3D data. | Imaging arrays, illumination optics, wafer-level optics. | [Microlens array measurement](https://www.zygo.com/applications/what-we-measure/micro-lenses) |
| OPT-07 | Fiber end-face inspection | Locate fibers and ferrules, classify contamination and scratches, and evaluate configured inspection zones. | Telecom connectors, transceivers, fiber assemblies. | [Fiber-end inspection example](https://www.flukenetworks.com/blog/cabling-chronicles/your-fiber-end-face-scratch) |
| OPT-08 | Fiber geometry and alignment | Measure core and cladding geometry, concentricity, or splice alignment from suitable calibrated contrast. | Fiber manufacture, splicing, photonic packaging. | [Fiber connector geometry](https://www.flukenetworks.com/edocs/white-paper-troubleshooting-fiber) |
| OPT-09 | Waveguide and photonic feature metrology | Measure resolvable widths, gaps, bends, placement, and visible fabrication defects. | Integrated photonics, photonic chips, optical interconnects. | [Photonic coupling and alignment](https://www.pi-usa.us/fileadmin/user_upload/pi_us/files/catalogs/PI_Photonic_Fiber_Alignment_Engines.pdf) |
| OPT-10 | Grating geometry analysis | Estimate pitch, orientation, duty cycle, and defect distributions within the instrument's resolution. | Diffractive optics, encoders, photonic structures. | [CD-SEM dimensional analysis](https://www.hitachi-hightech.com/us/en/products/advanced-analytical/microscopy/cdsem.html) |
| OPT-11 | Slanted-edge and target MTF analysis | Estimate system modulation transfer from calibrated targets and acquisition conditions. | Imaging modules, objectives, camera and microscope qualification. | [MTF characterization example](https://www.imatest.com/imaging/validating_slanted_edge/) |
| OPT-12 | PSF and aberration analysis | Measure point responses or wavefronts and fit relevant aberration terms, such as Zernike coefficients. | Optical alignment, lens testing, microscope characterization. | [Microscope QC application](https://pmc.ncbi.nlm.nih.gov/articles/9526251/) |
| OPT-13 | Interferometric surface form | Recover measured surface form and compare against plane, sphere, asphere, or other nominal models. | Precision optics, microlenses, polished surfaces. | [Interferometric surface measurement](https://www.zygo.com/support/technologies/csi-techology) |
| OPT-14 | Transparent film thickness estimation | Fit spectral, interference, or multilayer models using known optical constants and calibrated measurements. | Optical coatings, thin films, photonic devices. | [Optical thin-film measurement](https://www.zygo.com/applications/measurements/films-analysis/thin-films-analysis) |
| OPT-15 | Polarization and stress-optic inspection | Map retardance and, with valid material calibration, infer stress-related quantities. | Precision glass, molded optics, crystals, optical polymers. | [Quantitative retardance imaging](https://pmc.ncbi.nlm.nih.gov/articles/PMC6484989/) |
| OPT-16 | Optical alignment and coupling optimization | Maximize a measured coupling or image-quality objective while varying supported alignment axes. | Fiber coupling, photonic packaging, micro-optical assembly. | [Photonic coupling and alignment](https://www.pi-usa.us/fileadmin/user_upload/pi_us/files/catalogs/PI_Photonic_Fiber_Alignment_Engines.pdf) |

### 19. Surface texture and experimental mechanics

Roughness and step-height measurements require calibrated height data rather than grayscale intensity. The [ZYGO coherence scanning interferometry description](https://www.zygo.com/support/technologies/csi-techology) explains one acquisition approach for optical surface topography.

| ID | Algorithm or module | Brief summary | Application areas | Ref Link |
| --- | --- | --- | --- | --- |
| SUR-01 | Plane, form, and background removal | Fit reference planes or nominal forms while protecting features and retaining removed coefficients. | Surface texture, optical form, scanning probe analysis. | [Data Levelling and Background Subtraction](https://gwyddion.net/documentation/user-guide-en/leveling-and-background.html) |
| SUR-02 | Profile roughness parameters | Calculate specified profile height statistics after defined form removal and spatial filtering. | Machined surfaces, tribology, process inspection. | [One-Dimensional Roughness Parameters](https://gwyddion.net/documentation/user-guide-en/roughness-iso.html) |
| SUR-03 | Areal surface texture parameters | Calculate height, spatial, hybrid, or functional parameters from valid calibrated surface maps. | Surface engineering, optical polishing, manufacturing. | [Statistical Analysis](https://gwyddion.net/documentation/user-guide-en/statistical-analysis.html) |
| SUR-04 | Spatial filtering and scale separation | Separate form, waviness, and roughness using specified cutoffs, nesting indices, and boundary treatment. | Surface metrology, standards-based texture analysis. | [One-Dimensional Roughness Parameters](https://gwyddion.net/documentation/user-guide-en/roughness-iso.html) |
| SUR-05 | Surface power spectral density | Quantify height variation versus spatial frequency with controlled sampling and windowing. | Optical scatter studies, polishing, patterned surfaces. | [Statistical Analysis](https://gwyddion.net/documentation/user-guide-en/statistical-analysis.html) |
| SUR-06 | Step, trench, and feature height | Fit reference regions and measure vertical differences with masks and uncertainty. | Coatings, MEMS, semiconductor structures, wear tracks. | [Feature Measurement](https://gwyddion.net/documentation/user-guide-en/feature-measurement.html) |
| SUR-07 | Bearing-area and material-ratio analysis | Describe height distributions and functional surface regions using selected texture models. | Tribology, sealing surfaces, contact mechanics. | [Statistical Analysis](https://gwyddion.net/documentation/user-guide-en/statistical-analysis.html) |
| SUR-08 | Wear volume and material loss | Compare registered before-and-after surfaces or reference forms and integrate signed volume change. | Coatings, abrasion, tribology, tool wear. | [Wear-volume measurement](https://www.zygo.com/applications/measurements/wear-volume) |
| SUR-09 | Digital image correlation | Track textured image subsets and derive calibrated in-plane displacement and strain with validity checks. | Micromechanics, tensile testing, thermal deformation. | [Microscopic DIC implementation](https://github.com/ElsevierSoftwareX/SOFTX-D-20-00054) |
| SUR-10 | Digital volume correlation | Estimate 3D displacement and strain between textured volumes under appropriate regularization. | In situ tomography, porous materials, biomechanics. | [TomoWarp2 volume correlation](https://github.com/ElsevierSoftwareX/SOFTX-D-17-00061) |
| SUR-11 | Traction force reconstruction | Infer substrate traction from measured deformation and a calibrated mechanical forward model. | Cell mechanics, mechanobiology, biomaterials. | [Traction-force analysis example](https://pytfm.readthedocs.io/en/latest/) |
| SUR-12 | Contact angle and droplet shape fitting | Fit side-view droplet profiles and substrate baselines using suitable geometric or physical models. | Wetting, coatings, microfluidics, surface chemistry. | [Droplet contact-angle example](https://bigwww.epfl.ch/demo/dropanalysis/) |
| SUR-13 | Phase-shifting interferometry | Recover phase and height from interferograms with known or estimated phase steps and an appropriate reflection or transmission model. | Smooth surfaces, precision optics, interferometric microscopy. | [Phase-shifting interferometry example](https://www.zygo.com/insights/research-papers/101-frame-algorithm-for-phase-shifting-interferometry) |
| SUR-14 | Coherence scanning interferometry | Estimate surface height from scanned interference envelopes and phase, with signal-quality and interface checks. | Optical profilometry, machined surfaces, microfeatures. | [Interferometric surface measurement](https://www.zygo.com/support/technologies/csi-techology) |

### 20. Electron microscopy and crystallography

Electron microscopy modules use electron-specific metadata and acquisition models. [RELION](https://relion.readthedocs.io/en/release-5.0/) documents cryo-EM processing, and [pyxem](https://pyxem.org/) documents analysis of pixelated electron diffraction datasets.

| ID | Algorithm or module | Brief summary | Application areas | Ref Link |
| --- | --- | --- | --- | --- |
| EM-01 | SEM scan drift and distortion correction | Correct characterized line shifts, drift, or scan deformation using reference features or repeated scans. | Semiconductor review, materials imaging, dimensional SEM. | [SEM dimensional measurement](https://www.hitachi-hightech.com/global/en/knowledge/semiconductor/room/manufacturing/cd-sem.html) |
| EM-02 | SEM focus and astigmatism optimization | Optimize image sharpness and directional balance through supported instrument controls. | Automated SEM imaging, high-resolution inspection. | [SEM dimensional measurement](https://www.hitachi-hightech.com/global/en/knowledge/semiconductor/room/manufacturing/cd-sem.html) |
| EM-03 | Cryo-EM movie motion correction | Align dose-fractionated frames and account for beam-induced motion and exposure weighting. | Structural biology, cryo-EM preprocessing. | [Single particle tutorial](https://relion.readthedocs.io/en/release-5.0/SPA_tutorial/index.html) |
| EM-04 | Contrast transfer function estimation | Estimate defocus, astigmatism, and transfer parameters from electron micrograph spectra. | Cryo-EM, high-resolution TEM. | [Single particle tutorial](https://relion.readthedocs.io/en/release-5.0/SPA_tutorial/index.html) |
| EM-05 | Particle picking and extraction | Detect candidate molecular particles, extract images, and reject contamination or unsuitable regions. | Single-particle cryo-EM, macromolecular complexes. | [Single particle tutorial](https://relion.readthedocs.io/en/release-5.0/SPA_tutorial/index.html) |
| EM-06 | Single-particle classification and reconstruction | Align particle images, classify heterogeneity, and estimate 3D density using validated reconstruction methods. | Structural biology, drug discovery research. | [Single particle tutorial](https://relion.readthedocs.io/en/release-5.0/SPA_tutorial/index.html) |
| EM-07 | Tilt-series alignment and electron tomography | Align projections with fiducials or image features and reconstruct with missing-angle awareness. | Cellular ultrastructure, nanomaterials, device cross-sections. | [Subtomogram tutorial](https://relion.readthedocs.io/en/release-5.0/STA_tutorial/index.html) |
| EM-08 | Subtomogram averaging | Detect, align, classify, and average repeated structures within reconstructed tomograms. | In situ structural biology, molecular assemblies. | [Subtomogram tutorial](https://relion.readthedocs.io/en/release-5.0/STA_tutorial/index.html) |
| EM-09 | FIB-SEM volume analysis | Correct slice alignment and acquisition artifacts, then segment serially milled volumes. | Connectomics, batteries, semiconductor failure analysis. | [Battery FIB-SEM application](https://asset-downloads.zeiss.com/catalogs/download/mic/edabb3d5-a858-4c7b-8648-6e3a94c86ead/EN_wp_FIB-SEM_Lithium-Ion-Battery-Cathode-Material.pdf) |
| EM-10 | Electron diffraction indexing | Match diffraction spots or patterns to candidate crystal structures and orientations. | Crystallography, phase identification, TEM materials research. | [Electron diffraction examples](https://pyxem.org/v0.21.0/examples/index.html) |
| EM-11 | EBSD orientation and phase mapping | Index calibrated diffraction patterns and derive orientation, phase, and grain maps with quality measures. | Metals, ceramics, texture, recrystallization. | [EBSD indexing example](https://kikuchipy.org/en/latest/tutorials/pattern_matching.html) |
| EM-12 | Misorientation and orientation statistics | Quantify boundary misorientations, orientation distributions, and local orientation variation. | Deformation, grain boundaries, texture studies. | [Orientation-analysis examples](https://orix.readthedocs.io/en/stable/examples/index.html) |
| EM-13 | 4D-STEM virtual detectors and diffraction analysis | Form virtual bright/dark-field images and map diffraction-derived structure or orientation. | Nanomaterials, semiconductor structures, diffraction imaging. | [Virtual-detector imaging example](https://www.pyxem.org/en/v0.19.1/examples/virtual_imaging/creating_a_segmented_detector.html) |
| EM-14 | Lattice displacement and strain analysis | Fit atomic positions or reciprocal-lattice changes to estimate strain relative to a stated reference. | HRTEM, STEM, semiconductor and materials research. | [Electron diffraction examples](https://pyxem.org/v0.21.0/examples/index.html) |
| EM-15 | EDS and EELS spectral analysis | Fit backgrounds and peaks or edges, unmix components, and quantify composition using suitable corrections. | Elemental mapping, oxidation-state research, contamination analysis. | [EDS and EELS fitting examples](https://hyperspy.org/exspy/auto_examples/index.html) |

### 21. Scanning probe microscopy

These methods require scanning probe channels or force curves. The [Gwyddion user guide](https://gwyddion.net/documentation/user-guide-en/) covers SPM leveling, artifacts, statistics, tip effects, and force measurements.

| ID | Algorithm or module | Brief summary | Application areas | Ref Link |
| --- | --- | --- | --- | --- |
| SPM-01 | Scan leveling and line correction | Remove justified background shape and line offsets while protecting true specimen structures. | AFM, STM, scanning probe topography. | [Data Levelling and Background Subtraction](https://gwyddion.net/documentation/user-guide-en/leveling-and-background.html) |
| SPM-02 | Drift, creep, and hysteresis correction | Model scanner-dependent geometric distortion using calibration or repeated-scan evidence. | Nanoscale dimensional metrology, repeat imaging. | [Global Distortions](https://gwyddion.net/documentation/user-guide-en/edit-extended.html) |
| SPM-03 | Tip-shape estimation and deconvolution | Estimate probe effects and reconstruct bounds on sample geometry with documented assumptions. | Nanoparticles, sharp structures, AFM shape metrology. | [Tip Convolution Artefacts](https://gwyddion.net/documentation/user-guide-en/tip-convolution-artefacts.html) |
| SPM-04 | Force-curve preprocessing | Calibrate deflection, locate contact, subtract baselines, and transform force-distance coordinates. | AFM mechanics, adhesion, biomaterials. | [Force and Indentation](https://gwyddion.net/documentation/user-guide-en/force_indentation.html) |
| SPM-05 | Contact mechanics fitting | Fit appropriate Hertz, DMT, JKR, or other models with geometry and material assumptions. | Modulus mapping, soft matter, surface mechanics. | [Live-cell nanomechanics example](https://www.bruker.com/en/products-and-solutions/microscopes/materials-afm/resource-library/an-141-toward-quantitative-nanomechanical-measurements-on-live-cells-with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) |
| SPM-06 | Adhesion and dissipation mapping | Extract pull-off force, hysteresis energy, or related metrics from calibrated curves. | Coatings, polymers, cell surfaces. | [Force Distance Curve Maps](https://gwyddion.net/documentation/user-guide-en/curve-maps-fd.html) |
| SPM-07 | Force spectroscopy event detection | Identify rupture or unfolding events and fit force-loading or contour-length models where justified. | Single-molecule biophysics, molecular binding. | [Single-molecule force application](https://www.bruker.com/en/products-and-solutions/microscopes/bioafm/applications_single-molecule-force-spectroscopy.html) |
| SPM-08 | Kelvin probe potential analysis | Correct instrumental contributions and quantify calibrated contact-potential-difference maps. | Semiconductors, photovoltaics, surface electronics. | [Kelvin-probe application](https://www.bruker.com/content/bruker/int/en/products-and-solutions/microscopes/materials-afm/afm-modes/kpfm.html) |
| SPM-09 | Magnetic and piezoresponse domain analysis | Segment domains and quantify calibrated contrast, switching, or hysteresis in the appropriate channels. | Magnetic materials, ferroelectrics, functional devices. | [Magnetic force microscopy](https://gwyddion.net/documentation/user-guide-en/mfm.html) |
| SPM-10 | Conductive and tunneling spectroscopy maps | Analyze current-voltage or differential-conductance curves with spatial registration and artifact checks. | Nanoelectronics, thin films, surface science. | [AFM measurement-mode examples](https://www.bruker.com/content/dam/bruker/int/en/resources/bns/atomic-force-microscopes/application-notes/AFM%20Modes%20Webinar%20Recap%20Application%20Note-BRUKER.p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) |

### 22. X-ray tomography and acoustic microscopy

These extend the platform to internal structure and package inspection. Reconstruction must preserve modality-specific acquisition geometry, corrections, and uncertainty.

| ID | Algorithm or module | Brief summary | Application areas | Ref Link |
| --- | --- | --- | --- | --- |
| XAC-01 | Tomographic projection correction | Correct detector offset, flat field, bad pixels, and relevant acquisition artifacts before reconstruction. | X-ray microscopy, micro-CT, nanotomography. | [Tomography worked tutorials](https://tomotools.esrf.fr/en/latest/tutorials.html) |
| XAC-02 | Tomographic geometry calibration | Estimate rotation axis, detector geometry, motion, and projection alignment. | X-ray tomography, precision internal metrology. | [Tomography worked tutorials](https://tomotools.esrf.fr/en/latest/tutorials.html) |
| XAC-03 | Filtered backprojection and FDK reconstruction | Reconstruct volumes from suitable parallel, fan, or cone-beam acquisitions with geometry-aware filtering. | Micro-CT, X-ray microscopy, materials research. | [Tomographic reconstruction example](https://tomviz.readthedocs.io/en/latest/reconstruction.html) |
| XAC-04 | Iterative and regularized reconstruction | Reconstruct using algebraic, statistical, or regularized optimization with an explicit forward model. | Sparse-view imaging, low-dose tomography, method development. | [Tomographic reconstruction example](https://tomviz.readthedocs.io/en/latest/reconstruction.html) |
| XAC-05 | Ring, beam-hardening, and metal artifact treatment | Mitigate characterized tomographic artifacts and flag residual effects on measurements. | Packages, metals, dense or mixed materials. | [Tomography worked tutorials](https://tomotools.esrf.fr/en/latest/tutorials.html) |
| XAC-06 | X-ray phase reconstruction | Recover phase or related quantities from supported propagation or interferometric measurements. | Soft tissue, low-contrast materials, synchrotron research. | [X-ray phase-retrieval implementation](https://tomopy.readthedocs.io/en/stable/api/tomopy.prep.phase.html) |
| XAC-07 | Laminography reconstruction | Reconstruct planar samples from an appropriate limited-geometry acquisition with anisotropic-resolution reporting. | PCBs, semiconductor packages, layered structures. | [X-ray microscope laminography](https://pmc.ncbi.nlm.nih.gov/articles/PMC12591070/) |
| XAC-08 | Acoustic echo gating and time-of-flight | Extract depth-gated echo amplitude, polarity, and arrival times from calibrated acoustic signals. | Scanning acoustic microscopy, bonded layers, packages. | [Package acoustic inspection](https://calce.umd.edu/scanning-acoustic-microscopy-sam) |
| XAC-09 | Acoustic C-scan defect segmentation | Detect anomalous gated responses and measure affected areas with interface-specific interpretation. | Delamination, voids, wafer bonding, package reliability. | [Bonded-interface acoustic imaging](https://www.enas.fraunhofer.de/en/departments/SP/research/characterization-bonding/scanning-acoustic-microscopy.html) |
| XAC-10 | Multimodal internal defect correlation | Align X-ray or acoustic anomalies with optical and electron microscopy for targeted review. | Electronics failure analysis, composite and materials research. | [Correlative semiconductor failure analysis](https://www.zeiss.com/microscopy/us/applications/semiconductors-electronics/failure-analysis-3d-characterization.html) |

### 23. Additional scientific and industrial applications

These modules broaden the same platform to sectors beyond the primary audiences.

| ID | Algorithm or module | Brief summary | Application areas | Ref Link |
| --- | --- | --- | --- | --- |
| EXT-01 | Powder and particle morphology | Measure size, circularity, aspect ratio, agglomeration, and foreign particles with explicit sampling rules. | Pharmaceuticals, additive manufacturing, catalysts, ceramics. | [Particle Distribution Solutions](https://evidentscientific.com/en/landing/microscope-solutions-for-materialography/particle-distribution-solutions) |
| EXT-02 | Pharmaceutical crystal analysis | Measure crystal habit, dimensions, population changes, and spectrally supported identity. | Formulation, crystallization, dissolution research. | [Pharmaceutical Raman analysis](https://www.renishaw.com/en/pharmaceuticals--7977) |
| EXT-03 | Microplastic and contaminant analysis | Combine particle detection, morphology, and suitable spectral identification. | Water quality, environmental monitoring, contamination research. | [Microplastic chemical mapping](https://www.renishaw.com/en/study-polymers-and-microplastics-with-raman-spectroscopy--25887) |
| EXT-04 | Mineral and petrographic classification | Analyze polarized textures and suitable compositional measurements to map mineral phases. | Geology, mining, cement, planetary materials. | [Loading the RRUFF dataset](https://ramanspy.readthedocs.io/en/latest/auto_tutorials/iii-datasets/ii_rruff.html) |
| EXT-05 | Pollen, plankton, and diatom analysis | Detect and classify organisms with reviewed morphology and taxonomic confidence. | Ecology, water research, palynology, environmental science. | [Diatom quantitative imaging](https://pmc.ncbi.nlm.nih.gov/articles/PMC7199005/) |
| EXT-06 | Food emulsion and microstructure analysis | Quantify droplets, fat networks, crystals, bubbles, and phase separation. | Food science, process development, product stability. | [Food microstructure applications](https://www.zeiss.com/microscopy/en/applications/laboratory-routine/microscopy-solutions-for-food-analysis.html) |
| EXT-07 | Textile, paper, and filter analysis | Measure fiber diameter, orientation, defects, pores, and structural uniformity. | Textiles, filtration, paper manufacturing, nonwovens. | [Materials analysis examples](https://www.clemex.com/applications/catalog) |
| EXT-08 | Battery electrode and separator analysis | Measure particle morphology, cracks, porosity, layer thickness, and internal connectivity. | Battery development, manufacturing, degradation studies. | [Battery microscopy applications](https://www.zeiss.com/microscopy/us/applications/materials-science/energy-materials/battery-research.html) |
| EXT-09 | Ceramic and cement microstructure | Quantify phases, pores, grain geometry, and interfacial features using appropriate contrast. | Structural ceramics, construction materials, refractories. | [Ceramic particle morphology](https://www.clemex.com/applications/ceramic-microsphere-analysis) |
| EXT-10 | Forensic trace comparison | Compare documented morphology and spectral evidence with controlled acquisition and review. | Fibers, paint fragments, tool marks, trace-material research. | [Forensic trace microscopy](https://www.leica-microsystems.com/applications/forensic-science/) |
| EXT-11 | Crystallization and dissolution dynamics | Track interfaces and particle populations to quantify growth, shrinkage, nucleation, or dissolution. | Chemistry, pharmaceuticals, materials science. | [Track solidification of a metallic alloy](https://scikit-image.org/docs/stable/auto_examples/applications/plot_solidification_tracking.html) |
| EXT-12 | Motility and microswimmer analysis | Measure trajectories, speed, beat-related signals, and population motion under defined conditions. | Reproductive research, microbiology, active matter, microrobotics. | [Sperm motility analysis](https://imagej.net/ij/plugins/casa.html) |

### 24. Machine learning and annotation

These capabilities support the analysis methods rather than replacing calibration, representative data, or task-specific performance evaluation.

| ID | Algorithm or module | Brief summary | Application areas | Ref Link |
| --- | --- | --- | --- | --- |
| ML-01 | Object and image classification | Assign trained labels using explicit class definitions and specimen-level performance evaluation. | Cell phenotypes, defects, materials phases. | [Cell phenotype classification](https://cellprofileranalyst.org/) |
| ML-02 | Learned feature embeddings and retrieval | Represent images or objects for similarity search, clustering, and review. | Phenotypic discovery, defect libraries, research archives. | [Cell Painting profiling application](https://www.broadinstitute.org/publications/broad10406) |
| ML-03 | Unsupervised clustering | Explore groups using feature reduction and clustering with stability and interpretation checks. | Discovery biology, spectral maps, defect populations. | [Built-in decomposition methods](https://ramanspy.readthedocs.io/en/latest/auto_tutorials/vi-analysis/plot_i_decomposition.html) |
| ML-04 | One-class and anomaly detection | Model acceptable variation and flag departures with reviewed decision thresholds. | Rare industrial defects, process monitoring. | [Visual anomaly detection examples](https://anomalib.readthedocs.io/en/latest/) |
| ML-05 | Active learning | Select uncertain or diverse examples for human labeling and iterative model improvement. | New assays, rare defects, low-label projects. | [Interactive classification examples](https://www.ilastik.org/documentation/) |
| ML-06 | Interactive annotation and correction | Edit masks, classes, landmarks, and tracks while retaining annotation history and provenance. | Training data creation, expert review, assisted analysis. | [Interactive microscopy segmentation](https://github.com/computational-cell-analytics/micro-sam) |
| ML-07 | Weak and semi-supervised learning | Train with partial, image-level, sparse, or mixed-quality labels under a defined evaluation plan. | Large slide archives, scarce expert labels, industrial inspection. | [Weak-label cell segmentation](https://pmc.ncbi.nlm.nih.gov/articles/PMC9981753/) |
| ML-08 | Transfer learning and domain adaptation | Adapt models across objectives, instruments, stains, or sample types and measure the new-domain performance. | Multisite research, new production lines, assay transfer. | [Cellpose cell segmentation](https://cellpose.readthedocs.io/en/latest/) |
| ML-09 | Uncertainty and confidence calibration | Evaluate confidence quality, estimate uncertainty, and support abstention or review queues. | High-stakes measurements, screening, defect triage. | [Interactive classification examples](https://www.ilastik.org/documentation/) |
| ML-10 | Out-of-distribution detection | Identify inputs unlike validated training and reference data. | Changing specimen preparation, new materials, instrument drift. | [Visual anomaly detection examples](https://anomalib.readthedocs.io/en/latest/) |
| ML-11 | Synthetic data and image simulation | Generate controlled images from physical or statistical models for development and sensitivity studies. | Algorithm verification, rare-defect studies, training augmentation. | [Synthetic Surfaces](https://gwyddion.net/documentation/user-guide-en/synthetic.html) |
| ML-12 | Model-based explanation and review | Show relevant masks, features, exemplars, or attribution views alongside known interpretation limits. | Expert inspection, biological discovery, model auditing. | [Cell phenotype classification](https://cellprofileranalyst.org/) |

### 25. Data management, visualization, and interoperability

These are platform capabilities needed to make algorithms usable. [OME-TIFF](https://docs.openmicroscopy.org/ome-model/latest/ome-tiff/) and [OME-NGFF](https://ngff.openmicroscopy.org/) provide microscopy-oriented data models; implement a specified supported version rather than assuming all readers interpret every extension.

| ID | Algorithm or module | Brief summary | Application areas | Ref Link |
| --- | --- | --- | --- | --- |
| DAT-01 | Multiformat import and metadata mapping | Read supported instrument formats and preserve axes, units, channel definitions, calibration, and acquisition settings. | Cross-vendor microscopy, historical data, research facilities. | [Bio-Formats microscopy import](https://imagej.net/formats/bio-formats) |
| DAT-02 | Multiresolution image pyramids | Build tiled scale levels for responsive viewing of large images and volumes. | Whole slides, wafer maps, large mosaics. | [Build image pyramids](https://scikit-image.org/docs/stable/auto_examples/transform/plot_pyramid.html) |
| DAT-03 | Chunked and out-of-core processing | Process bounded chunks with overlap and explicit boundary handling rather than loading complete datasets. | Terabyte volumes, high-content screens, large tomography. | [OME-Zarr multiscale imaging](https://ngff.openmicroscopy.org/) |
| DAT-04 | Multidimensional image viewer | Navigate channels, Z, time, positions, and modalities with calibrated coordinates and consistent overlays. | All microscopy applications. | [Multidimensional viewer examples](https://github.com/napari/napari) |
| DAT-05 | 3D volume and surface visualization | Render volumes, surfaces, clipping planes, and measurements with visible physical scale. | Biology, internal defects, surface metrology. | [Multidimensional viewer examples](https://github.com/napari/napari) |
| DAT-06 | Linked images, plots, and result tables | Select an object in a table or plot and navigate to its image, mask, spectrum, or trajectory. | Screening, defect review, quantitative research. | [Exporting measurements](https://qupath.readthedocs.io/en/stable/docs/tutorials/exporting_measurements.html) |
| DAT-07 | Spatial result maps | Display measurements and classifications over slides, wafers, plates, or component coordinates. | Yield analysis, spatial biology, industrial inspection. | [Density maps](https://qupath.readthedocs.io/en/stable/docs/tutorials/density_maps.html) |
| DAT-08 | Structured annotation storage | Save regions, object identities, classes, tracks, and coordinate transforms independently of display screenshots. | Collaboration, reanalysis, training datasets. | [OMERO microscopy workflows](https://omero-guides.readthedocs.io/en/latest/) |
| DAT-09 | Searchable specimen and experiment metadata | Index specimen preparation, batch, instrument, operator, and assay relationships. | Research archives, industrial traceability, imaging cores. | [OMERO microscopy workflows](https://omero-guides.readthedocs.io/en/latest/) |
| DAT-10 | Analysis and image export | Export quantitative tables, labels, coordinates, images, and compatible multidimensional formats. | Publications, downstream analysis, external systems. | [OME-TIFF microscopy exchange](https://ome-model.readthedocs.io/en/stable/ome-tiff/) |
| DAT-11 | Instrument and analysis plugin interfaces | Expose versioned interfaces for device drivers, analysis modules, and external tool integration. | Product extensibility, specialized instruments, shared platforms. | [Bioimage model applications](https://bioimage.io/) |
| DAT-12 | Workflow scripting and APIs | Expose parameterized operations for automation, integration, and headless execution. | Batch research, production inspection, laboratory integration. | [Scripted microscope workflows](https://pycro-manager.readthedocs.io/en/latest/user_guide.html) |
| DAT-13 | Review and report generation | Produce image-linked summaries with methods, units, calibration, quality flags, and supporting measurements. | Research reports, customer inspection, quality review. | [Batch execution reports](https://www.nextflow.io/docs/latest/reports.html) |
| DAT-14 | Laboratory and manufacturing integration | Exchange sample IDs, work orders, results, and review states through supported external interfaces. | LIMS, ELN, MES, bioprocessing, semiconductor manufacturing. | [OMERO microscopy workflows](https://omero-guides.readthedocs.io/en/latest/) |

### 26. Quality assurance and reproducible execution

Distinguish software verification, measurement validation, model evaluation, and application acceptance. A pipeline that runs successfully can still produce the wrong scientific or manufacturing result.

| ID | Algorithm or module | Brief summary | Application areas | Ref Link |
| --- | --- | --- | --- | --- |
| QA-01 | Image quality scoring | Detect blur, saturation, low signal, noise, missing coverage, and relevant acquisition artifacts. | Automated acquisition, dataset screening, production quality. | [Image QC measurements](https://cellprofiler-manual.s3.amazonaws.com/CPmanual/MeasureImageQuality.html) |
| QA-02 | Calibration validity checks | Match required calibrations to instrument configuration and flag missing or expired references. | Metrology, fluorescence quantification, automated inspection. | [Microscope QC application](https://pmc.ncbi.nlm.nih.gov/articles/9526251/) |
| QA-03 | Segmentation and detection evaluation | Compare against reference annotations using appropriate object, boundary, overlap, and counting metrics. | Algorithm validation, assay transfer, defect inspection. | [Evaluating segmentation metrics](https://scikit-image.org/docs/stable/auto_examples/segmentation/plot_metrics.html) |
| QA-04 | Tracking evaluation | Measure missed tracks, identity switches, division accuracy, and trajectory errors on reviewed data. | Cell lineages, motility, single-particle studies. | [Bioimage benchmark examples](https://bbbc.broadinstitute.org/) |
| QA-05 | Repeatability and reproducibility studies | Quantify within-run, between-run, operator, and instrument contributions to variation. | Measurement systems, laboratory transfer, manufacturing. | [Gauge R&R example](https://www.itl.nist.gov/div898/handbook/mpc/section4/mpc4.htm) |
| QA-06 | Gauge R&R and method comparison | Assess measurement-system variation and agreement with reference methods using suitable experimental designs. | Industrial metrology, supplier qualification, assay validation. | [Gauge R&R example](https://www.itl.nist.gov/div898/handbook/mpc/section4/mpc4.htm) |
| QA-07 | Statistical process monitoring | Track stable reference metrics using control charts or change-detection models with justified limits. | Instrument health, manufacturing inspection, assay operations. | [Measurement process examples](https://www.itl.nist.gov/div898/handbook/mpc/mpc_d.htm) |
| QA-08 | Control normalization and batch assessment | Normalize to appropriate controls and evaluate plate, day, site, and batch effects. | High-content screening, quantitative assays, multisite research. | [Cell Painting profiling application](https://www.broadinstitute.org/publications/broad10406) |
| QA-09 | Versioned recipes and provenance | Record inputs, parameters, software, models, calibration, and transformation history for each result. | Reproducible research, industrial traceability. | [Versioned experiment example](https://mlflow.org/docs/latest/ml/tracking/) |
| QA-10 | Deterministic and resource-aware execution | Manage seeds, numerical precision, GPU/CPU differences, memory, and job scheduling. | Large-scale processing, validated pipelines, shared instruments. | [Batch execution reports](https://www.nextflow.io/docs/latest/reports.html) |
| QA-11 | Checkpoint, retry, and acquisition recovery | Resume interrupted jobs or scans without duplicating objects, losing frames, or silently changing settings. | Long experiments, whole-slide scans, production inspection. | [Resumable analysis example](https://www.nextflow.io/docs/latest/cache-and-resume.html) |
| QA-12 | Review states and audit history | Record acceptance, rejection, edits, overrides, and reviewer identity with supporting evidence. | Quality workflows, regulated environments, collaborative research. | [OMERO microscopy workflows](https://omero-guides.readthedocs.io/en/latest/) |

## Part II: End-to-end workflows

Each workflow combines acquisition, analysis, quality checks, and deliverables. The sequences are starting points for configurable recipes; sampling plans, controls, acceptance criteria, and supported hardware must be defined for the specific use case. Section references identify reusable modules from Part I.

### A. General acquisition and inspection workflows

| ID | Workflow | Brief sequence and principal outputs | Application areas | Ref Link |
| --- | --- | --- | --- | --- |
| WF-G01 | Calibrated routine microscopy | Select instrument configuration -> verify calibration and image quality -> acquire -> annotate or measure -> export images and unit-bearing results. Uses sections 1, 2, 7, 25, and 26. | All microscopy users, routine laboratories, incoming inspection. | [Multidimensional acquisition](https://micro-manager.org/Micro-Manager_User%27s_Guide2) |
| WF-G02 | Large-area automated scanning | Detect specimen or region -> sample focus -> plan overlapping tiles and route -> acquire -> globally stitch -> verify coverage -> export mosaic and coordinate map. Uses sections 1, 2, 5, and 26. | Whole slides, wafers, large metallographic specimens, components. | [Microscopy stitching example](https://imagej.net/plugins/image-stitching) |
| WF-G03 | Extended depth-of-field inspection | Acquire calibrated Z stack -> check sharpness and motion -> fuse focused content -> review fusion artifacts -> export all-in-focus image; report height separately only if validated. Uses sections 1, 5, and 9. | Rough parts, minerals, insects, assembled devices. | [Extended-focus specimen example](https://bigwww.epfl.ch/demo/edf/) |
| WF-G04 | Automated particle analysis | Define sampled area -> correct background -> detect and separate particles -> apply counting-frame rules -> measure -> report distributions, detection limits, and reviewed exceptions. Uses sections 3, 6, 7, and 26. | Cleanliness, powders, contamination, environmental particles. | [Automated cleanliness inspection](https://evidentscientific.com/en/products/cleanliness-and-particle-analysis/cix100) |
| WF-G05 | Reference-based visual inspection | Align a specimen to a qualified reference -> compare appearance or geometry -> segment deviations -> classify and review -> produce a defect map and inspection report. Uses sections 5, 6, 7, and 24-26. | Repeated manufactured parts, photonic devices, electronics. | [Visual anomaly detection examples](https://anomalib.readthedocs.io/en/latest/) |
| WF-G06 | Adaptive survey and revisit | Acquire low-magnification survey -> detect candidate regions -> relocate with calibrated coordinates -> acquire high-resolution evidence -> confirm findings -> export linked overview and detail records. Uses sections 1, 2, 5, and 25. | Rare objects, wafer review, tissue regions, failure analysis. | [Targeted collagen imaging](https://pycro-manager.readthedocs.io/en/latest/application_notebooks/guiding_acq_with_neural_network_attention.html) |
| WF-G07 | Correlative multimodal investigation | Identify a feature -> record fiducials -> acquire complementary modalities -> fit coordinate transforms -> compare measurements -> export a traceable multimodal case. Uses sections 2, 5, 20-22, and 25. | Root-cause analysis, correlative biology, materials research. | [Correlative semiconductor failure analysis](https://www.zeiss.com/microscopy/us/applications/semiconductors-electronics/failure-analysis-3d-characterization.html) |
| WF-G08 | Longitudinal change monitoring | Acquire a baseline -> revisit or continuously image -> register -> quantify object or surface changes -> distinguish drift and artifacts -> report trajectories and change maps. Uses sections 1, 3, 5, 8, and 26. | Growth, corrosion, wear, live specimens, aging studies. | [Track solidification of a metallic alloy](https://scikit-image.org/docs/stable/auto_examples/applications/plot_solidification_tracking.html) |

### B. Biotechnology and biological research workflows

| ID | Workflow | Brief sequence and principal outputs | Application areas | Ref Link |
| --- | --- | --- | --- | --- |
| WF-B01 | Live-cell growth and confluence | Plan low-dose time-lapse -> maintain focus -> segment cells or culture area -> track growth -> reject poor frames -> report confluence, counts, and growth curves. Uses sections 1, 6, 8, and 13. | Cell culture, bioprocess development, treatment-response studies. | [CellProfiler example pipelines](https://cellprofiler.org/examples) |
| WF-B02 | High-content multiwell screening | Map wells and controls -> acquire standardized fields -> correct illumination -> segment cells -> extract features -> assess assay quality -> summarize well and treatment effects. Uses sections 1-3, 6, 7, 13, and 26. | Drug discovery, toxicology, functional genomics. | [High-content assay examples](https://documents.thermofisher.com/TFS-Assets/BID/Reference-Materials/high-content-imaging-analysis-software-fluorescent-labels-bioprobes-77-article.pdf) |
| WF-B03 | Cell painting profiling | Acquire multichannel morphology stains -> perform compartment-aware measurements -> normalize to controls -> aggregate profiles -> assess batch effects -> compare perturbation similarities. Uses sections 3, 6, 7, 13, 24, and 26. | Phenotypic discovery, compound profiling, mechanism research. | [Cell Painting profiling application](https://www.broadinstitute.org/publications/broad10406) |
| WF-B04 | Viability and cytotoxicity assay | Acquire validated live/dead or death-associated markers -> segment objects -> classify states -> inspect controls -> report fractions and dose-response summaries with exclusions. Uses sections 6, 7, 13, and 26. | Biotechnology, biomaterials, drug and toxicity research. | [High-content assay examples](https://documents.thermofisher.com/TFS-Assets/BID/Reference-Materials/high-content-imaging-analysis-software-fluorescent-labels-bioprobes-77-article.pdf) |
| WF-B05 | Single-cell migration and wound healing | Acquire registered time series -> segment cells and/or gap -> track boundaries or identities -> review links -> report closure, speed, persistence, and directionality. Uses sections 5, 6, 8, and 13. | Cancer research, tissue repair, cell motility. | [CellProfiler example pipelines](https://cellprofiler.org/examples) |
| WF-B06 | Organoid and spheroid response | Acquire multichannel Z stacks or appropriate projections -> reconstruct and segment -> quantify growth, shape, and viability markers -> report object-level and treatment-level results. Uses sections 9, 11, 13, and 26. | 3D culture, personalized research models, drug response. | [Gastruloid image-analysis example](https://github.com/fmi-basel/gliberal-gastruloid-2023-methods) |
| WF-B07 | Microbial growth and lineage | Acquire phase-contrast or fluorescence time-lapse -> segment microbes -> link divisions -> identify ambiguous events -> report growth, generation times, morphology, and lineages. Uses sections 6, 8, and 13. | Antibiotics, fermentation, synthetic biology. | [Bacterial growth and lineage analysis](https://pmc.ncbi.nlm.nih.gov/articles/PMC8797229/) |
| WF-B08 | Biofilm characterization | Acquire calibrated confocal stacks -> correct signal -> segment biomass and labels -> measure coverage, thickness, biovolume, and organization -> report sampling-aware summaries. Uses sections 3, 9, 11, and 13. | Microbiology, biofouling, antimicrobial materials. | [Biofilm quantification examples](https://drescherlab.org/data/biofilmQ/) |
| WF-B09 | Quantitative fluorescence and translocation | Acquire single-label and background controls -> correct shading and crosstalk -> segment compartments -> measure intensity or ratios -> report control-normalized per-cell results. Uses sections 2, 3, 11, and 13. | Signaling, reporter assays, pathway screening. | [CellProfiler example pipelines](https://cellprofiler.org/examples) |
| WF-B10 | FISH and spatial expression | Acquire probe channels and cell references -> register -> detect spots -> assign to cells or regions -> assess background and crowding -> export counts and spatial maps. Uses sections 5-7, 11, 13, and 14. | Gene-expression research, cytogenetics, spatial biology. | [Spatial cell-neighborhood example](https://squidpy.readthedocs.io/en/stable/notebooks/tutorials/tutorial_vizgen.html) |
| WF-B11 | Whole-slide tissue quantification | Scan and check coverage -> mask artifacts -> separate stains or channels -> segment tissue and cells -> score markers and neighborhoods -> export reviewable regional results. Uses sections 5-7, 14, and 25-26. | Histology, biomarker studies, tissue research. | [Multiplexed analysis](https://qupath.readthedocs.io/en/stable/docs/tutorials/multiplex_analysis.html) |
| WF-B12 | Functional calcium imaging | Acquire synchronized time series -> correct motion -> segment or demix signal sources -> extract traces and events -> validate against noise and controls -> report activity and population statistics. Uses sections 1, 5, 8, 11, and 13. | Neuroscience, cardiac assays, functional screening. | [Calcium-imaging analysis](https://caiman.readthedocs.io/en/latest/) |

### C. Semiconductor and electronics workflows

| ID | Workflow | Brief sequence and principal outputs | Application areas | Ref Link |
| --- | --- | --- | --- | --- |
| WF-S01 | Wafer surface defect inspection | Align wafer and die grid -> scan with focus control -> detect particles, scratches, and pattern anomalies -> review candidates -> export wafer map and defect records. Uses sections 1, 6, 15, and 25-26. | Wafer manufacturing, incoming substrates, process monitoring. | [Automated wafer inspection](https://www.zeiss.com/microscopy/en/l/great-britain/campaigns/2025/unlocking-innovation-ai-and-automation-in-wafer-solutions.html) |
| WF-S02 | Lithography dimensional process control | Acquire qualified CD and overlay targets -> calibrate -> fit features -> map dimensions and errors -> evaluate sampling and measurement uncertainty -> report process statistics. Uses sections 2, 7, 15, and 26. | Resist, lithography, etch process development. | [CD-SEM dimensional analysis](https://www.hitachi-hightech.com/us/en/products/advanced-analytical/microscopy/cdsem.html) |
| WF-S03 | Focus-exposure matrix characterization | Import designed focus/exposure conditions -> image test structures -> measure dimensions and defects -> identify an acceptable operating region -> report process-window maps. Uses sections 1, 7, and 15. | Lithography optimization, resist characterization. | [Mask defect qualification](https://www.zeiss.com/semiconductor-manufacturing-technology/products/photomask-solutions/mask-qualification.html) |
| WF-S04 | Photomask inspection and repair review | Align image and design or reference -> detect missing/extra material -> classify defects -> review at adequate resolution -> compare before and after repair. Uses sections 5, 6, 15, and 26. | Photomask manufacturing, mask quality, failure review. | [Photomask repair and review](https://www.zeiss.com/semiconductor-manufacturing-technology/smt-magazine/30-years-of-photomask-qualification.html) |
| WF-S05 | Packaging assembly inspection | Locate dies, bumps, and bonds -> measure placement and visible geometry -> use height data for coplanarity -> review exceptions -> produce assembly-level results. Uses sections 7, 9, and 16. | Flip-chip, wire bonding, advanced packaging. | [Advanced packaging inspection](https://evidentscientific.com/en/solutions/advanced-packaging-inspection) |
| WF-S06 | Internal package reliability inspection | Acquire X-ray and/or acoustic data -> correct and reconstruct or gate signals -> segment anomalies -> correlate interfaces -> report void or delamination locations and extent. Uses sections 9, 16, and 22. | Packages, bonded wafers, reliability engineering. | [Package acoustic inspection](https://calce.umd.edu/scanning-acoustic-microscopy-sam) |
| WF-S07 | Semiconductor failure analysis | Import failed-device coordinates -> survey and relocate -> correlate optical, electrical, SEM, and internal imaging -> target cross-sections -> document evidence and conclusions. Uses sections 5, 15, 16, 20, and 22. | Yield excursions, device reliability, root-cause investigation. | [Correlative semiconductor failure analysis](https://www.zeiss.com/microscopy/us/applications/semiconductors-electronics/failure-analysis-3d-characterization.html) |
| WF-S08 | PCB fabrication and assembly inspection | Register board and reference -> inspect traces, pads, joints, and components -> measure relevant dimensions -> review exceptions -> export board-level defect records. Uses sections 5-7, 16, and 25. | PCB manufacture, electronics assembly, flexible circuits. | [PCB inspection examples](https://www.leica-microsystems.com/applications/industrial-microscopy-markets/electronics-semiconductor/pcb-inspection/) |
| WF-S09 | MEMS characterization | Acquire calibrated static and time-resolved measurements -> segment microstructures -> measure dimensions and displacement -> analyze response -> report geometry and dynamics. Uses sections 7-9 and 16. | Sensors, actuators, microsystems research. | [MEMS surface metrology](https://www.zygo.com/applications/what-we-measure/mems) |
| WF-S10 | Display and microLED inspection | Acquire calibrated lit/unlit patterns and geometric images -> correct imaging variation -> identify defective pixels and placement errors -> map uniformity -> export device maps. Uses sections 2, 3, 16, and 25. | Displays, microLED transfer, microdisplays. | [MicroLED uniformity example](https://www.radiantvisionsystems.com/learn/white-papers/measuring-and-correcting-microled-display-uniformity) |

### D. Metallurgy and materials workflows

| ID | Workflow | Brief sequence and principal outputs | Application areas | Ref Link |
| --- | --- | --- | --- | --- |
| WF-M01 | Metallographic grain-size evaluation | Record preparation and etch -> calibrate -> select representative fields -> delineate grains -> apply the selected intercept or planimetric method -> review boundaries and report statistics. Uses sections 2, 6, 7, and 17. | Heat treatment, alloy qualification, microstructure studies. | [Evaluation of Steel Grain Size](https://evidentscientific.com/en/applications/ie-evaluation-of-steel-grain-size) |
| WF-M02 | Steel cleanliness and inclusion rating | Acquire specified fields or scanned areas -> detect and measure inclusions -> apply the selected rating rules -> review classifications -> report field and specimen summaries. Uses sections 1, 6, 7, and 17. | Steel quality, fatigue-sensitive alloys, bearing materials. | [Nonmetallic Inclusion Analysis in Steel](https://ims.evidentscientific.com/en/applications/nonmetallic-inclusion-analysis-in-steel) |
| WF-M03 | Cast-iron graphite analysis | Acquire representative prepared fields -> segment graphite -> classify form and nodularity -> measure size and fraction -> review edge cases -> report specimen statistics. Uses sections 6, 7, and 17. | Foundries, cast-iron process control. | [Evaluation of spheroidal graphite cast iron](https://evidentscientific.com/en/applications/ie-evaluation-of-spheroidal-graphite-cast-iron) |
| WF-M04 | Phase fraction and porosity | Define sampling and contrast -> segment phases or pores -> validate labels -> calculate 2D fractions or 3D volumes -> report distributions with sampling and dimensional assumptions. Uses sections 6, 7, 9, and 17. | Alloys, ceramics, sintered parts, composites. | [Porosity Analysis Solutions](https://evidentscientific.com/en/landing/microscope-solutions-for-materialography/porosity-analysis-solutions) |
| WF-M05 | Coating and layer cross-section metrology | Acquire calibrated sections -> identify interfaces -> measure thickness normal to interfaces -> detect discontinuities -> report local measurements and specimen variation. Uses sections 2, 6, 7, and 17. | Plating, thermal spray, barrier layers, thin-film sections. | [Layer/Coating Thickness Measurement Solutions](https://evidentscientific.com/en/landing/microscope-solutions-for-materialography/layer-coating-thickness-measurement-solutions) |
| WF-M06 | Weld quality and hardness mapping | Stitch a prepared weld section -> segment weld and affected regions -> measure visible defects -> correlate indent measurements -> export geometric and hardness maps. Uses sections 5, 7, 17, and 25. | Joining development, weld qualification, failure analysis. | [Measuring Weld Throat Thickness with EVIDENT Stream Image Analysis Software](https://ims.evidentscientific.com/en/applications/ie-measuring-weld-throat-thickness-with-evident-stream-image-analysis-software) |
| WF-M07 | Corrosion and wear progression | Acquire baseline and repeat topography or images -> register -> segment affected areas -> measure material change -> report pit, wear, and progression statistics. Uses sections 5, 8, 17, and 19. | Coatings, durability, tribology, corrosion research. | [Wear-volume measurement](https://www.zygo.com/applications/measurements/wear-volume) |
| WF-M08 | Additive-manufacturing characterization | Combine prepared sections and optional tomography -> measure melt pools, pores, cracks, and orientation -> map build locations -> compare specimens and process conditions. Uses sections 9, 17, 20, and 22. | Metal additive manufacturing, process development. | [Additive-manufacturing microscopy](https://asset-downloads.zeiss.com/catalogs/download/mic/9a2b3b52-84cc-45a1-8b82-9244ba959ce4/EN_wp_Applications_of_microscopy_in_additive_manufacturing.pdf) |
| WF-M09 | Composite and fiber characterization | Acquire representative sections or volumes -> segment fibers, matrix, and voids -> estimate orientation and fractions -> quantify interface defects -> report spatial distributions. Uses sections 6, 7, 9, and 17. | Aerospace composites, reinforced polymers, textiles. | [Estimate anisotropy in a 3D microscopy image](https://scikit-image.org/docs/stable/auto_examples/applications/plot_3d_structure_tensor.html) |
| WF-M10 | In situ micromechanics | Synchronize loading and images or volumes -> correlate deformation -> track cracks and interfaces -> compute strain with uncertainty checks -> link observations to load history. Uses sections 1, 8, 17, and 19. | Materials mechanics, fracture, thermal expansion studies. | [Microscopic DIC implementation](https://github.com/ElsevierSoftwareX/SOFTX-D-20-00054) |

### E. Optical component and photonic device workflows

| ID | Workflow | Brief sequence and principal outputs | Application areas | Ref Link |
| --- | --- | --- | --- | --- |
| WF-O01 | Optical surface cosmetic inspection | Use controlled illumination -> scan defined apertures -> detect scratches, pits, contamination, and chips -> apply the selected specification -> review and report annotated defects. Uses sections 1, 6, 7, and 18. | Lenses, mirrors, prisms, optical windows. | [Surface quality inspection example](https://www.edmundoptics.com/knowledge-center/application-notes/lasers/understanding-surface-quality-specifications) |
| WF-O02 | Coated optics qualification | Acquire reflection/transmission and surface data -> map visible coating defects -> analyze measured thickness or uniformity where supported -> combine optical performance evidence -> report findings. Uses sections 12, 18, and 19. | Filters, antireflection coatings, mirrors, coated windows. | [Optical coating applications](https://www.edmundoptics.com/capabilities/precision-optics/capabilities/optical-coatings/) |
| WF-O03 | Fiber connector inspect-clean-reinspect | Locate fibers and inspection regions -> classify contamination and damage -> record cleaning -> reacquire and compare -> report visual results alongside required optical tests. Uses sections 5, 6, 18, and 26. | Telecom, transceivers, fiber assembly. | [Fiber inspect-and-clean workflow](https://www.flukenetworks.com/edocs/wp-fiber-cleaning-and-inspection-white-paper) |
| WF-O04 | Microlens and diffractive optic metrology | Align array -> measure pitch, aperture, defects, and supported 3D form -> compare with nominal geometry -> export per-element and array summaries. Uses sections 7, 9, and 18-19. | Wafer-level optics, microlens arrays, diffractive devices. | [Microlens array measurement](https://www.zygo.com/applications/what-we-measure/micro-lenses) |
| WF-O05 | Imaging system characterization | Image calibrated targets and point sources under controlled conditions -> estimate distortion, PSF, MTF, and field dependence -> repeat configurations -> report measured performance. Uses sections 2, 7, and 18. | Objectives, microscope systems, camera modules. | [MTF characterization example](https://www.imatest.com/imaging/validating_slanted_edge/) |
| WF-O06 | Precision optical topography | Acquire interferometric or confocal measurements -> verify validity -> reconstruct height -> remove specified nominal form -> calculate form/texture metrics -> report uncertainty and masks. Uses sections 2, 9, 18, and 19. | Polished optics, micro-optics, precision surfaces. | [Interferometric surface measurement](https://www.zygo.com/support/technologies/csi-techology) |
| WF-O07 | Photonic assembly and coupling | Locate alignment features -> estimate coordinate transforms -> move supported axes -> optimize measured coupling -> verify position and stability -> save assembly settings and evidence. Uses sections 1, 2, 5, and 18. | Integrated photonics, fiber attachment, micro-optical assembly. | [Photonic coupling and alignment](https://www.pi-usa.us/fileadmin/user_upload/pi_us/files/catalogs/PI_Photonic_Fiber_Alignment_Engines.pdf) |

### F. Advanced scientific and cross-domain workflows

| ID | Workflow | Brief sequence and principal outputs | Application areas | Ref Link |
| --- | --- | --- | --- | --- |
| WF-R01 | Quantitative phase cell analysis | Acquire the required phase-sensitive measurements -> reconstruct complex field -> correct background -> segment cells -> estimate optical-path or justified mass metrics -> report quality. Uses sections 6, 10, and 13. | Label-free biotechnology, cell biophysics, computational imaging. | [Label-free drug-screening example](https://pmc.ncbi.nlm.nih.gov/articles/PMC9360018/) |
| WF-R02 | Single-molecule localization microscopy | Calibrate camera and PSF -> acquire sparse-emitter frames -> localize -> filter and correct drift -> render -> assess resolution and clustering -> export coordinates and uncertainties. Uses sections 2, 3, 7, and 11. | Molecular organization, membrane biology, advanced fluorescence. | [ThunderSTORM localization example](https://zitmen.github.io/thunderstorm/) |
| WF-R03 | FRAP, FRET, or FLIM assay | Select the appropriate acquisition mode and controls -> correct modality-specific artifacts -> fit recovery, transfer, or lifetime models -> examine residuals -> report parameter maps and uncertainty. Uses sections 2, 3, and 11. | Molecular mobility, interactions, metabolism, biosensors. | [FLIM analysis example](https://imagej.net/plugins/flimj/) |
| WF-R04 | Raman or FTIR chemical mapping | Calibrate spectra -> remove spikes and baseline -> fit peaks or unmix components -> validate reference matches -> correlate chemical maps with morphology -> export spectra-linked results. Uses sections 5, 7, and 12. | Contaminants, pharmaceuticals, polymers, semiconductors. | [Cell phenotyping](https://ramanspy.readthedocs.io/en/latest/auto_examples/plot_i_package_overview.html) |
| WF-R05 | Cryo-EM single-particle processing | Correct movies -> estimate transfer functions -> pick and classify particles -> reconstruct and refine -> evaluate independent-data resolution and artifacts -> export density and processing provenance. Uses sections 20, 25, and 26. | Structural biology, macromolecular research. | [Single particle tutorial](https://relion.readthedocs.io/en/release-5.0/SPA_tutorial/index.html) |
| WF-R06 | Crystallographic orientation and phase mapping | Acquire EBSD or electron diffraction data -> calibrate geometry -> index -> review confidence -> reconstruct grains and boundaries -> report texture and orientation statistics. Uses sections 17, 20, and 26. | Metals, ceramics, deformation, semiconductor materials. | [EBSD indexing example](https://kikuchipy.org/en/latest/tutorials/pattern_matching.html) |
| WF-R07 | AFM nanomechanical mapping | Calibrate probe and response -> acquire topography and force curves -> correct backgrounds -> select valid contact models -> fit properties -> report maps, residuals, and assumptions. Uses sections 2, 19, and 21. | Polymers, coatings, biomaterials, nanomechanics. | [Live-cell nanomechanics example](https://www.bruker.com/en/products-and-solutions/microscopes/materials-afm/resource-library/an-141-toward-quantitative-nanomechanical-measurements-on-live-cells-with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) |
| WF-R08 | 3D internal microstructure analysis | Acquire suitable tomographic or serial-section data -> correct and reconstruct -> segment phases -> measure pores and networks -> validate sensitivity -> report volumetric structure. Uses sections 5, 9, 20, and 22. | Batteries, catalysts, packages, porous media, tissue. | [Pore-network extraction example](https://porespy.org/examples/networks/tutorials/snow_advanced.html) |
| WF-R09 | Environmental particle identification | Define sampling and preparation -> detect particles -> measure morphology -> collect suitable chemical spectra -> classify with reviewed confidence -> report counts and identification limits. Uses sections 7, 12, and 23. | Microplastics, contamination, environmental science. | [Microplastic chemical mapping](https://www.renishaw.com/en/study-polymers-and-microplastics-with-raman-spectroscopy--25887) |
| WF-R10 | Reproducible batch research pipeline | Freeze recipe, controls, and model versions -> process representative pilot data -> validate -> run batch with checkpoints -> review exceptions -> export results and provenance. Uses sections 24-26. | Imaging cores, multi-experiment research, industrial analytics. | [Batch execution reports](https://www.nextflow.io/docs/latest/reports.html) |

## Part III: Implementation planning

### A. Build shared foundations before specialized application packs

The following sequence is an engineering dependency suggestion, not a ranking of customer demand.

1. **Shared data and measurement foundation:** multidimensional data, calibrated coordinates, metadata, raw-data preservation, viewing, annotations, import/export, provenance, and basic quality scoring.
2. **Reusable analysis core:** correction, filtering, registration, segmentation, object measurements, editable results, batch recipes, and uncertainty-aware reporting.
3. **Acquisition layer:** device interfaces, synchronization, focus control, stage calibration, scan planning, coordinate relocation, and recoverable acquisition.
4. **Application packs:** biology assays; wafer and electronics inspection; metallography; optics and surface metrology. Give each pack its own controls, reference examples, reports, and validation criteria.
5. **Specialized modality integrations:** phase reconstruction, advanced fluorescence, spectral imaging, electron microscopy, SPM, X-ray, and acoustic analysis as compatible instruments and representative datasets become available.

### B. Use a consistent contract for each implemented module

| Module property | What to define |
| --- | --- |
| Purpose | The scientific or manufacturing question and the quantity the module reports. |
| Required inputs | Supported dimensions, modalities, data types, axes, units, metadata, and controls. |
| Hardware dependencies | Required sensors, actuators, illumination, timing, or specialized measurements. |
| Calibration dependencies | Reference data, configuration matching, validity interval, and uncertainty contributions. |
| Parameters and defaults | Meaning, units, valid ranges, sample-specific choices, and recorded overrides. |
| Outputs | Images, masks, objects, tables, maps, spectra, tracks, transforms, uncertainty, and quality flags. |
| Failure handling | Detectable invalid conditions, review requirements, fallback behavior, and recovery rules. |
| Validation evidence | Representative specimens, reference methods, sampling design, measured errors, and known limits. |
| Execution behavior | Expected memory, CPU/GPU needs, streaming support, chunk boundaries, and reproducibility. |
| Review and provenance | Links back to raw evidence, editable intermediate results, versions, and decision history. |

### C. Avoid common interpretation errors

- Keep presentation contrast changes separate from quantitative intensity data. Report the processing path used for each measurement.
- Treat fields, cells, tiles, and specimens as different sampling levels. Statistical replication should match the experimental question.
- Report 2D areas and section-derived grain sizes as such; use 3D measurements or justified stereology for volumetric claims.
- Validate line-width and edge measurements against the actual imaging modality. Subpixel fitting alone does not establish traceable accuracy or resolve arbitrary sub-resolution features.
- Specify measurement bandwidth, sampling, filtering, masking, and reference-form removal for roughness or edge-roughness results.
- Keep uncertainty and detection limits visible when converting images into physical or biological quantities.
- Evaluate learned methods on held-out specimens, batches, instruments, or sites appropriate to deployment; avoid leakage from neighboring tiles or related time points.
- Record the selected standard and edition for standards-based workflows. Generic algorithm support does not establish conformity to an entire test procedure.

## Selected technical references

These primary documentation and standards links support further investigation. They are reference implementations and methodological starting points, not a claim that one package implements the full catalog or that every listed module is required. Standards landing pages describe scope; full procedures may require access to the standard itself.

| Reference | Relevant scope |
| --- | --- |
| [Micro-Manager user's guide: recording and autofocus](https://micro-manager.org/Micro-Manager_User%27s_Guide2) | Multidimensional acquisition, software and hardware focus, and position lists. |
| [ImageJ scientific imaging tutorials](https://imagej.net/imaging/) | Calibration, segmentation, registration, tracking, and quantitative image-analysis concepts. |
| [ImageJ deconvolution](https://imagej.net/imaging/deconvolution) | PSF-based optical restoration and practical input requirements. |
| [scikit-image morphology API](https://scikit-image.org/docs/stable/api/skimage.morphology) | Reusable morphology and reconstruction operators. |
| [TrackMate](https://imagej.net/plugins/trackmate/) | Detection, trajectory linking, measurements, and manual correction. |
| [CellProfiler examples](https://cellprofiler.org/examples) | Cell image analysis and assay-oriented pipelines. |
| [QuPath documentation](https://qupath.readthedocs.io/en/stable/index.html) | Whole-slide analysis, stain separation, cells, classification, and multiplexing. |
| [Nikon MicroscopyU fluorescence microscopy](https://www.microscopyu.com/techniques/fluorescence) | Fluorescence modalities, spectral imaging, and interaction-analysis background. |
| [Zheng, Horstmeyer, and Yang: Fourier ptychographic microscopy](https://www.nature.com/articles/nphoton.2013.187) | Primary description of angularly varied computational complex-image reconstruction. |
| [ZEISS semiconductor and electronics microscopy](https://www.zeiss.com/microscopy/us/applications/semiconductors-electronics.html) | Industry applications and complementary microscopy modalities. |
| [ASTM E112 scope](https://store.astm.org/e0112-13.html) | Average planar grain-size measurement; the link identifies a particular edition. |
| [ASTM E1382](https://store.astm.org/standards/e1382) | Grain-size measurement using semiautomatic and automatic image analysis. |
| [ASTM E45 scope](https://store.astm.org/e0045-18.html) | Inclusion-content methods for steel; the link identifies a particular edition. |
| [ISO 10110-7](https://committee.iso.org/standard/65444.html?browse=tc) | Specification of surface imperfections in optical elements and assemblies. |
| [IEC 61300-3-35](https://webstore.iec.ch/en/publication/64254) | Visual inspection of fiber optic connectors and fiber-stub transceivers. |
| [ZYGO coherence scanning interferometry](https://www.zygo.com/support/technologies/csi-techology) | Interferometric acquisition of optical surface topography. |
| [RELION documentation](https://relion.readthedocs.io/en/release-5.0/) | Cryo-EM single-particle and subtomogram processing. |
| [pyxem documentation](https://pyxem.org/) | Pixelated electron diffraction and multidimensional STEM analysis. |
| [Gwyddion user guide](https://gwyddion.net/documentation/user-guide-en/) | Scanning probe processing, surface statistics, tip effects, and force data. |
| [OME-TIFF documentation](https://docs.openmicroscopy.org/ome-model/latest/ome-tiff/) | Microscopy image storage and metadata. |
| [OME-NGFF specifications](https://ngff.openmicroscopy.org/) | Multiscale, chunked multidimensional bioimaging data and metadata. |
