lucaswewa/microscope/docs/milestone-2/goals.md

Let's start the milestone 2 planning. Besides our previous plan for the milestone 2, I want to add some requirements:
- add camera support for Basler and Allied Vision cameras, using the Pylon and Vimba X SDKs respectively.
- add stage support for Zaber XYZ stages, using their C++ SDK
- Tauri desktop app
- mDNS
- AutoDiscovery
- image correlation stitching
- RaspberryPi 5 support

make the plan first, as questions as needed.

---

*The previous plan for milestone 2 is the [readiness checklist](readiness.md): driver interfaces, correlation stitching, the Linux and Raspberry Pi question, and authentication. The answers to the planning questions, including talking to Zaber stages through their protocol rather than the C++ SDK, are in [§3 of the plan](implementation-plan.md#3-decisions-made-while-planning).*
