lucaswewa/microscope/docs/milestone-2/notes/P03b-sdks.md

# P03b: The SDKs at run time, and listing devices

- Status: In review
- Pull request: [#76](https://github.com/lucaswewa/microscope/pull/76)
- ADRs: [ADR-0041](../../adr/0041-hardware-drivers.md), from P03a
- Spec: [phases.md#p03b](../phases.md#p03b)

## Summary

The camera SDKs load at run time where they're installed, and say how to get them where they aren't. `microscope-server --list-devices` prints what every driver finds, for writing a configuration.

- **`microscope-sdk`,** a new crate, loads pylon's and Vimba X's C APIs. It's the workspace's only crate with unsafe code, as ADR-0041 decided.
- **On the owner's Windows PC,** both load and work: pylon finds no cameras, and Vimba X 3.
- **The server runs without them,** as in CI.

## What was built

| Where | What |
|---|---|
| `crates/microscope-sdk/src/lib.rs` | The loader: `SdkError` (not installed, unusable, or a call that failed), the search, and a lock so one SDK starts at a time |
| `crates/microscope-sdk/src/pylon.rs` | `Pylon`: `load`, `path`, `count_cameras` |
| `crates/microscope-sdk/src/vimba.rs` | `VimbaX`: `load`, `path`, `version`, `count_cameras` |
| `crates/microscope-things/src/drivers/mod.rs` | `list_devices`: what each driver finds, or why it couldn't look |
| `crates/microscope-things/src/drivers/serial.rs` | `ports`: the serial ports |
| `crates/microscope-server/src/cli.rs` | `--list-devices` |
| `release/about.toml` | ISC accepted, for `libloading` |
| `CLAUDE.md` | Unsafe code only in `microscope-sdk` |

### Where each SDK is looked for

| SDK | Windows | Linux |
|---|---|---|
| pylon | `PylonC_v10.dll` in `Runtime\x64`, in `PYLON_DEV_DIR`'s folder or `Program Files\Basler\pylon`; then on `PATH` | `libpylonc.so` in `$PYLON_ROOT/lib`, then `/opt/pylon/lib`; then the system's search |
| Vimba X | `VmbC.dll` in `api\bin`, in `VIMBA_X_HOME` or `Program Files\Allied Vision\Vimba X`; then on `PATH` | `libVmbC.so` in `$VIMBA_X_HOME/api/lib`; then the system's search |

`MICROSCOPE_PYLON_LIBRARY` and `MICROSCOPE_VIMBA_X_LIBRARY` name a library in place of the search.

## How to try it

1. **List the devices:**

   ```sh
   cargo run -p microscope-server -- --list-devices
   ```

   On the owner's PC:

   ```text
   Serial ports, a stage's `port`:
     none
   Basler cameras, through pylon:
     0 cameras found, with pylon at C:\Program Files\Basler\pylon\Runtime\x64\PylonC_v10.dll
   Allied Vision cameras, through Vimba X:
     3 cameras found, with Vimba X 1.3.2 at C:\Program Files\Allied Vision\Vimba X\api\bin\VmbC.dll
   ```

2. **Without an SDK,** say by pointing at a library that isn't there, the line says so:

   ```sh
   MICROSCOPE_PYLON_LIBRARY=C:/nowhere/PylonC_v10.dll cargo run -p microscope-server -- --list-devices
   ```

   ```text
   Basler cameras, through pylon:
     pylon isn't installed: it isn't at C:/nowhere/PylonC_v10.dll. Install it from https://www.baslerweb.com/pylon, or set MICROSCOPE_PYLON_LIBRARY to its library's path
   ```

3. **On the Pi,** with pylon or Vimba X for Linux ARM64 installed, the same command shows whether they load there.
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
