lucaswewa/microscope/electronics/carrier/kicad/fab/carrier-top.png

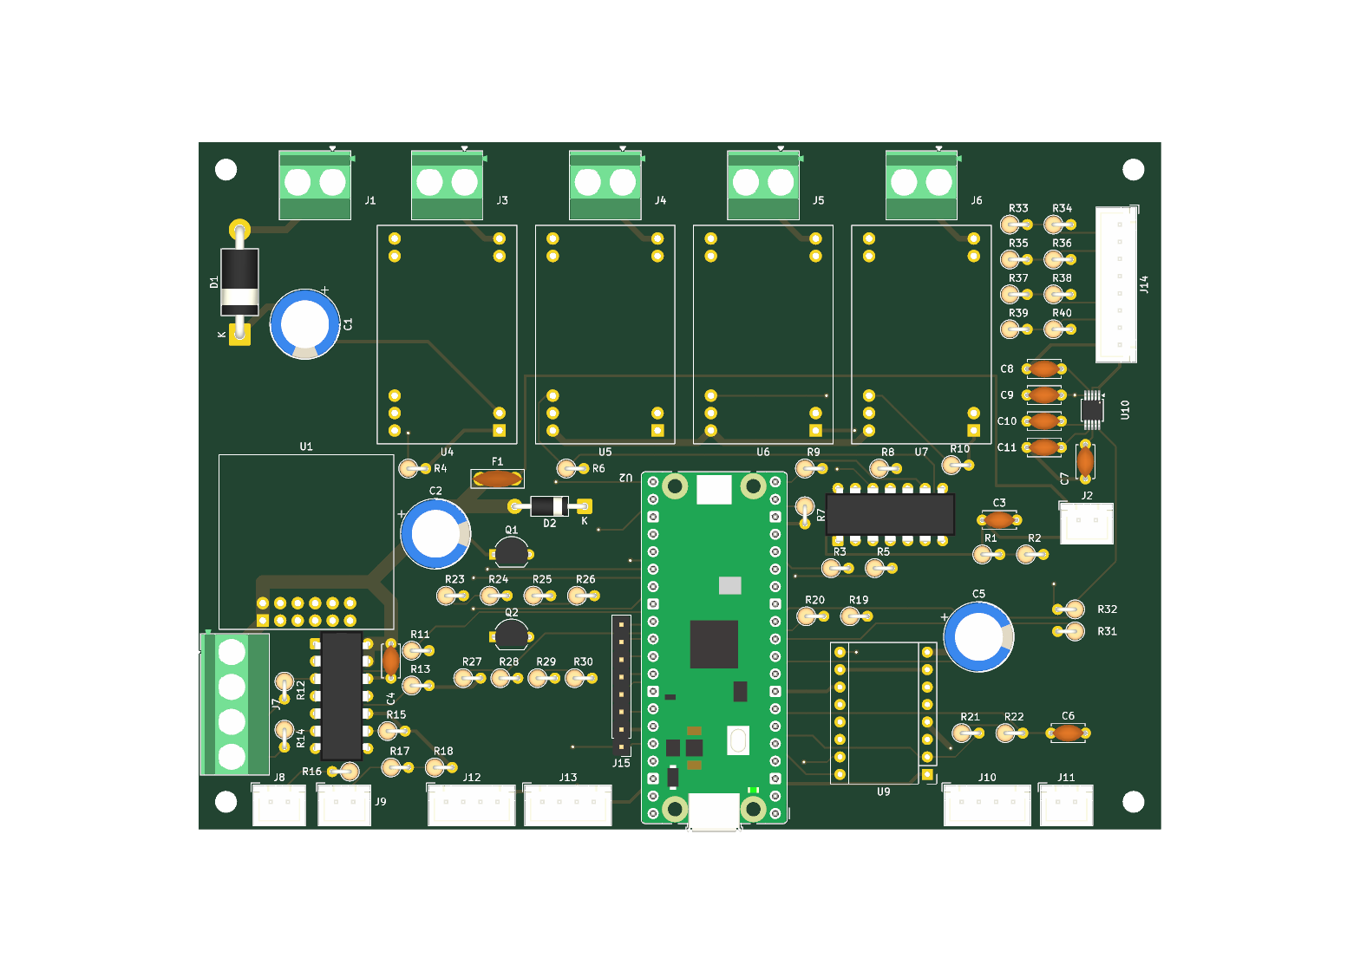
electronics/carrier/kicad/fab/carrier-top.png
