lucaswewa/microscope/web/tests/visual/shell.spec.ts-snapshots/control-dark-1920-chromium-win32.png

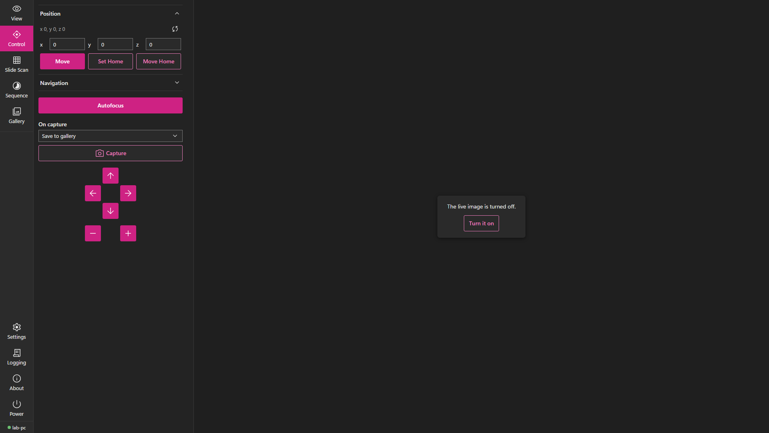
web/tests/visual/shell.spec.ts-snapshots/control-dark-1920-chromium-win32.png
