lucaswewa/microscope/web/tests/visual/shell.spec.ts-snapshots/control-dark-chromium-win32.png

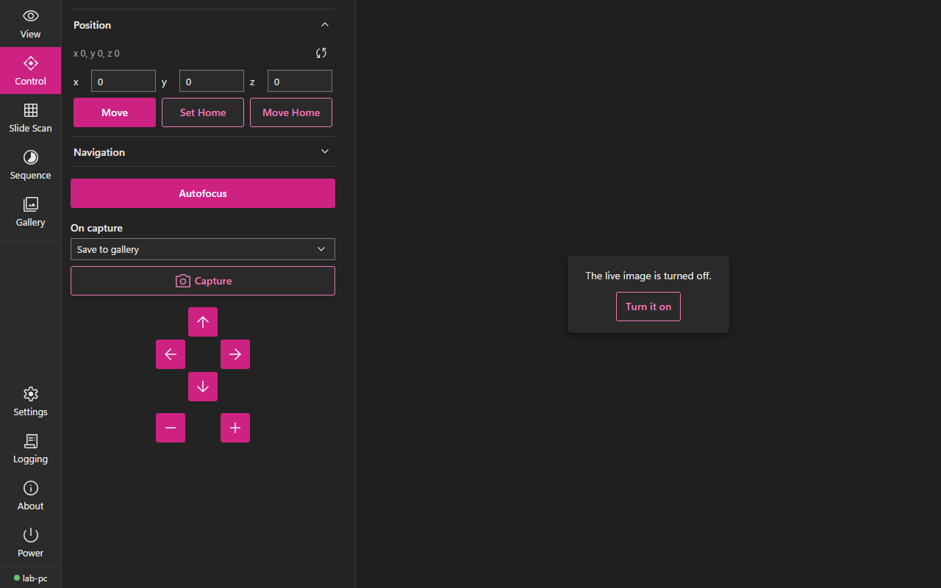
web/tests/visual/shell.spec.ts-snapshots/control-dark-chromium-win32.png
