lucaswewa/microscope/web/tests/visual/shell.spec.ts-snapshots/control-light-1920-chromium-win32.png

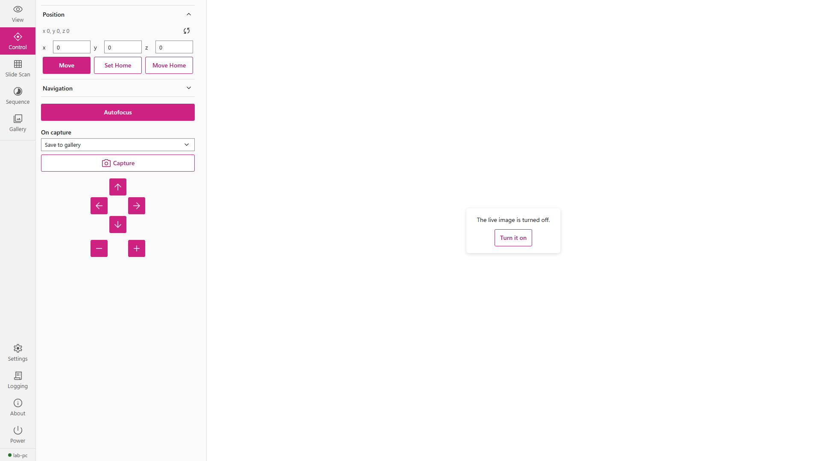
web/tests/visual/shell.spec.ts-snapshots/control-light-1920-chromium-win32.png
