lucaswewa/microscope/web/tests/visual/shell.spec.ts-snapshots/control-light-chromium-win32.png

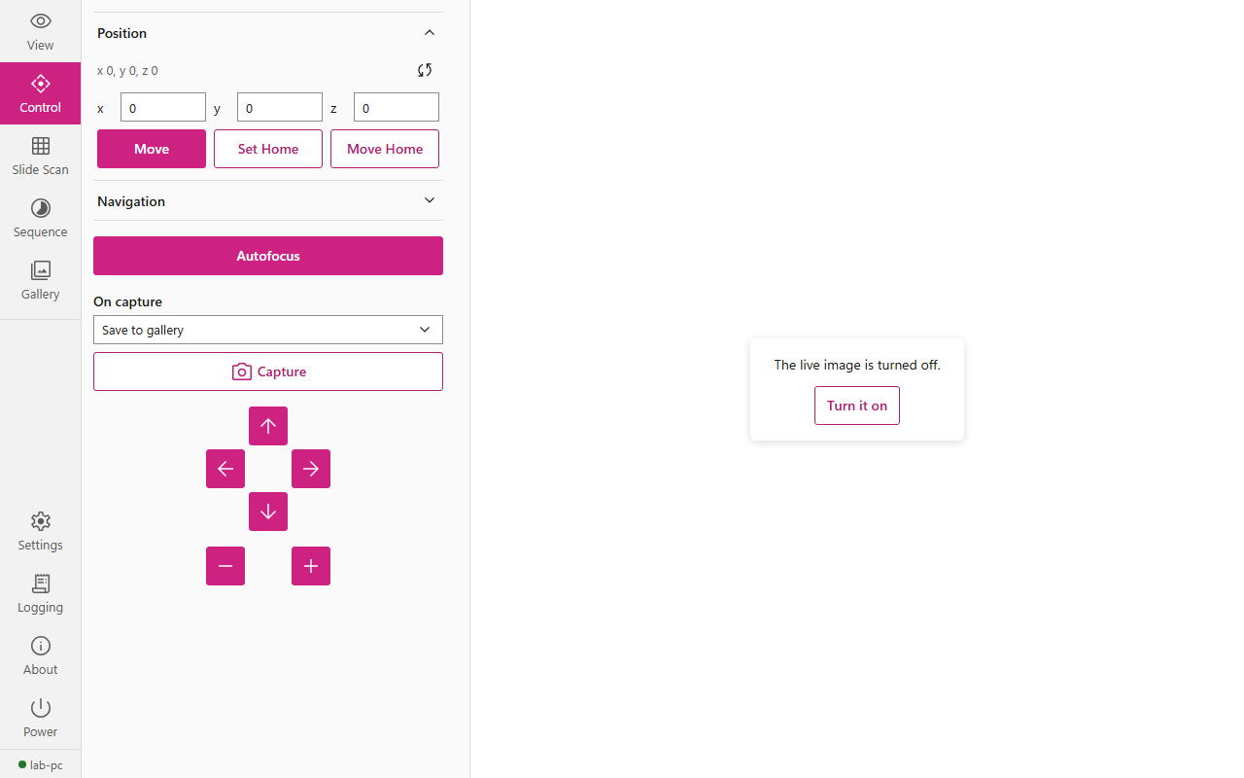
web/tests/visual/shell.spec.ts-snapshots/control-light-chromium-win32.png
