lucaswewa/microscope/web/tests/visual/shell.spec.ts-snapshots/gallery-dark-chromium-win32.png

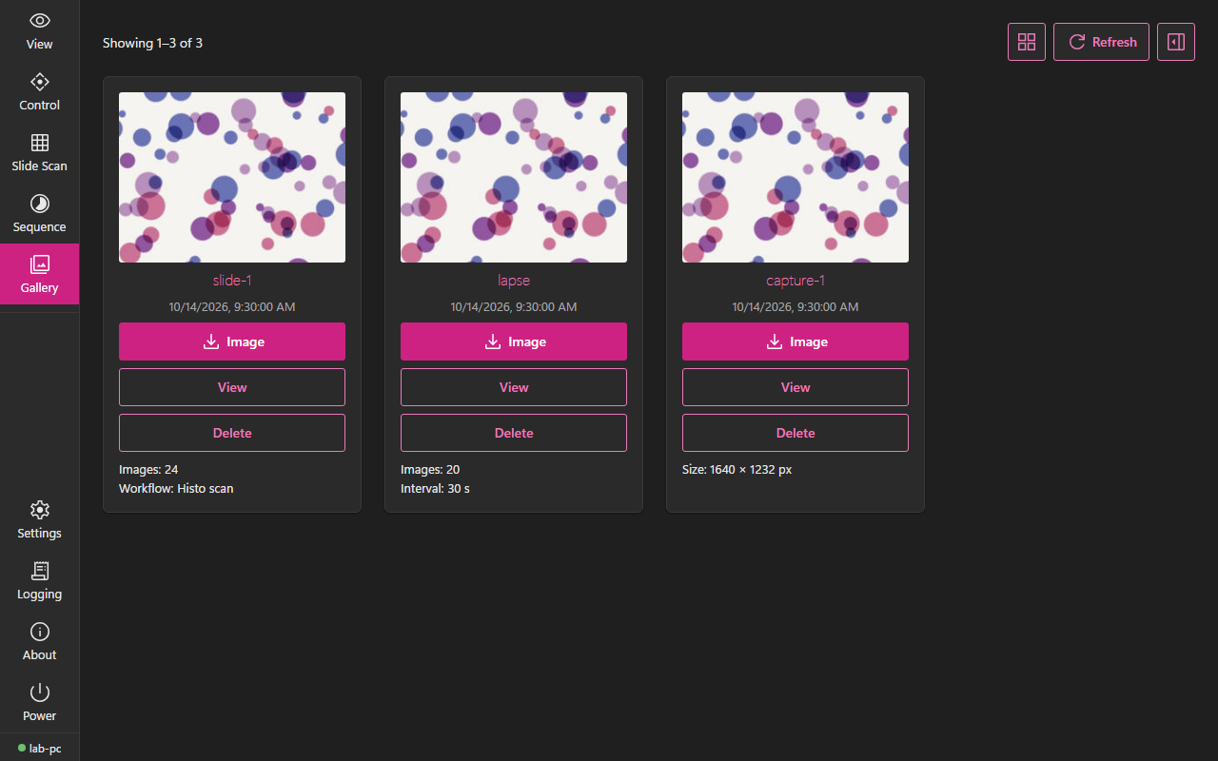
web/tests/visual/shell.spec.ts-snapshots/gallery-dark-chromium-win32.png
