lucaswewa/microscope/web/tests/visual/shell.spec.ts-snapshots/gallery-light-1920-chromium-win32.png

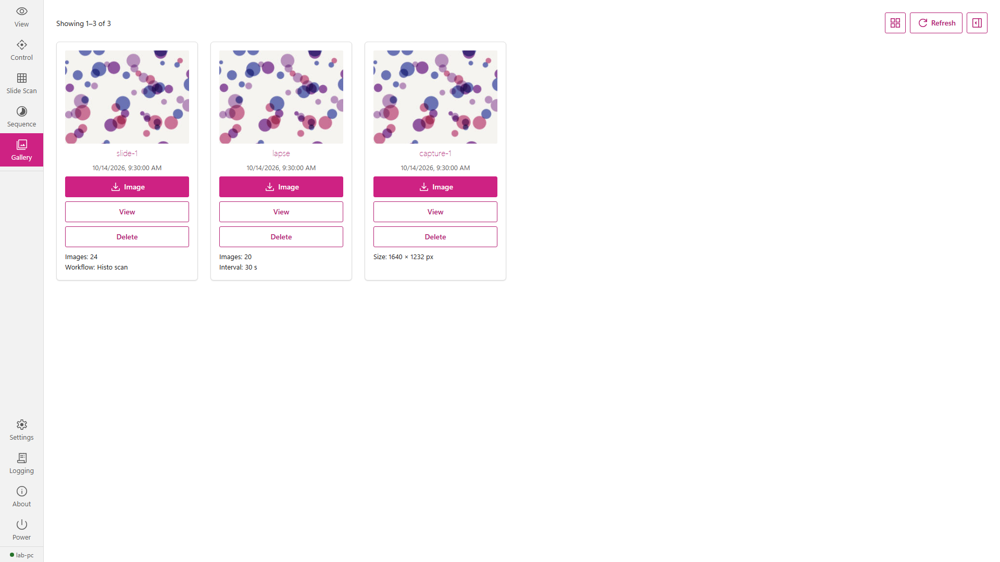
web/tests/visual/shell.spec.ts-snapshots/gallery-light-1920-chromium-win32.png
