lucaswewa/microscope/web/tests/visual/shell.spec.ts-snapshots/gallery-light-chromium-win32.png

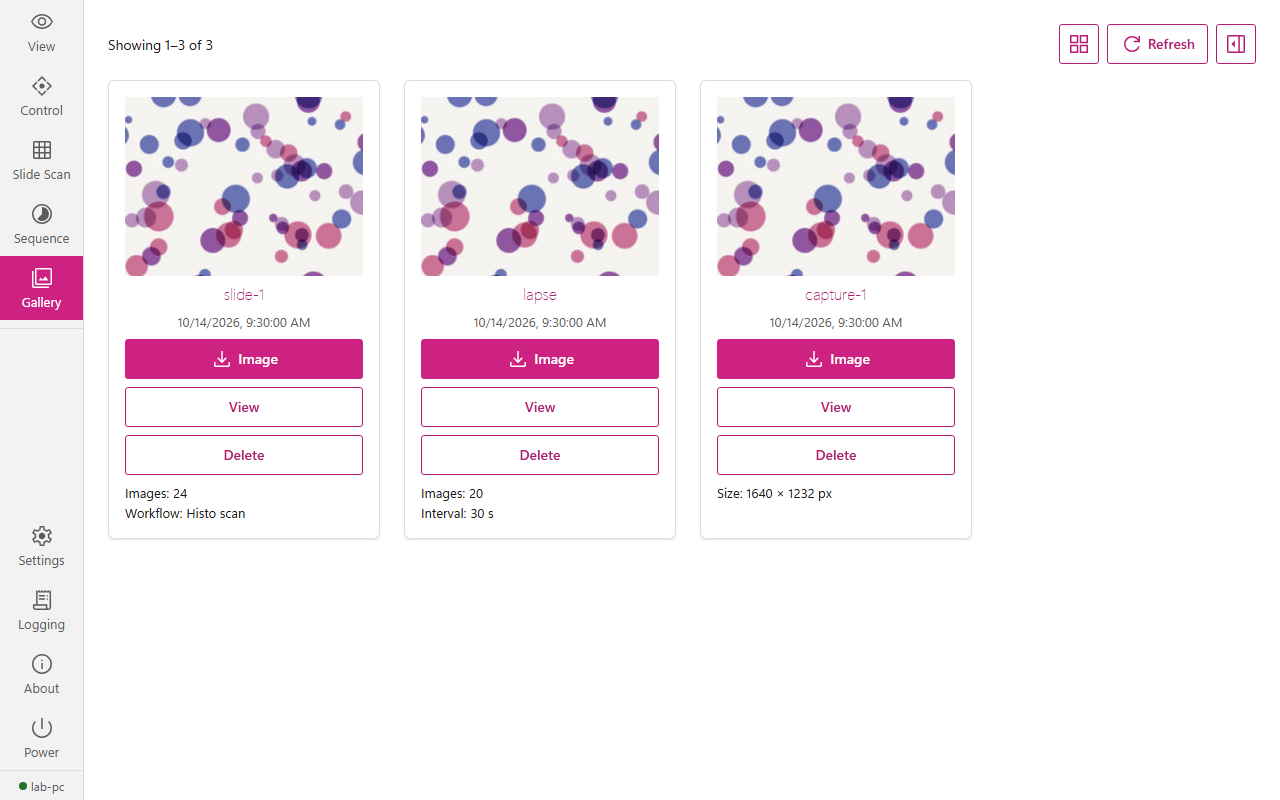
web/tests/visual/shell.spec.ts-snapshots/gallery-light-chromium-win32.png
