lucaswewa/microscope/web/tests/visual/shell.spec.ts-snapshots/gallery-viewer-dark-chromium-win32.png

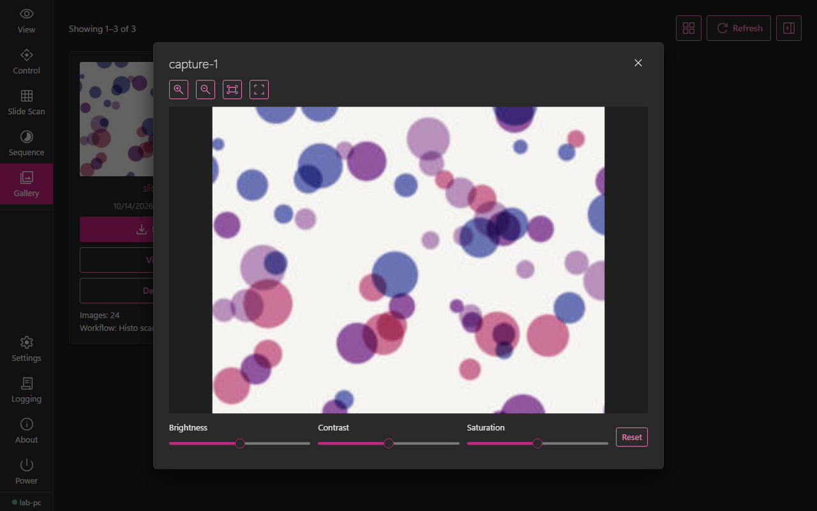
web/tests/visual/shell.spec.ts-snapshots/gallery-viewer-dark-chromium-win32.png
