lucaswewa/microscope/web/tests/visual/shell.spec.ts-snapshots/gallery-viewer-light-chromium-win32.png

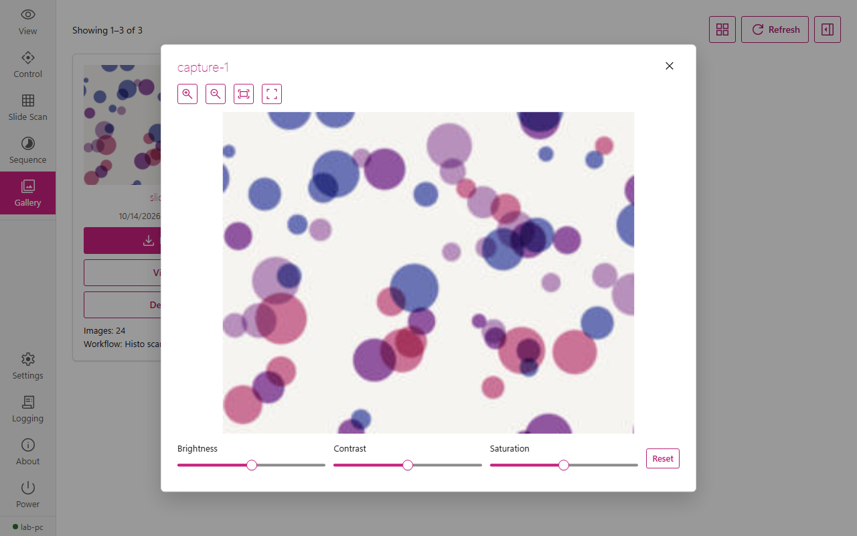
web/tests/visual/shell.spec.ts-snapshots/gallery-viewer-light-chromium-win32.png
