lucaswewa/microscope/web/tests/visual/shell.spec.ts-snapshots/logging-light-chromium-win32.png

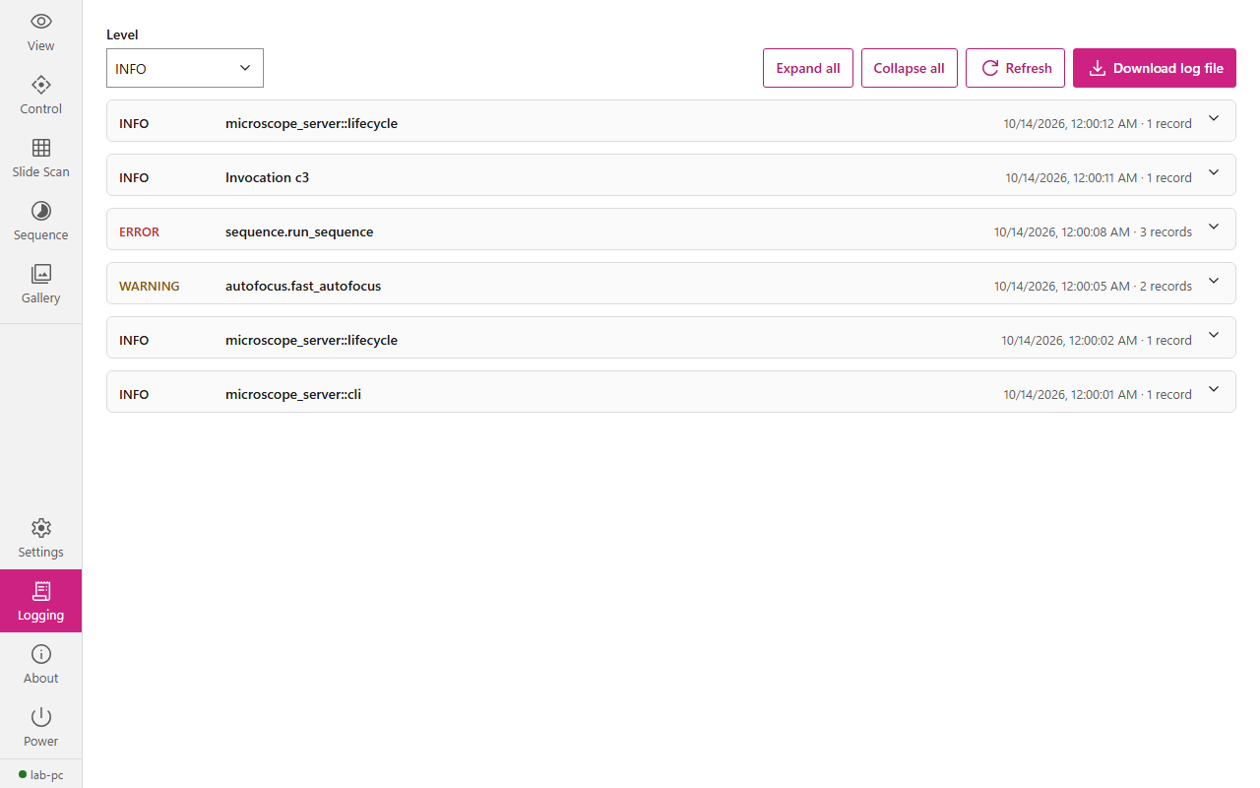
web/tests/visual/shell.spec.ts-snapshots/logging-light-chromium-win32.png
