lucaswewa/microscope/web/tests/visual/shell.spec.ts-snapshots/power-shut-down-dark-chromium-win32.png

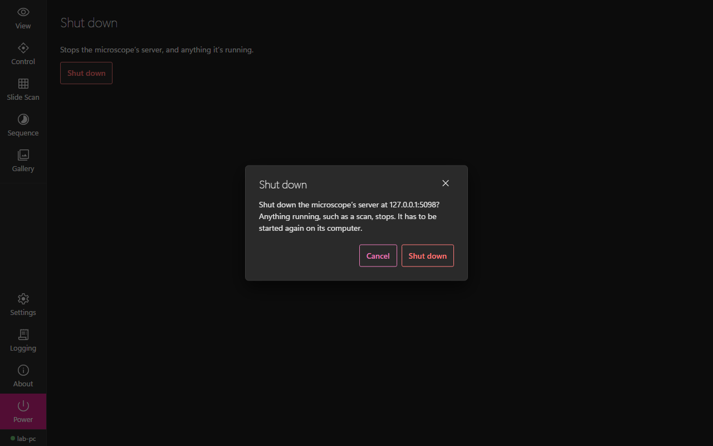
web/tests/visual/shell.spec.ts-snapshots/power-shut-down-dark-chromium-win32.png
