lucaswewa/microscope/web/tests/visual/shell.spec.ts-snapshots/sequence-light-chromium-win32.png

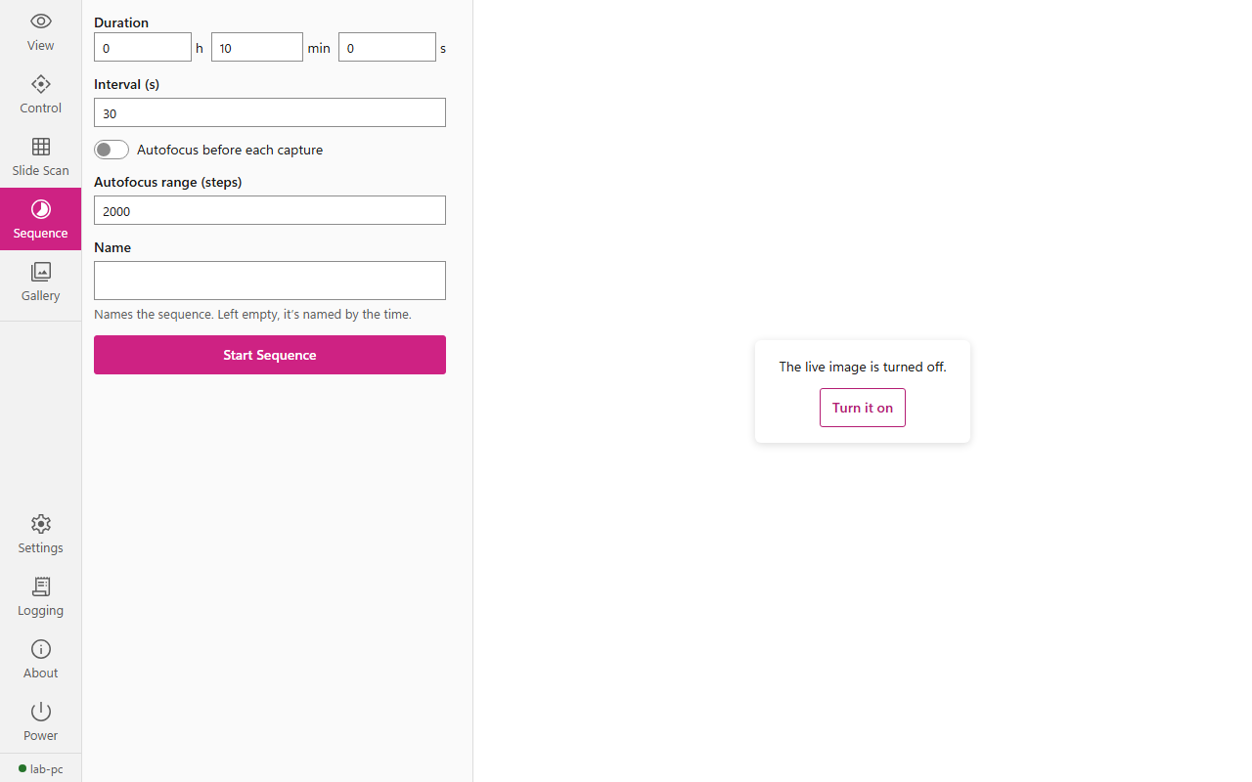
web/tests/visual/shell.spec.ts-snapshots/sequence-light-chromium-win32.png
