lucaswewa/microscope/web/tests/visual/shell.spec.ts-snapshots/settings-camera-dark-chromium-win32.png

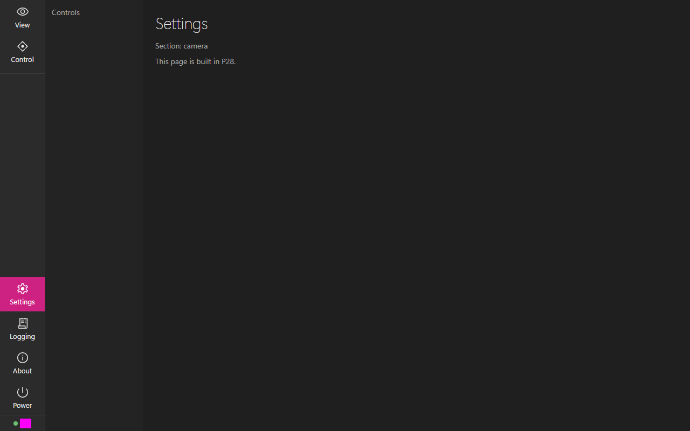
web/tests/visual/shell.spec.ts-snapshots/settings-camera-dark-chromium-win32.png
