lucaswewa/microscope/web/tests/visual/shell.spec.ts-snapshots/settings-camera-light-chromium-win32.png

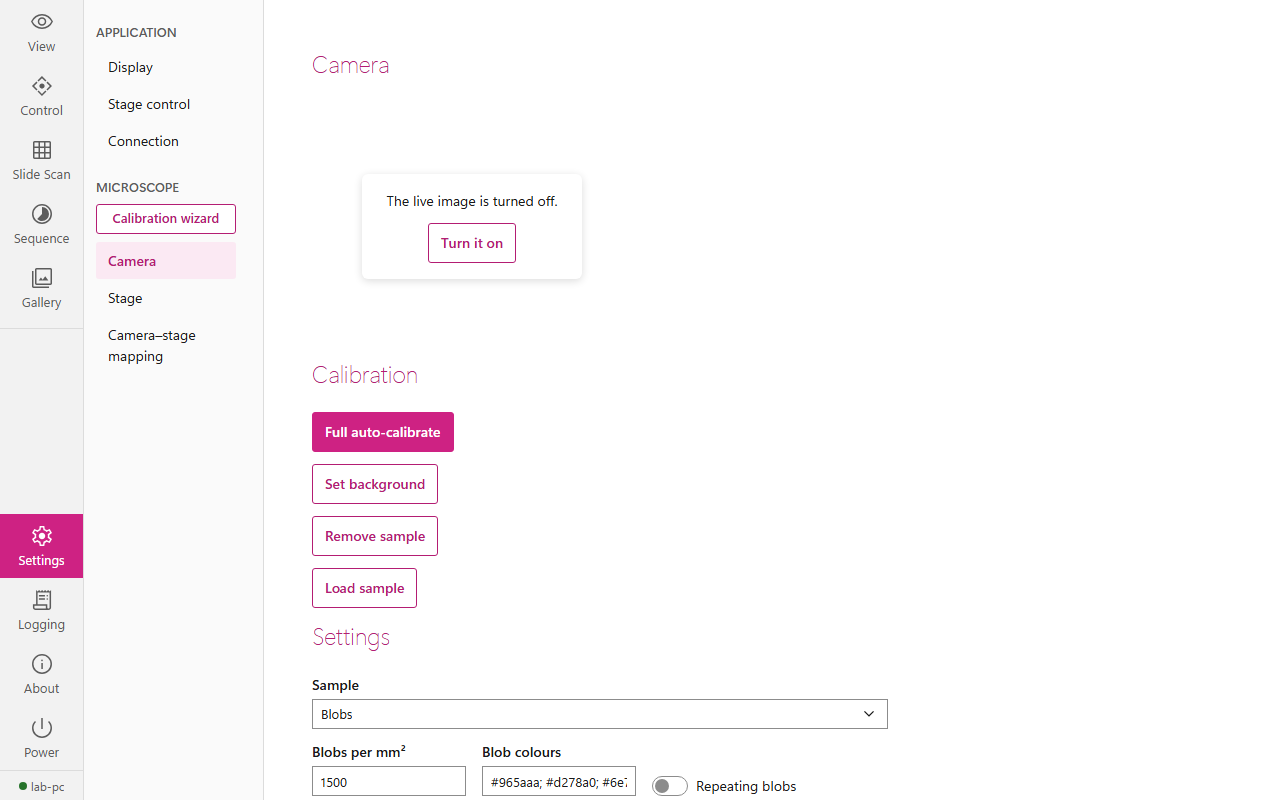
web/tests/visual/shell.spec.ts-snapshots/settings-camera-light-chromium-win32.png
