lucaswewa/microscope/web/tests/visual/shell.spec.ts-snapshots/settings-connection-dark-chromium-win32.png

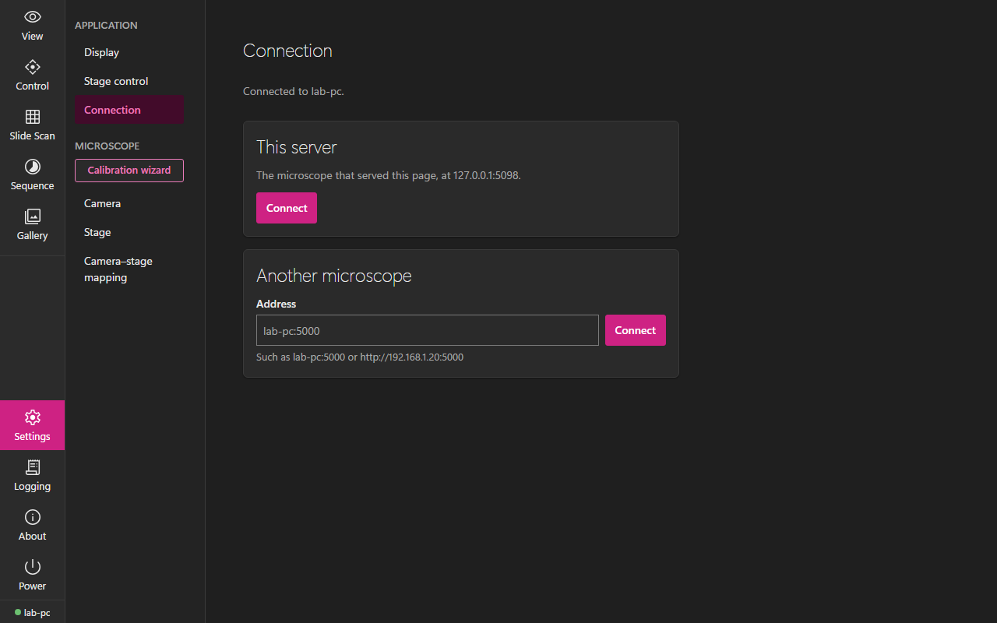
web/tests/visual/shell.spec.ts-snapshots/settings-connection-dark-chromium-win32.png
