lucaswewa/microscope/web/tests/visual/shell.spec.ts-snapshots/settings-display-light-chromium-win32.png

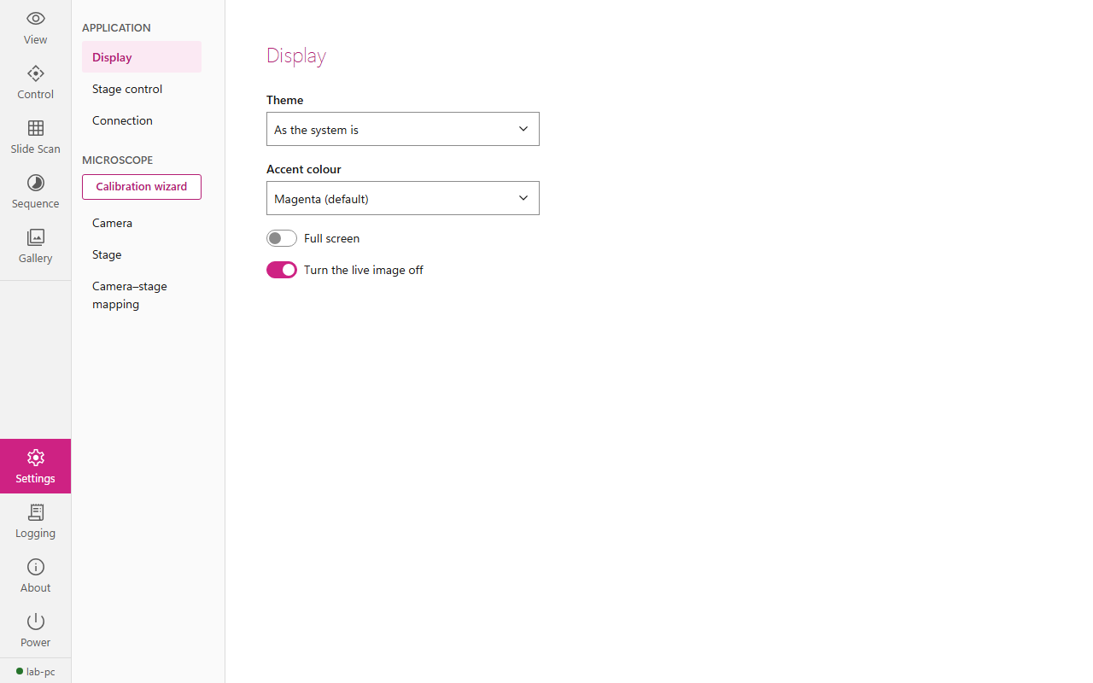
web/tests/visual/shell.spec.ts-snapshots/settings-display-light-chromium-win32.png
