lucaswewa/microscope/web/tests/visual/shell.spec.ts-snapshots/slide-scan-light-chromium-win32.png

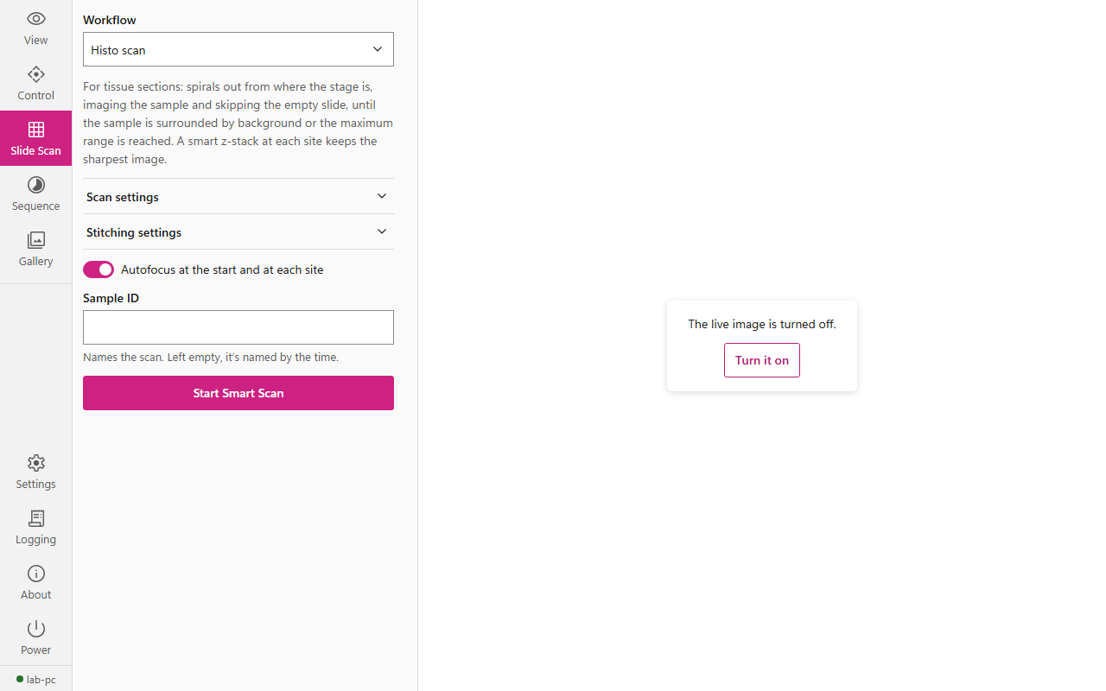
web/tests/visual/shell.spec.ts-snapshots/slide-scan-light-chromium-win32.png
