lucaswewa/microscope/web/tests/visual/shell.spec.ts-snapshots/view-dark-chromium-win32.png

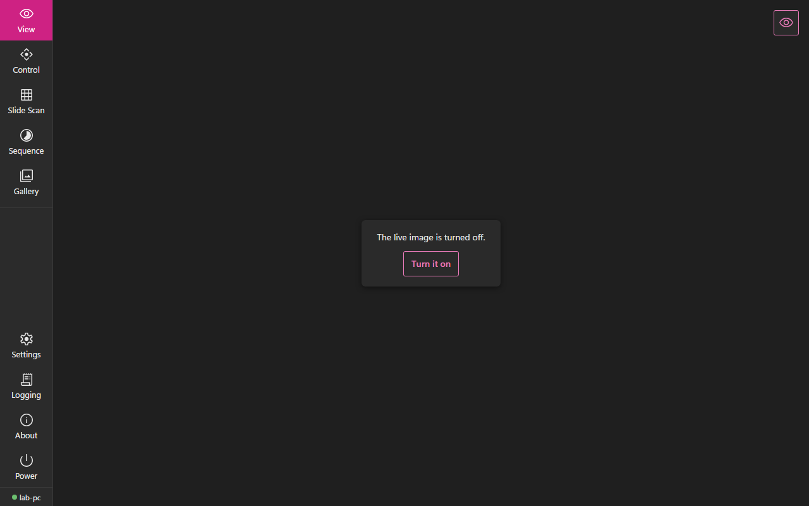
web/tests/visual/shell.spec.ts-snapshots/view-dark-chromium-win32.png
