lucaswewa/microscope/electronics/carrier/kicad/fab/carrier-bom.csv

Comment | Designator | Footprint | LCSC Part #
ADS1115IDGSR | U10 | TSSOP-10 3 x 3 mm | C37593
