lucaswewa/microscope/cad/optima/models/electronics.FCStd

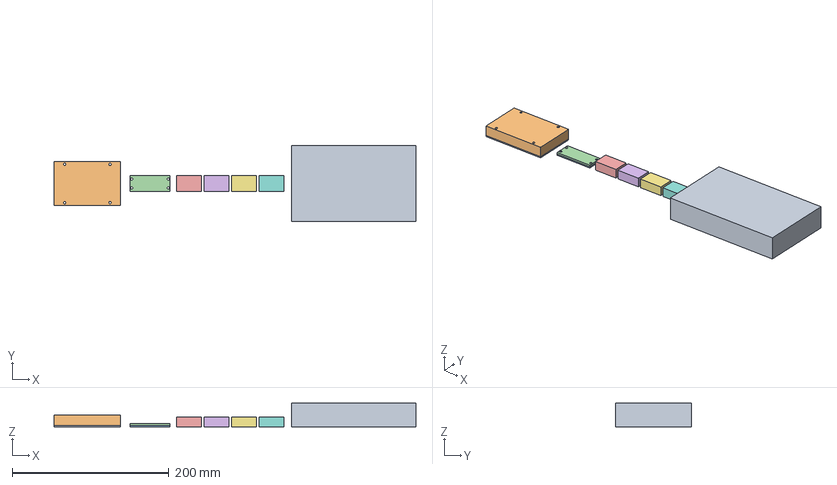
[picture p26: CAD file, 2026-11-02]
cad/optima/models/electronics.FCStd
462.0 x 97.0 x 30.0 mm
SkrPicoPcb
SkrPicoParts
Pico2Pcb
Pico2Parts
LED driver 1: Mean Well LDD-H
LED driver 2: Mean Well LDD-H
LED driver 3: Mean Well LDD-H
LED driver 4: Mean Well LDD-H
Mean Well LRS-150-24
