lucaswewa/microscope/cad/optima/outputs/step/OPTIMA-E09-control-tray.step

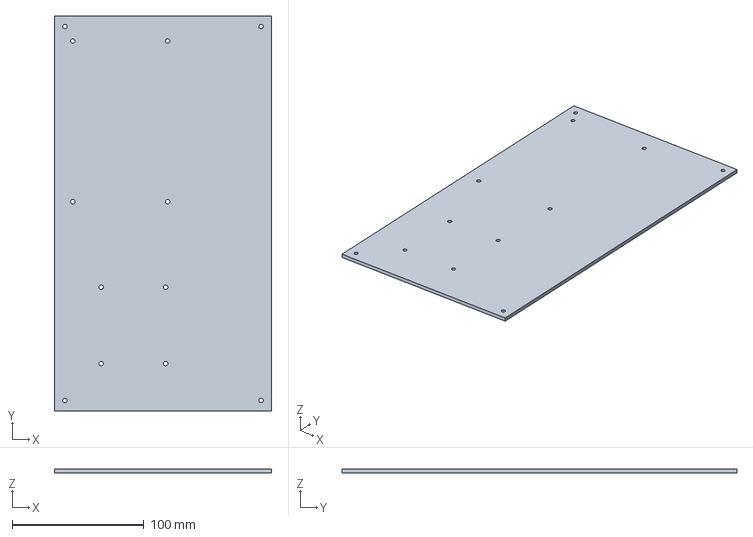
[picture p27: CAD file, 2026-11-02]
cad/optima/outputs/step/OPTIMA-E09-control-tray.step
165.0 x 300.0 x 3.00 mm
