lucaswewa/microscope/cad/optima/models/motion-parts.FCStd

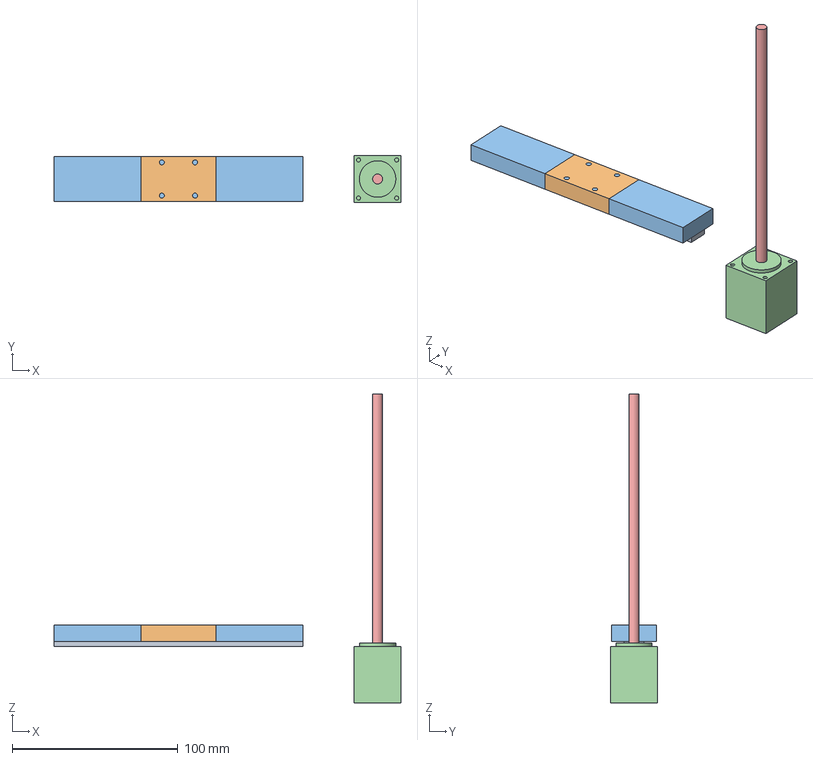
[picture p28: CAD file, 2026-11-01]
cad/optima/models/motion-parts.FCStd
209.1 x 28.2 x 186.0 mm
GuideRail
GuideCarriage
Swept by the carriage
StepperMotor
StepperScrew
