lucaswewa/microscope/cad/optima/outputs/step/OPTIMA-S01-base-plate.step

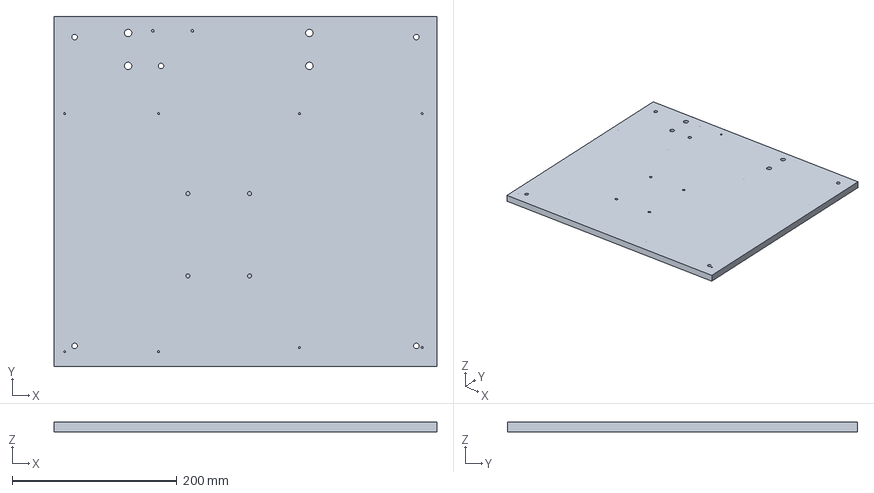
[picture p29: CAD file, 2026-11-02]
cad/optima/outputs/step/OPTIMA-S01-base-plate.step
465.0 x 425.0 x 12.0 mm
