lucaswewa/microscope/cad/optima/models/stand.FCStd

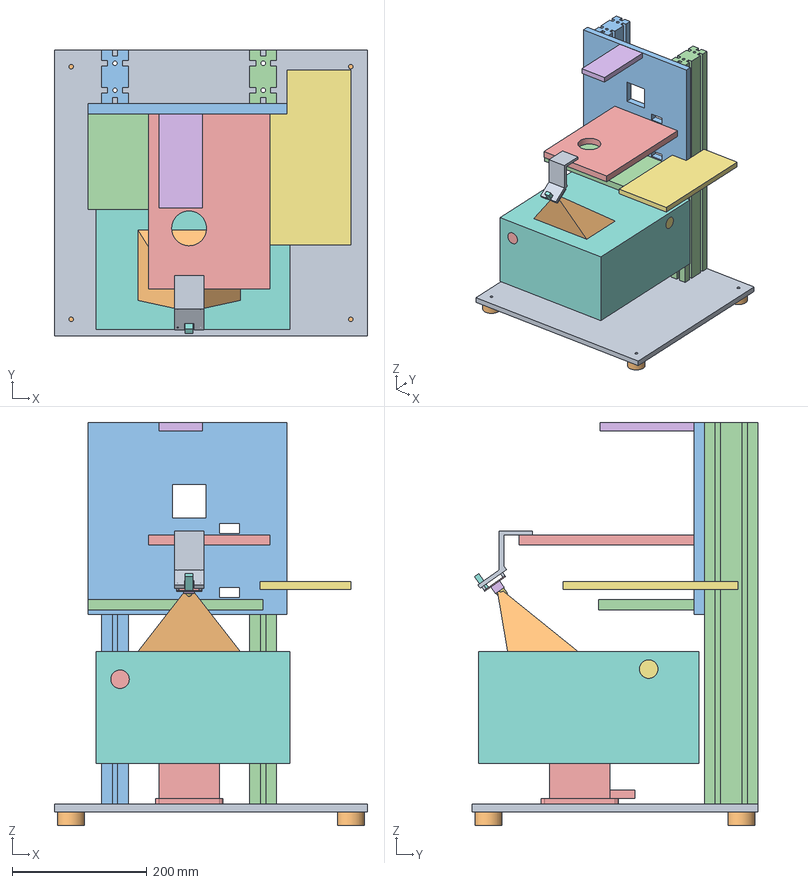
[picture p30: CAD file, 2026-11-01]
cad/optima/models/stand.FCStd
465.0 x 425.0 x 598.1 mm
Base plate
Rubber feet
Column, left
Column, right
Z lift: Standa 8MVT100-25-1
Lift's top
Plate on the lift
Spacers under the XY stage
LED matrix's mount
LED matrix: Adafruit 2734
LED matrix's LEDs
XY stage's base plate
XY stage's Y drive
XY stage's middle plate
XY stage's X drive
XY stage's top plate
Insert adapter
Four-slide insert
Slides and cover glasses
Overview camera's sensor
Overview camera's board
Overview camera's holder
Overview camera's lens
Room for the overview camera's plug
Overview camera's bracket
The overview camera's view of the insert, the stage at the front of its travel
Head plate
Lower deck
Upper deck
Camera port's bracket
Epi plate
Swept by the stage stack over the lift's and the stage's travel
