lucaswewa/microscope/cad/optima/models/instrument.FCStd

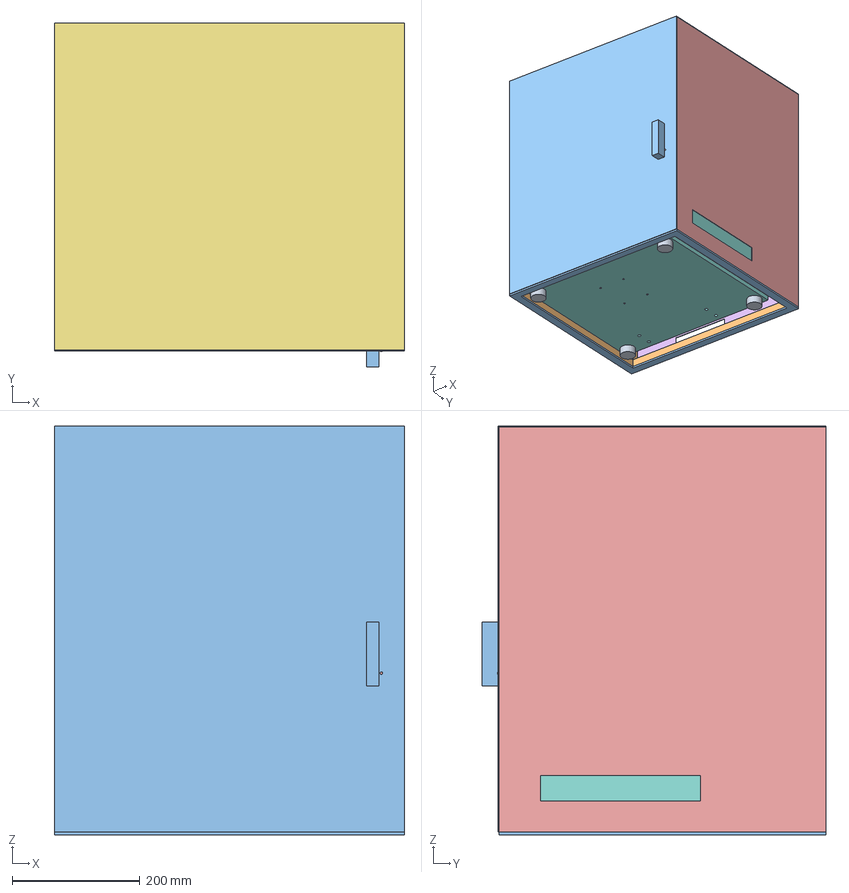
[picture p31: CAD file, 2026-11-01]
cad/optima/models/instrument.FCStd
548.0 x 538.0 x 639.6 mm
Head plate
Lower deck: the changer
Upper deck: the tube lens, slider and cameras
Camera port's bracket
Epi plate
Changer plate, with its nut block and grooves
Objectives: 5x, 10x, 20x
Changer's MGN12H carriage
Changer's rail
Changer's motor
Changer's screw
Changer's bracket
Changer's detent block
Changer's ball plunger
Changer's switch
Slider's carrier: (a) quad cube, (b) open, (c) 50:50
Chroma 89402 in (a), a 50:50 plate in (c)
Slider's MGN12H carriage
Slider's rail
Slider's motor
Slider's screw
Slider's bracket
Slider's switch
Tube lens: Thorlabs TTL200-A, in the deck's SM2 thread
Fold mirror's mount
Fold mirror
Camera port: Thorlabs MFF102/M, upside down
Camera port's arm and ring, position 1
Camera port's mirror: light to the colour camera
Mono camera
Mono sensor
Room for the mono camera's plugs
Mono camera's focus plate
Mono camera's mount
Colour camera
Colour sensor
Room for the colour camera's plugs
Colour camera's focus plate
Colour camera's mount
Epi lens's SM1 tube
Cage plates: the lens tube's, the field stop's
Cage rods
Cage cubes: the fold's and the combiners'
Combiners' dichroics
Epi fold mirror
Collectors' SM1 tubes
Mounted LEDs
Base plate
Rubber feet
Column, left
Column, right
Z lift: Standa 8MVT100-25-1
Lift's top
Plate on the lift
Spacers under the XY stage
LED matrix's mount
LED matrix: Adafruit 2734
LED matrix's LEDs
XY stage's base plate
XY stage's Y drive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
