lucaswewa/microscope/cad/optima/outputs/step/OPTIMA-H02-lower-deck.step

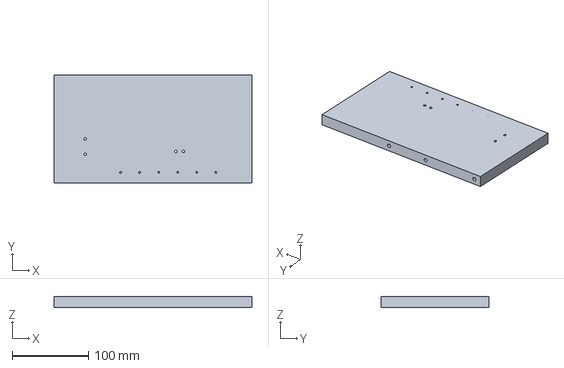
[picture p32: CAD file, 2026-11-01]
cad/optima/outputs/step/OPTIMA-H02-lower-deck.step
260.0 x 142.0 x 15.0 mm
