lucaswewa/microscope/cad/optima/models/epi-optics.FCStd

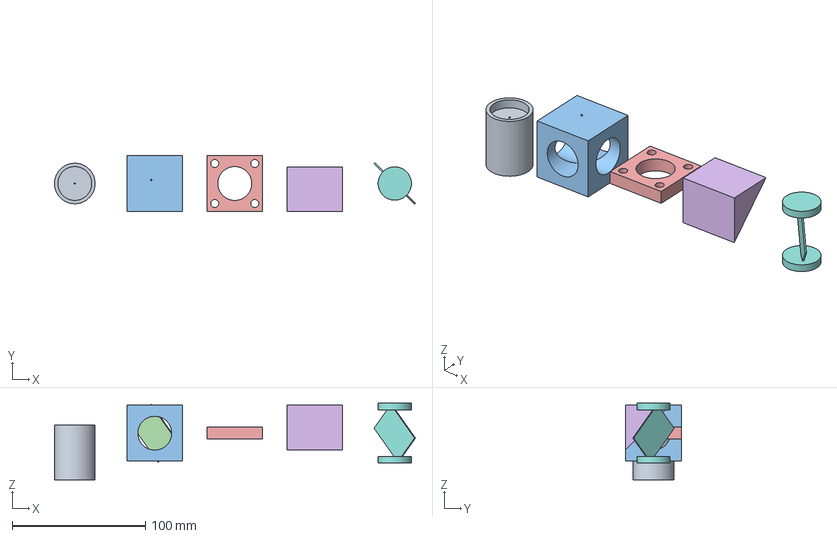
[picture p33: CAD file, 2026-11-01]
cad/optima/models/epi-optics.FCStd
270.8 x 41.9 x 57.5 mm
LedHousing
LedDie
CombinerCube
CombinerDichroic
30 mm cage plate
EpiFoldCube
EpiFoldMirror
Chroma 89402: exciter, dichroic, emitter
