lucaswewa/microscope/cad/optima/outputs/step/OPTIMA-H08-detent-block.step

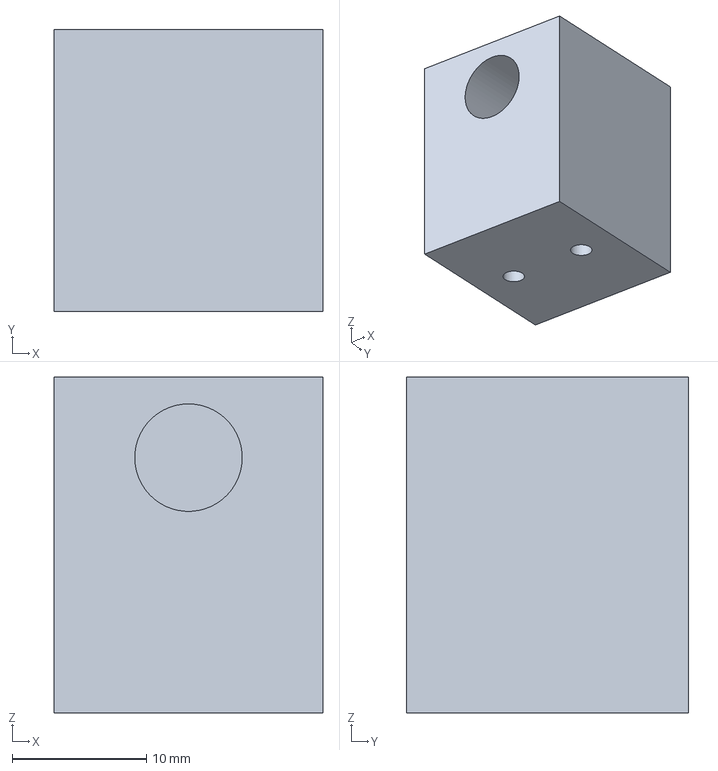
[picture p34: CAD file, 2026-11-01]
cad/optima/outputs/step/OPTIMA-H08-detent-block.step
20.0 x 21.0 x 25.0 mm
