lucaswewa/microscope/cad/optima/models/imaging-optics.FCStd

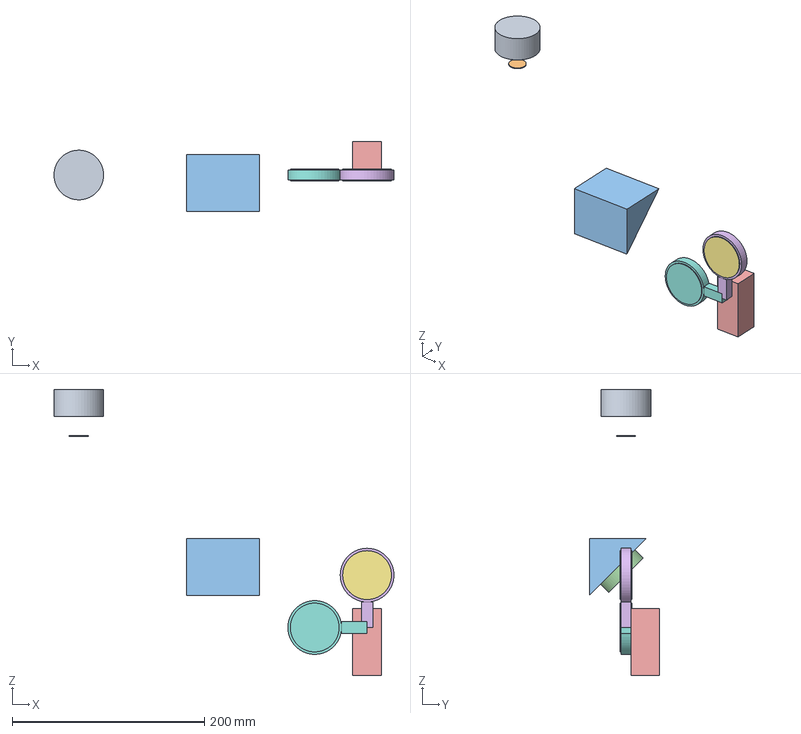
[picture p35: CAD file, 2026-11-01]
cad/optima/models/imaging-optics.FCStd
353.8 x 73.1 x 297.7 mm
TubeHousing
TubePupil
FoldCube
FoldMirror
PortBody
PortSwing
PortMirror
Position 2: the mirror out
