lucaswewa/microscope/cad/optima/outputs/step/OPTIMA-H16-epi-plates-bracket.step

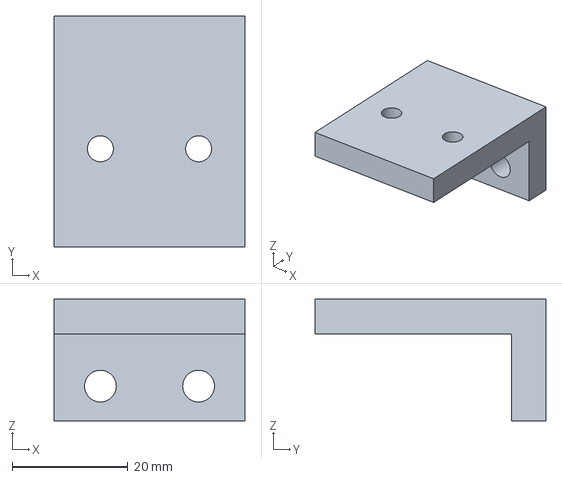
[picture p36: CAD file, 2026-11-01]
cad/optima/outputs/step/OPTIMA-H16-epi-plates-bracket.step
33.0 x 40.0 x 21.1 mm
