lucaswewa/microscope/cad/optima/models/colour-camera.FCStd

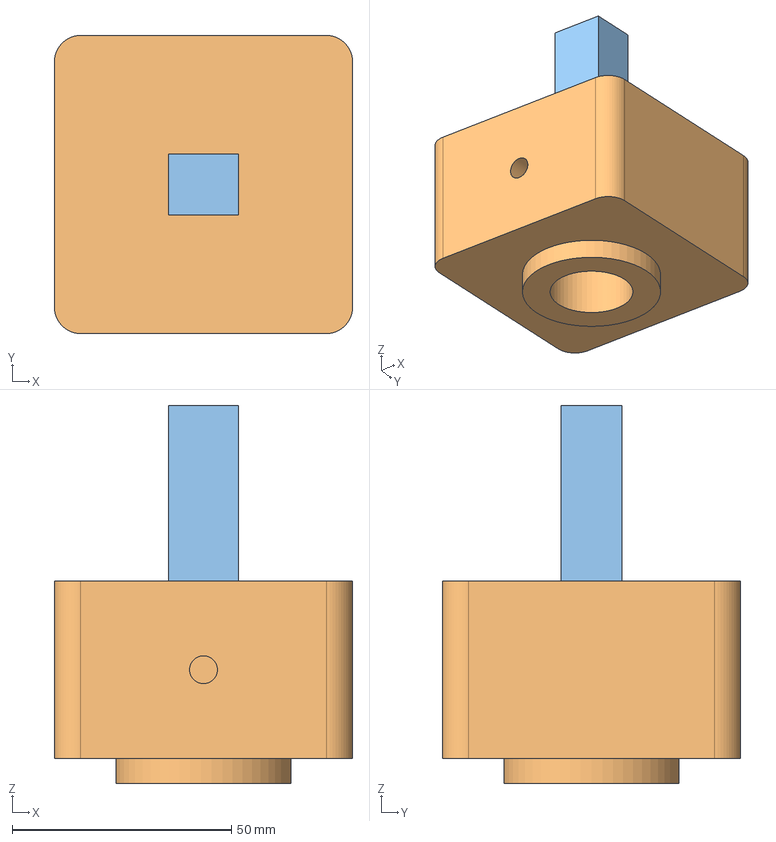
[picture p37: CAD file, 2026-11-01]
cad/optima/models/colour-camera.FCStd
68.0 x 68.0 x 86.2 mm
Sensor
Room for the plugs
