lucaswewa/microscope/cad/optima/outputs/step/OPTIMA-H15-colour-cameras-focus-plate.step

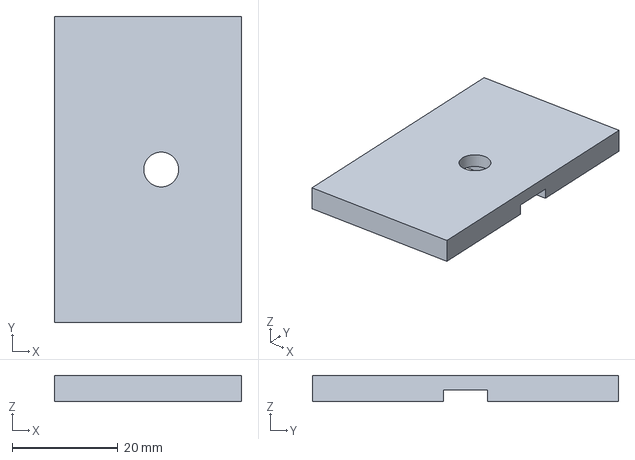
[picture p38: CAD file, 2026-11-01]
cad/optima/outputs/step/OPTIMA-H15-colour-cameras-focus-plate.step
35.5 x 58.0 x 5.00 mm
