lucaswewa/microscope/cad/optima/models/optical-layout.FCStd

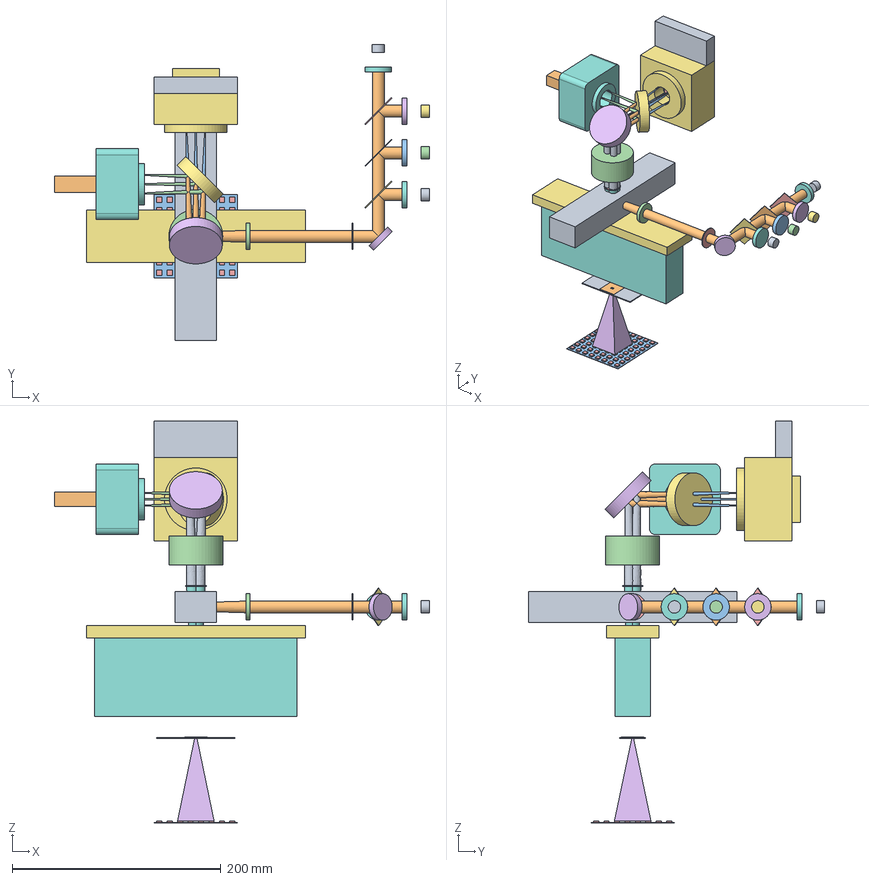
[picture p39: CAD file, 2026-11-01]
cad/optima/models/optical-layout.FCStd
359.5 x 284.0 x 385.3 mm
Slide
CoverGlass
Field of view, 5x: 3.79 x 2.60 mm
Field of view, 10x: 1.89 x 1.30 mm
Field of view, 20x: 0.95 x 0.65 mm
Objective 5x, NA 0.14
Exit pupil 5x (assumed depth)
Objective 10x, NA 0.28
Exit pupil 10x (assumed depth)
Objective 20x, NA 0.42
Exit pupil 20x (assumed depth)
Tube lens: Thorlabs TTL200-A
Tube lens entrance pupil
Fold mirror
Flip mirror (in: light to the colour camera)
Infinity space: centre and corners
Tube lens to fold mirror
Fold mirror to flip mirror
To the mono camera (flip mirror out)
To the colour camera (flip mirror in)
Mono sensor
Colour sensor
Mono camera: ToupTek CTR3CMOS45000KMA
Colour camera: ToupTek E3ISPM45000KPB
Room for the mono camera's plugs
Room for the colour camera's plug
Quad dichroic
Epi lens, f = 100 mm
Field stop, 11.5 mm
Epi fold mirror
Combiner dichroic for 395 nm
Collector, 395 nm LED
LED, 395 nm
Combiner dichroic for 470 nm
Collector, 470 nm LED
LED, 470 nm
Combiner dichroic for 565 nm
Collector, 565 nm LED
LED, 565 nm
Collector, 625 nm LED
LED, 625 nm
Excitation light (schematic)
LED matrix: Adafruit 2734
LEDs inside the 10x's NA
LEDs outside the 10x's NA
Brightfield light, 10x
Objective changer carriage, all positions
Objectives, all positions
Filter slider, all positions
