lucaswewa/microscope/cad/optima/outputs/step/OPTIMA-H01-head-plate.step

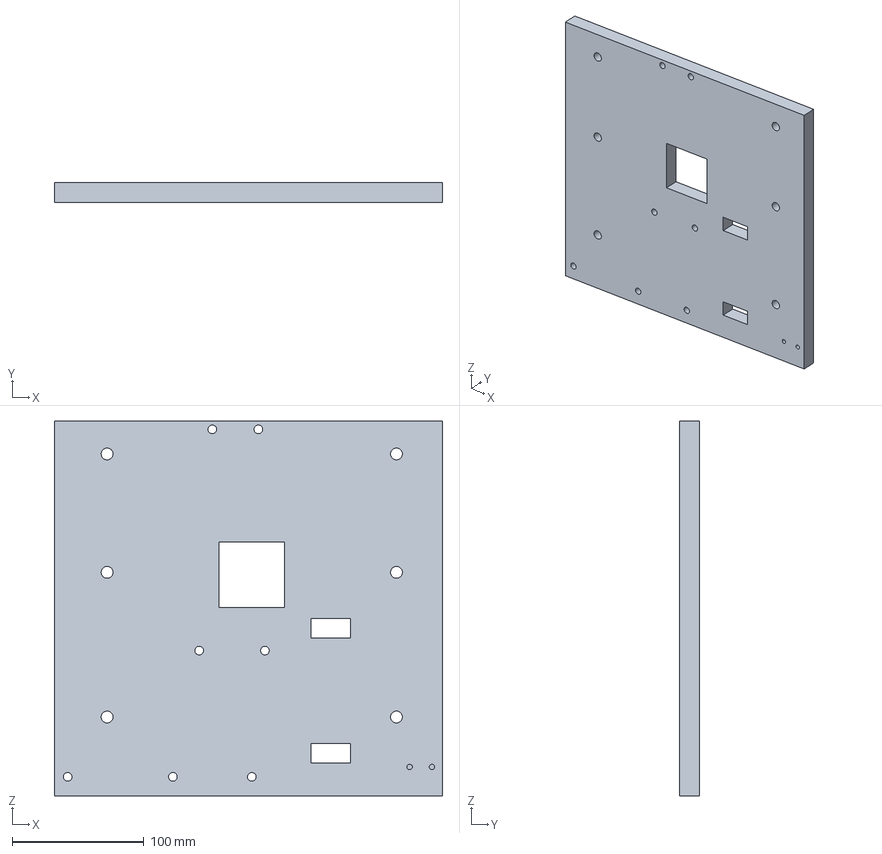
[picture p40: CAD file, 2026-11-01]
cad/optima/outputs/step/OPTIMA-H01-head-plate.step
295.0 x 15.0 x 285.0 mm
