lucaswewa/microscope/cad/optima/models/mono-camera.FCStd

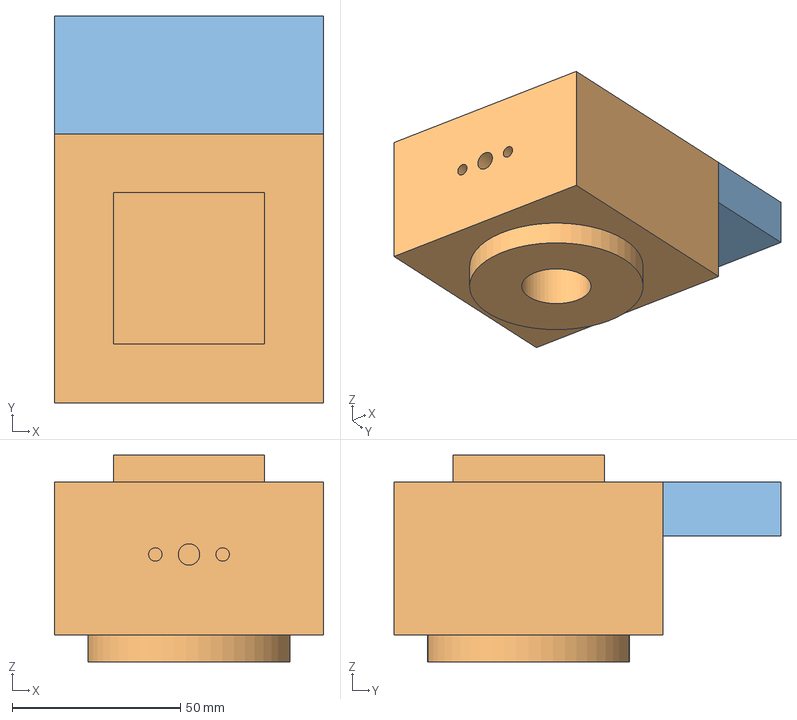
[picture p41: CAD file, 2026-11-01]
cad/optima/models/mono-camera.FCStd
80.0 x 115.0 x 61.4 mm
Sensor
Room for the plugs
