lucaswewa/microscope/cad/optima/outputs/step/OPTIMA-H03-upper-deck.step

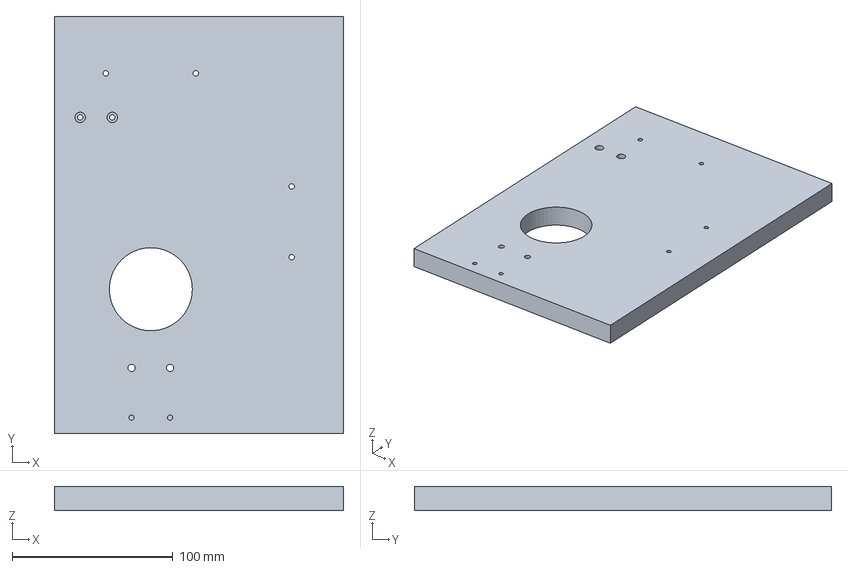
[picture p42: CAD file, 2026-11-01]
cad/optima/outputs/step/OPTIMA-H03-upper-deck.step
180.0 x 260.0 x 15.0 mm
