lucaswewa/microscope/cad/optima/models/z-lift.FCStd

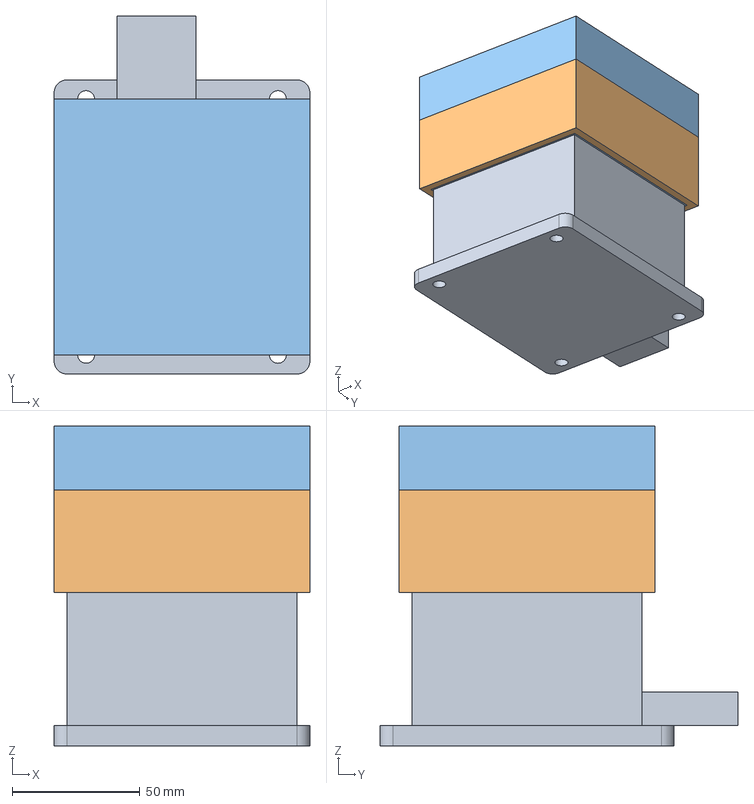
[picture p43: CAD file, 2026-11-01]
cad/optima/models/z-lift.FCStd
100.0 x 140.0 x 125.0 mm
Base, column and connector
Top, at the bottom of the travel
Swept by the top001
