lucaswewa/microscope/cad/optima/outputs/step/OPTIMA-E03-covers-back-panel.step

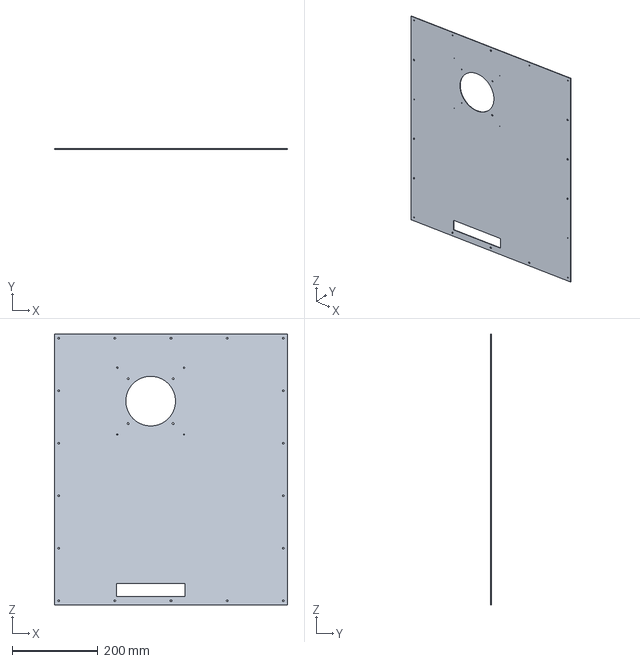
[picture p44: CAD file, 2026-11-01]
cad/optima/outputs/step/OPTIMA-E03-covers-back-panel.step
545.0 x 1.50 x 633.1 mm
