lucaswewa/microscope/cad/optima/models/overview-camera.FCStd

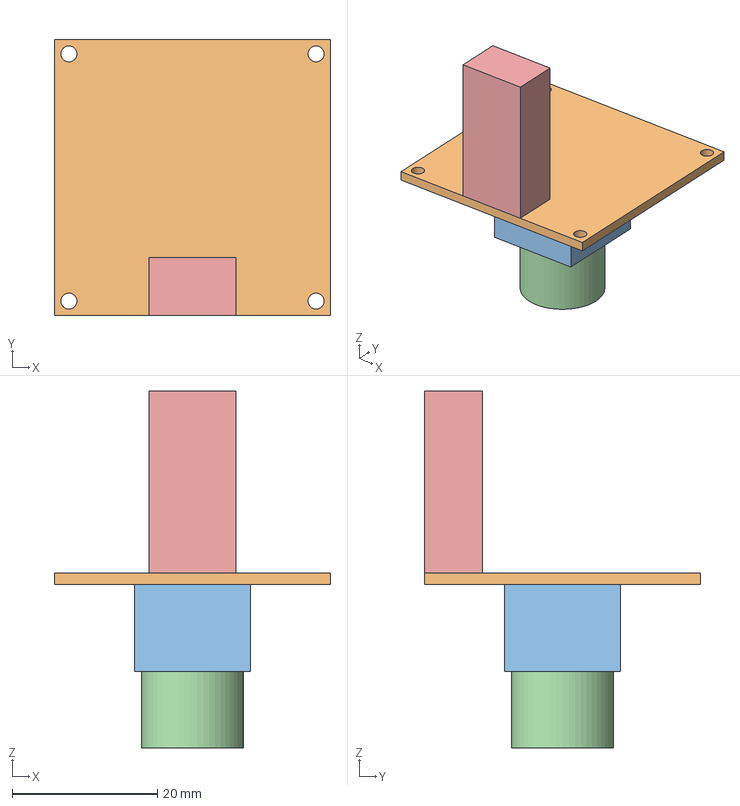
[picture p45: CAD file, 2026-11-01]
cad/optima/models/overview-camera.FCStd
38.0 x 38.0 x 49.1 mm
Sensor
Board
Holder
Lens
Room for the plugs
