lucaswewa/microscope/cad/optima/outputs/step/OPTIMA-H12-mono-cameras-mount.step

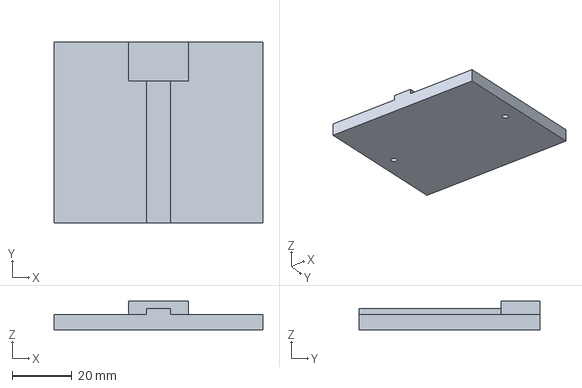
[picture p46: CAD file, 2026-11-01]
cad/optima/outputs/step/OPTIMA-H12-mono-cameras-mount.step
70.0 x 60.5 x 9.70 mm
