lucaswewa/microscope/cad/optima/outputs/step/OPTIMA-I02-four-slide-insert.step

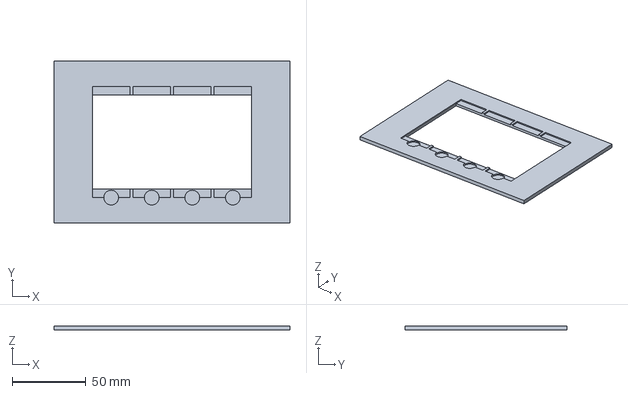
[picture p47: CAD file, 2026-11-01]
cad/optima/outputs/step/OPTIMA-I02-four-slide-insert.step
160.0 x 110.0 x 3.00 mm
