lucaswewa/microscope/cad/optima/outputs/step/OPTIMA-S02-plate-on-the-lift.step

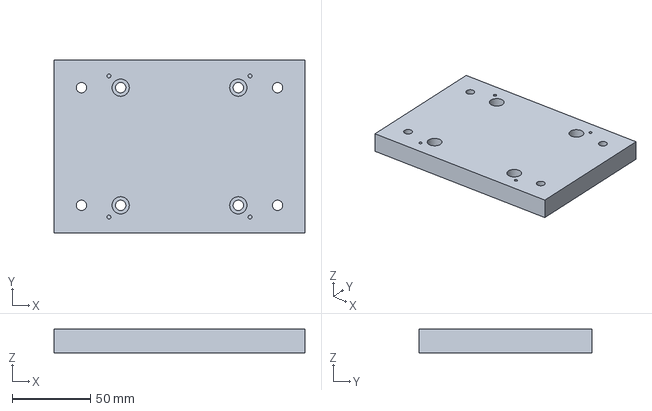
[picture p48: CAD file, 2026-11-01]
cad/optima/outputs/step/OPTIMA-S02-plate-on-the-lift.step
160.0 x 110.0 x 15.0 mm
