lucaswewa/microscope/cad/optima/outputs/step/OPTIMA-H07-changers-motor-bracket.step

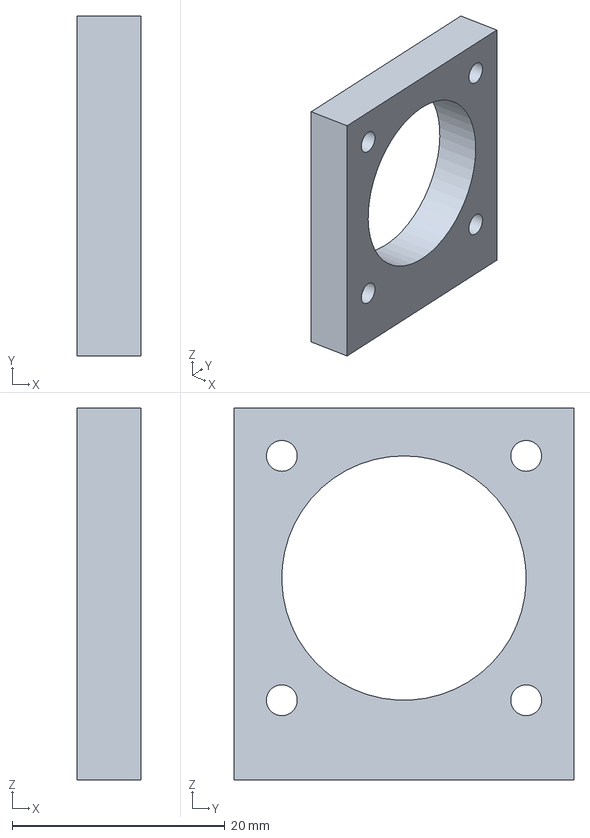
[picture p49: CAD file, 2026-11-01]
cad/optima/outputs/step/OPTIMA-H07-changers-motor-bracket.step
6.00 x 32.0 x 35.0 mm
