lucaswewa/microscope/cad/optima/outputs/step/OPTIMA-E04-covers-top-panel.step

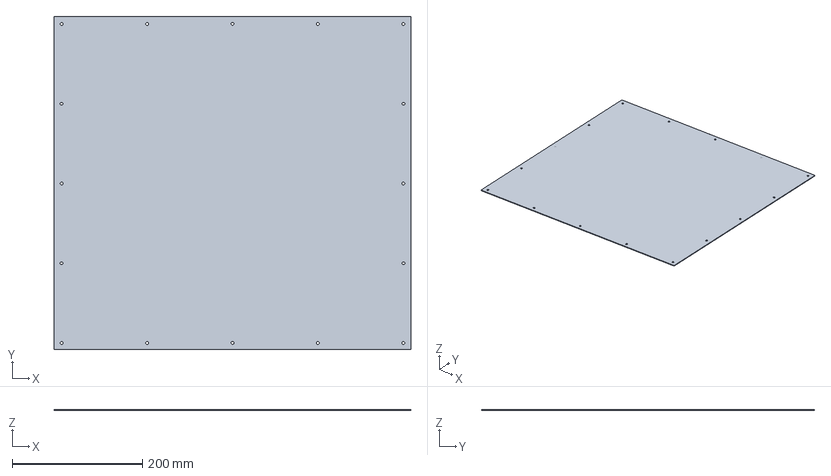
[picture p50: CAD file, 2026-11-01]
cad/optima/outputs/step/OPTIMA-E04-covers-top-panel.step
548.0 x 511.5 x 1.50 mm
