lucaswewa/microscope/cad/optima/outputs/step/OPTIMA-E07-fans-baffle.step

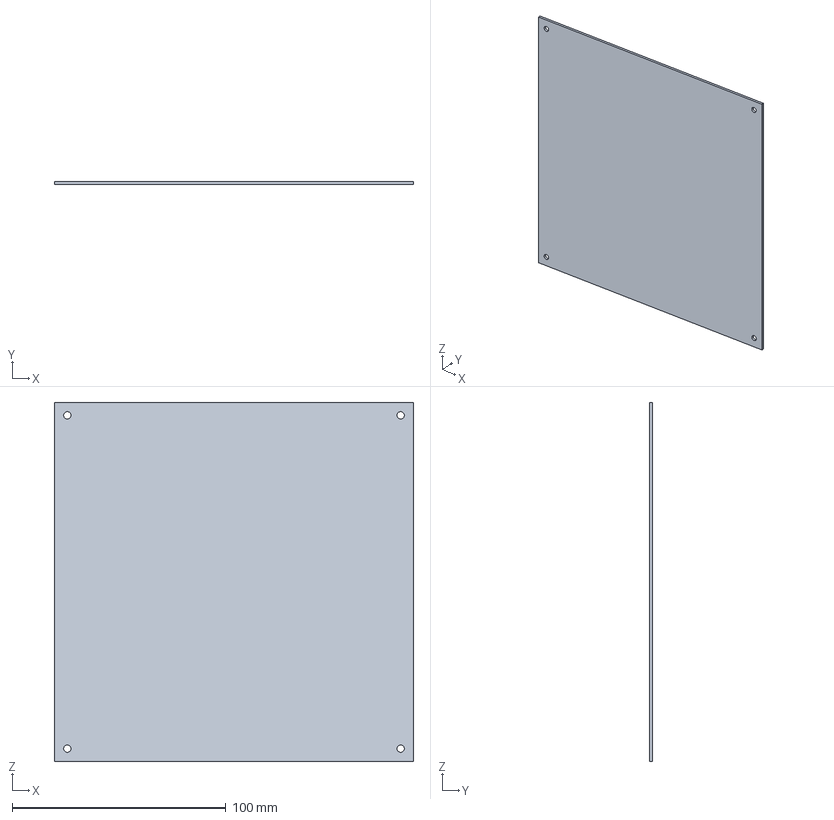
[picture p51: CAD file, 2026-11-01]
cad/optima/outputs/step/OPTIMA-E07-fans-baffle.step
168.0 x 1.50 x 168.0 mm
