lucaswewa/microscope/cad/optima/outputs/step/OPTIMA-H13-mono-cameras-focus-plate.step

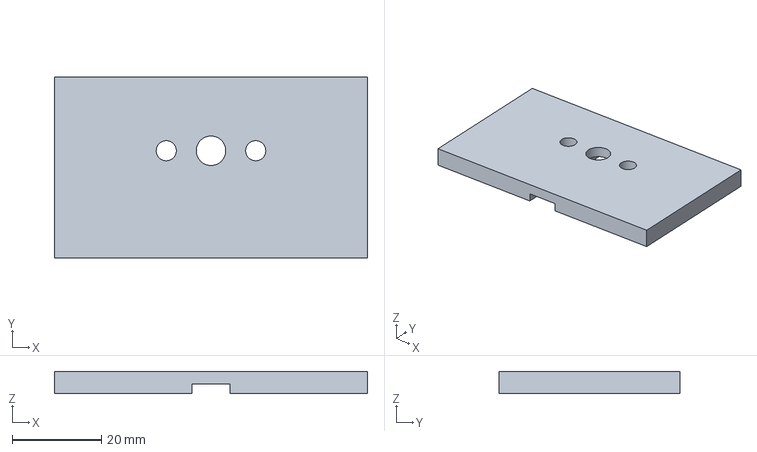
[picture p52: CAD file, 2026-11-01]
cad/optima/outputs/step/OPTIMA-H13-mono-cameras-focus-plate.step
70.0 x 40.5 x 5.00 mm
