lucaswewa/microscope/cad/optima/outputs/step/OPTIMA-I03-microplate-insert.step

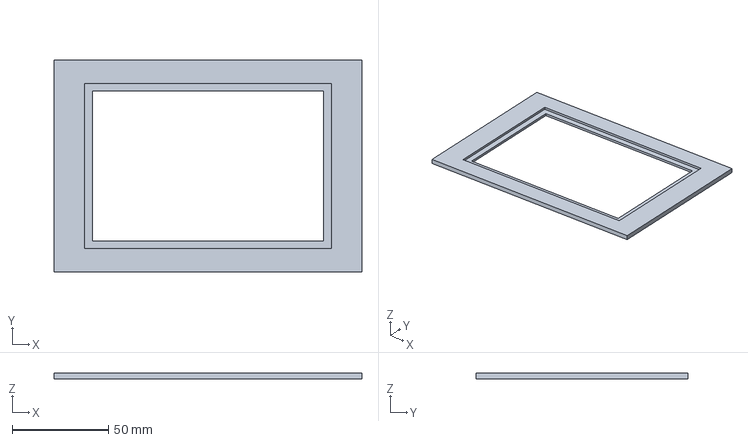
[picture p53: CAD file, 2026-11-01]
cad/optima/outputs/step/OPTIMA-I03-microplate-insert.step
160.0 x 110.0 x 3.00 mm
