lucaswewa/microscope/cad/optima/outputs/step/OPTIMA-I01-insert-adapter.step

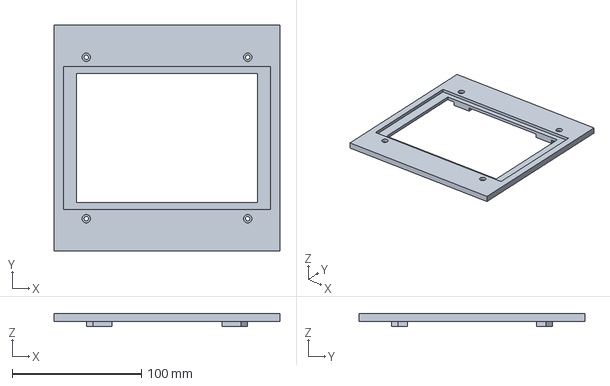
[picture p54: CAD file, 2026-11-01]
cad/optima/outputs/step/OPTIMA-I01-insert-adapter.step
175.0 x 175.0 x 9.80 mm
