lucaswewa/microscope/cad/optima/outputs/step/OPTIMA-H06-changer-plate.step

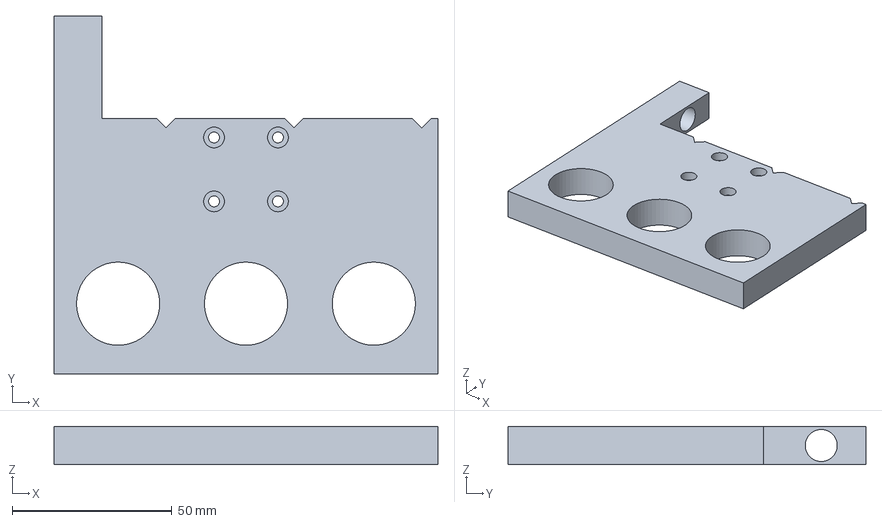
[picture p56: CAD file, 2026-11-01]
cad/optima/outputs/step/OPTIMA-H06-changer-plate.step
120.0 x 112.0 x 12.0 mm
