lucaswewa/microscope/cad/optima/outputs/step/OPTIMA-E02-covers-right-panel.step

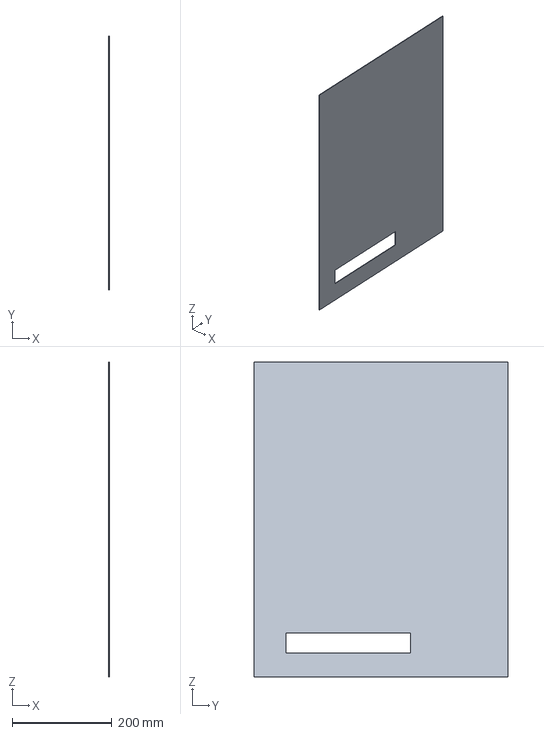
[picture p57: CAD file, 2026-11-01]
cad/optima/outputs/step/OPTIMA-E02-covers-right-panel.step
1.50 x 511.5 x 633.1 mm
