lucaswewa/microscope/cad/optima/outputs/step/OPTIMA-H05-epi-plate.step

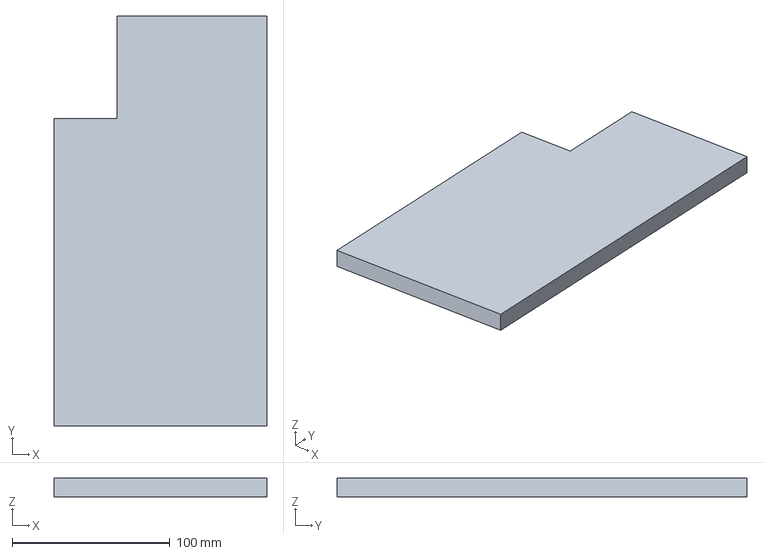
[picture p58: CAD file, 2026-11-01]
cad/optima/outputs/step/OPTIMA-H05-epi-plate.step
135.0 x 260.0 x 12.0 mm
