lucaswewa/microscope/cad/optima/outputs/step/OPTIMA-H10-sliders-motor-bracket.step

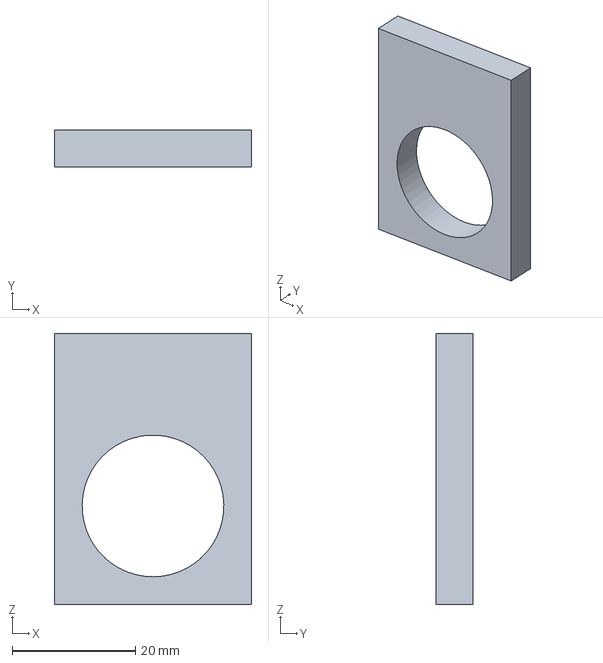
[picture p59: CAD file, 2026-11-01]
cad/optima/outputs/step/OPTIMA-H10-sliders-motor-bracket.step
32.0 x 6.00 x 44.0 mm
