lucaswewa/microscope/cad/optima/outputs/step/OPTIMA-E01-covers-left-panel.step

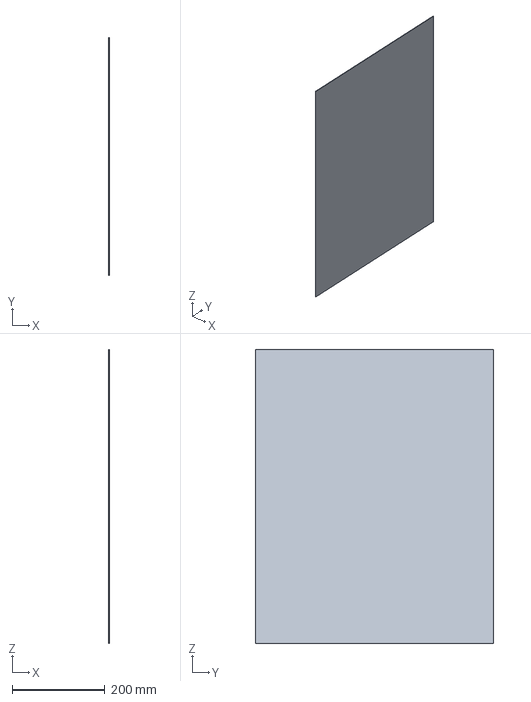
[picture p60: CAD file, 2026-11-01]
cad/optima/outputs/step/OPTIMA-E01-covers-left-panel.step
1.50 x 511.5 x 633.1 mm
