lucaswewa/microscope/cad/optima/outputs/step/OPTIMA-H14-colour-cameras-mount.step

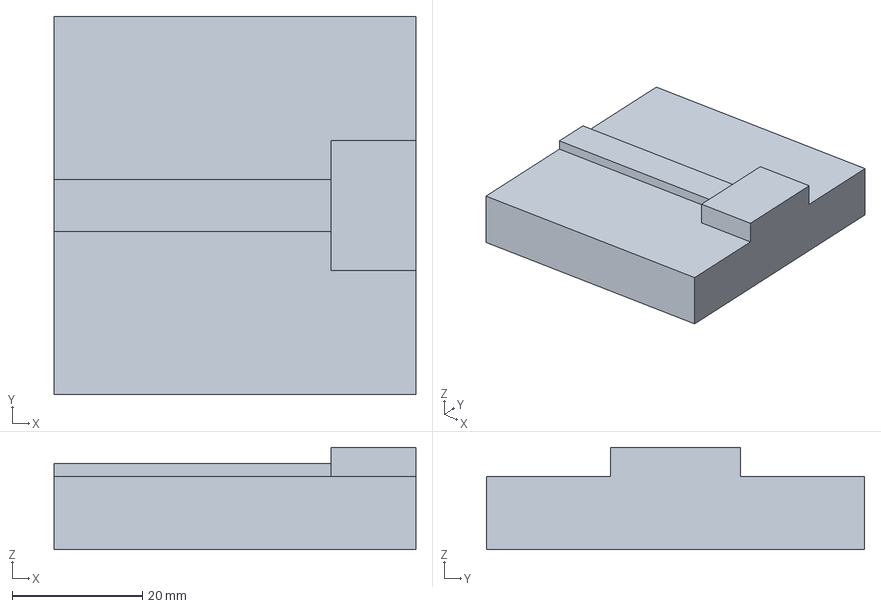
[picture p61: CAD file, 2026-11-01]
cad/optima/outputs/step/OPTIMA-H14-colour-cameras-mount.step
55.5 x 58.0 x 15.7 mm
