lucaswewa/microscope/cad/optima/outputs/step/OPTIMA-H04-camera-ports-bracket.step

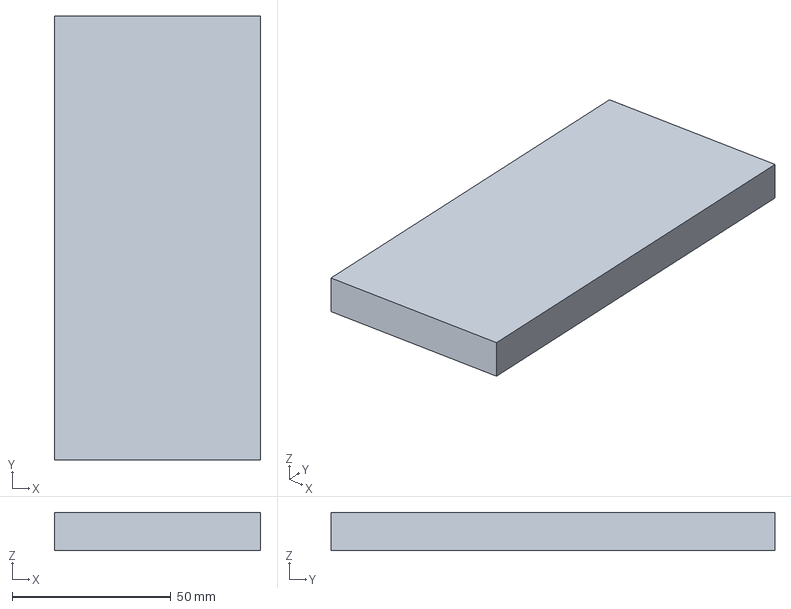
[picture p62: CAD file, 2026-11-01]
cad/optima/outputs/step/OPTIMA-H04-camera-ports-bracket.step
65.0 x 140.0 x 12.0 mm
