lucaswewa/microscope/(list of files, cad)

Other CAD files:
cad/optima/outputs/step/OPTIMA-E08-electronics-tray.step
