lucaswewa/microscope/web/tests/fixtures/dzi/sample_files/10/0_1.jpeg

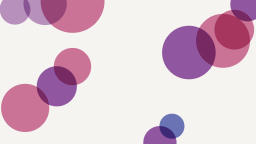
web/tests/fixtures/dzi/sample_files/10/0_1.jpeg
