lucaswewa/microscope/web/tests/visual/shell.spec.ts-snapshots/calibration-wizard-light-chromium-win32.png

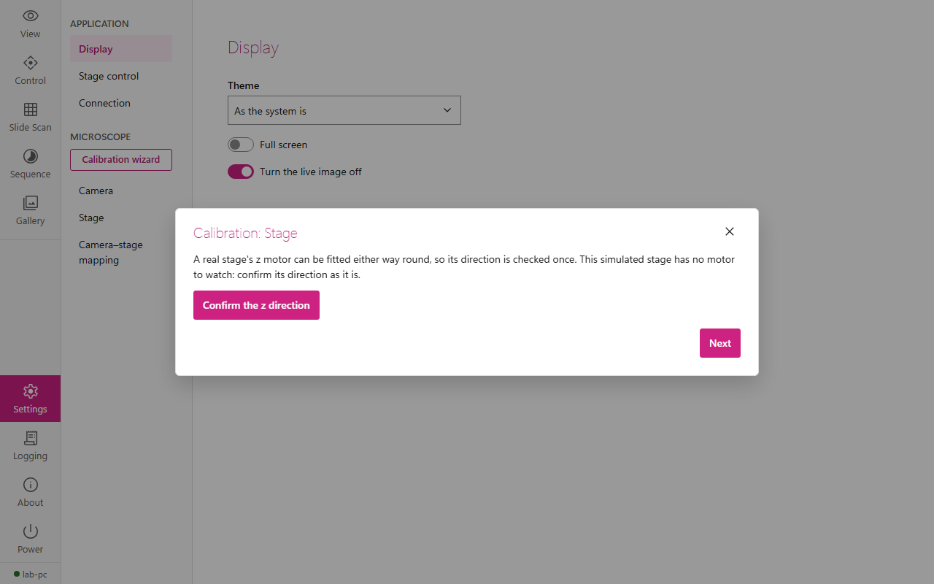
web/tests/visual/shell.spec.ts-snapshots/calibration-wizard-light-chromium-win32.png
