lucaswewa/microscope/cad/optima/outputs/drawings/OPTIMA-E08-electronics-tray.pdf

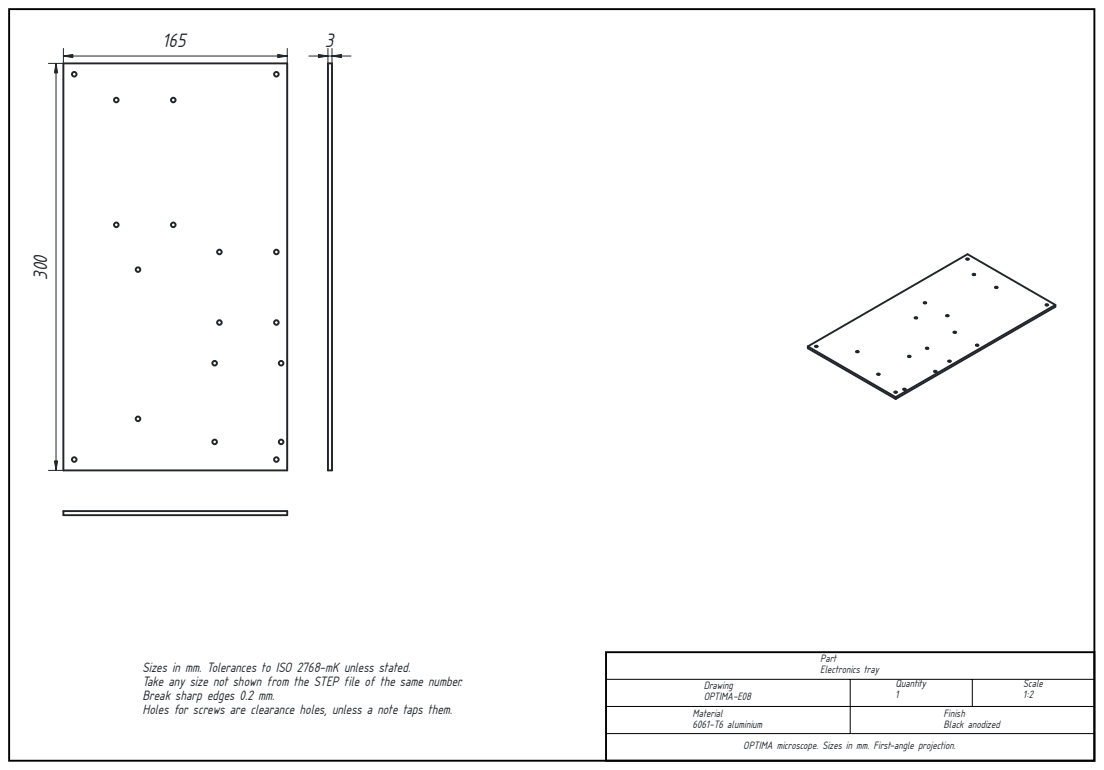
[picture p66: page 1]
Electronics tray

Sizes in mm. Tolerances to ISO 2768-mK unless stated. Take any size not shown from the STEP file of the same number. Break sharp edges 0.2 mm. Holes for screws are clearance holes, unless a note taps them.

Drawing OPTIMA-E08 | Quantity 1 | Scale 1:2

Material 6061-T6 aluminium | Finish Black anodized

OPTIMA microscope. Sizes in mm. First-angle projection.
