lucaswewa/microscope/cad/optima/outputs/drawings/OPTIMA-E01-covers-left-panel.pdf

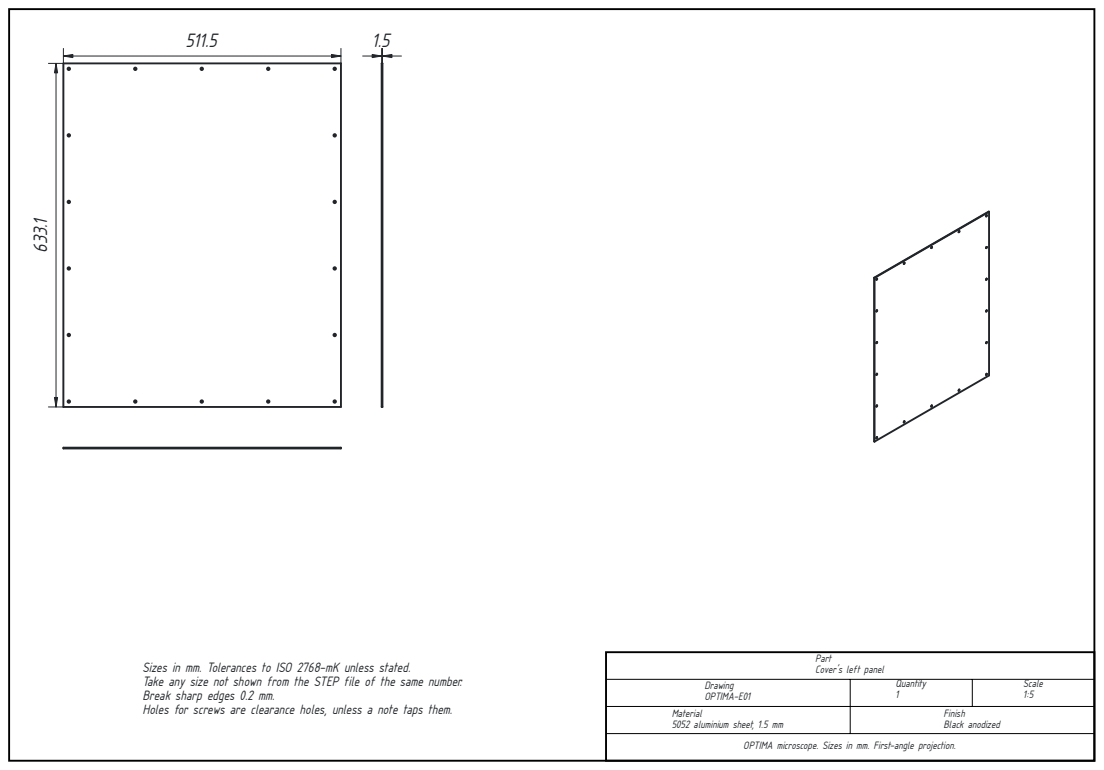
[picture p67: page 1]

Part
Cover's left panel

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

Drawing OPTIMA-E01 | Quantity 1 | Scale 1:5

Material 5052 aluminium sheet, 1.5 mm | Finish Black anodized

OPTIMA microscope. Sizes in mm. First-angle projection.
