lucaswewa/microscope/cad/optima/outputs/drawings/OPTIMA-E03-covers-back-panel.pdf

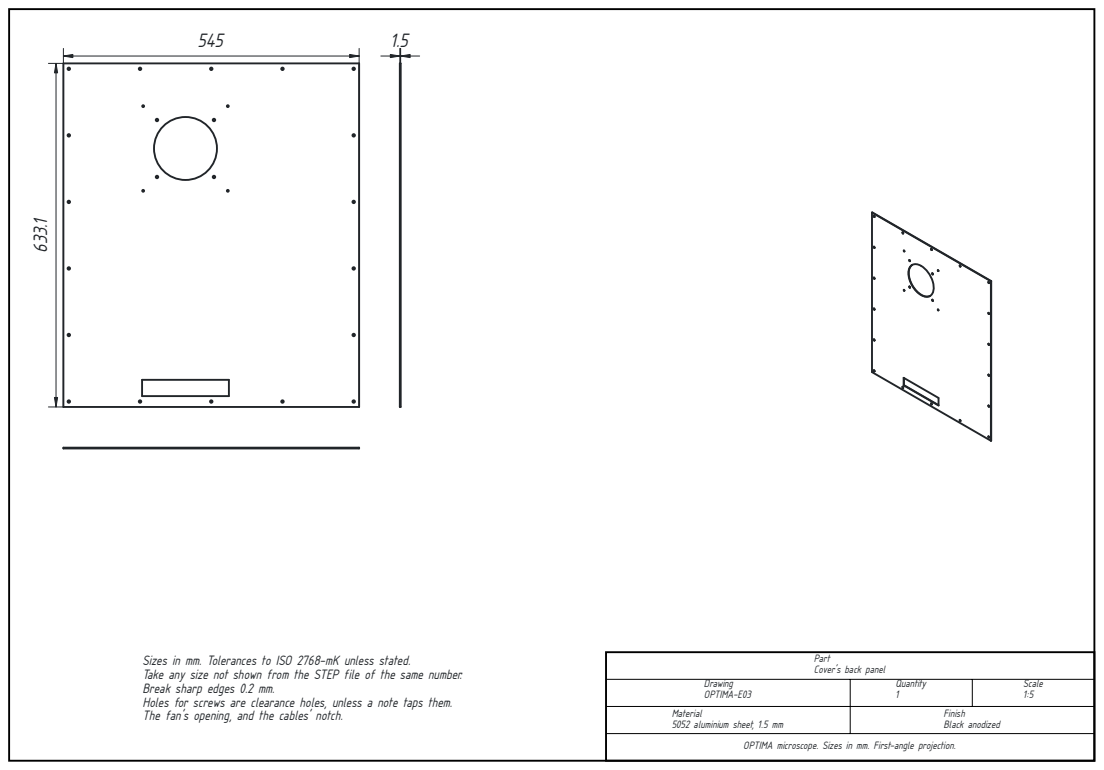
[picture p68: page 1]

Sizes in mm. Tolerances to ISO 2768-mK unless stated. Take any size not shown from the STEP file of the same number. Break sharp edges 0.2 mm. Holes for screws are clearance holes, unless a note taps them. The fan's opening, and the cables' notch.

Part
Cover's back panel

Drawing OPTIMA-E03 | Quantity 1 | Scale 1:5

Material 5052 aluminium sheet, 1.5 mm | Finish Black anodized

OPTIMA microscope. Sizes in mm. First-angle projection.
