lucaswewa/microscope/cad/optima/outputs/drawings/OPTIMA-H04-camera-ports-bracket.pdf

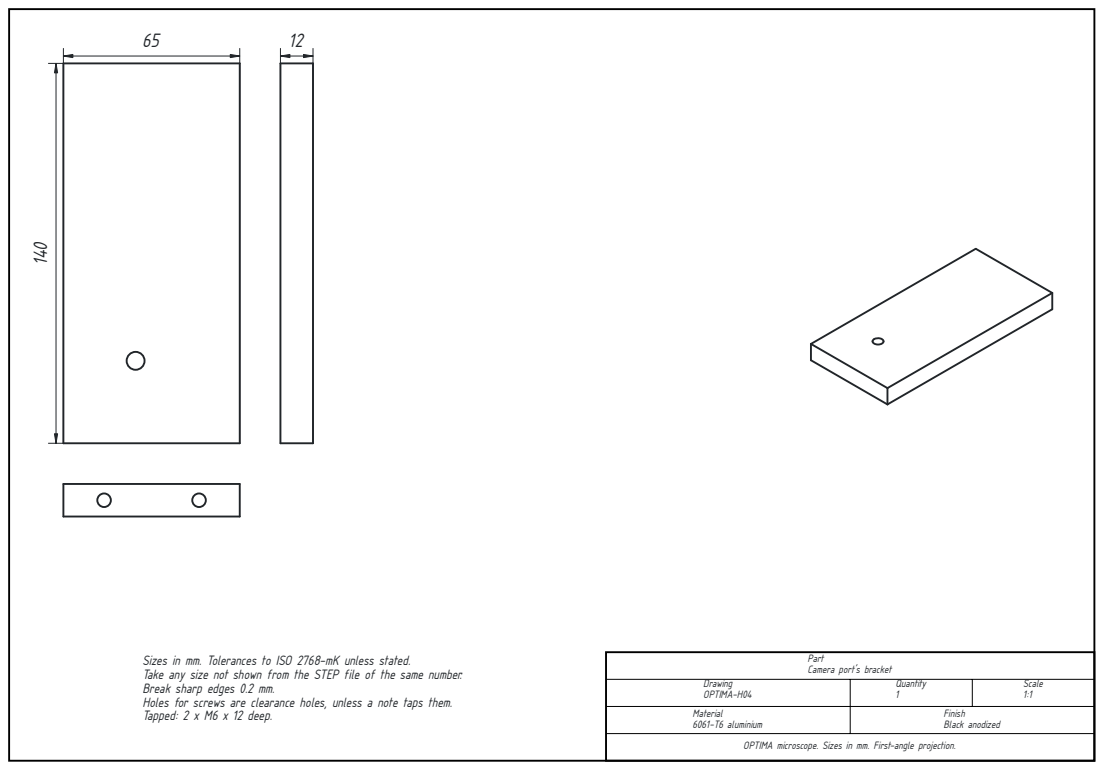
[picture p69: page 1]

Sizes in mm. Tolerances to ISO 2768-mK unless stated. Take any size not shown from the STEP file of the same number. Break sharp edges 0.2 mm. Holes for screws are clearance holes, unless a note taps them. Tapped: 2 x M6 x 12 deep.

Part
Camera port's bracket

Drawing OPTIMA-H04 | Quantity 1 | Scale 1:1

Material 6061-T6 aluminium | Finish Black anodized

OPTIMA microscope. Sizes in mm. First-angle projection.
