lucaswewa/microscope/cad/optima/outputs/drawings/OPTIMA-H08-detent-block.pdf

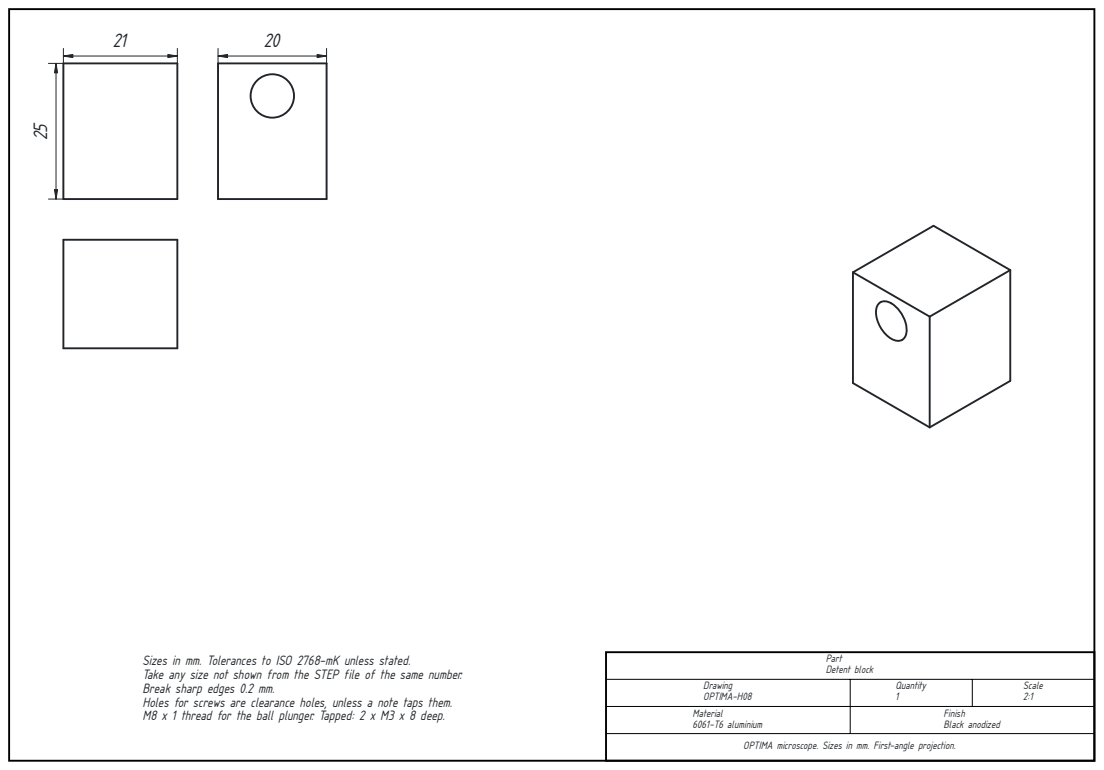
[picture p70: page 1]
Detent block

Sizes in mm. Tolerances to ISO 2768-mK unless stated. Take any size not shown from the STEP file of the same number. Break sharp edges 0.2 mm. Holes for screws are clearance holes, unless a note taps them. M8 x 1 thread for the ball plunger. Tapped: 2 x M3 x 8 deep.

Drawing OPTIMA-H08 | Quantity 1 | Scale 2:1

Material 6061-T6 aluminium | Finish Black anodized

OPTIMA microscope. Sizes in mm. First-angle projection.
