lucaswewa/microscope/cad/optima/outputs/drawings/OPTIMA-H01-head-plate.pdf

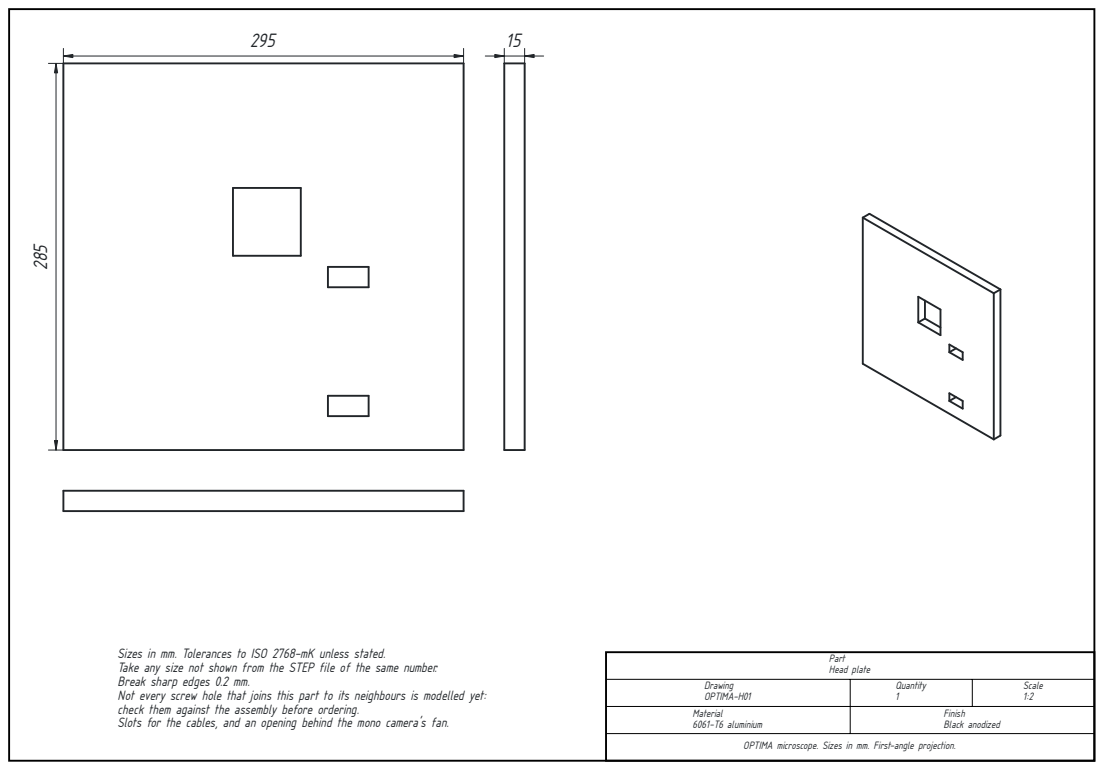
[picture p71: page 1]
Head plate

Sizes in mm. Tolerances to ISO 2768-mK unless stated. Take any size not shown from the STEP file of the same number. Break sharp edges 0.2 mm. Not every screw hole that joins this part to its neighbours is modelled yet:

Drawing OPTIMA-H01 | Quantity 1 | Scale 1:2

check them against the assembly before ordering. Slots for the cables, and an opening behind the mono camera's fan.

Material 6061-T6 aluminium | Finish Black anodized

OPTIMA microscope. Sizes in mm. First-angle projection.
