lucaswewa/microscope/cad/optima/outputs/drawings/OPTIMA-H03-upper-deck.pdf

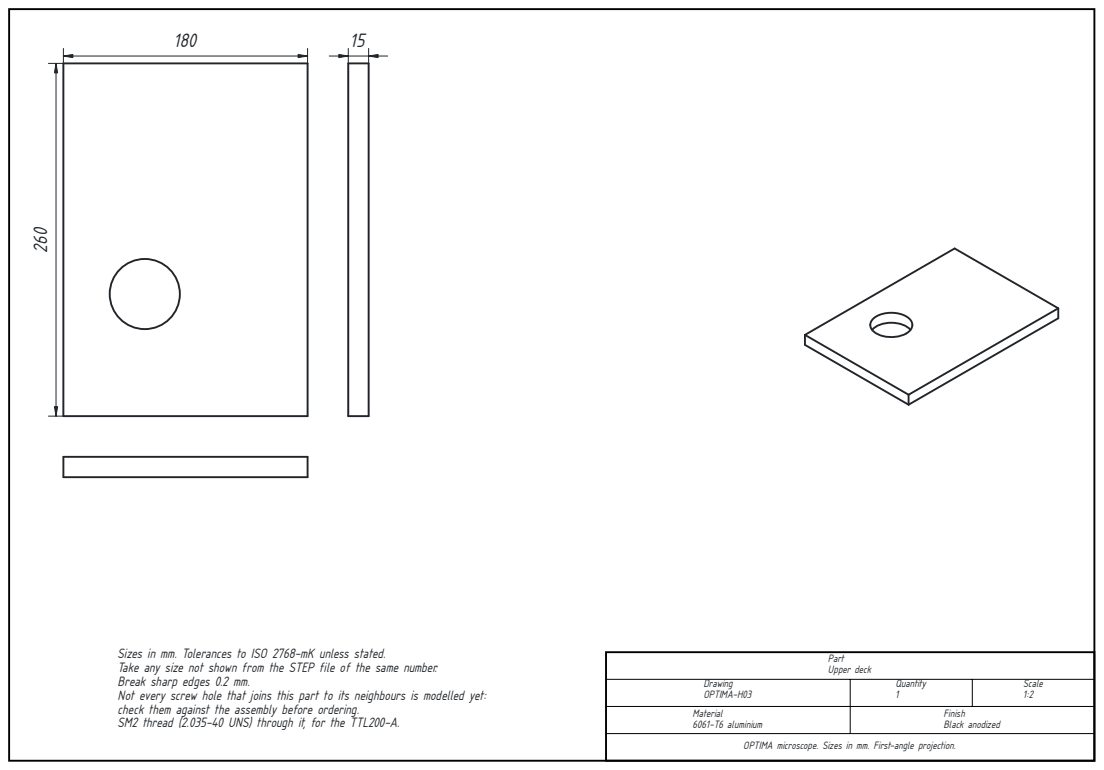
[picture p72: page 1]
Upper deck

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

Drawing OPTIMA-H03 | Quantity 1 | Scale 1:2

check them against the assembly before ordering. SM2 thread (2.035-40 UNS) through it, for the TTL200-A.

Material 6061-T6 aluminium | Finish Black anodized

OPTIMA microscope. Sizes in mm. First-angle projection.
