lucaswewa/microscope/cad/optima/outputs/drawings/OPTIMA-H12-mono-cameras-mount.pdf

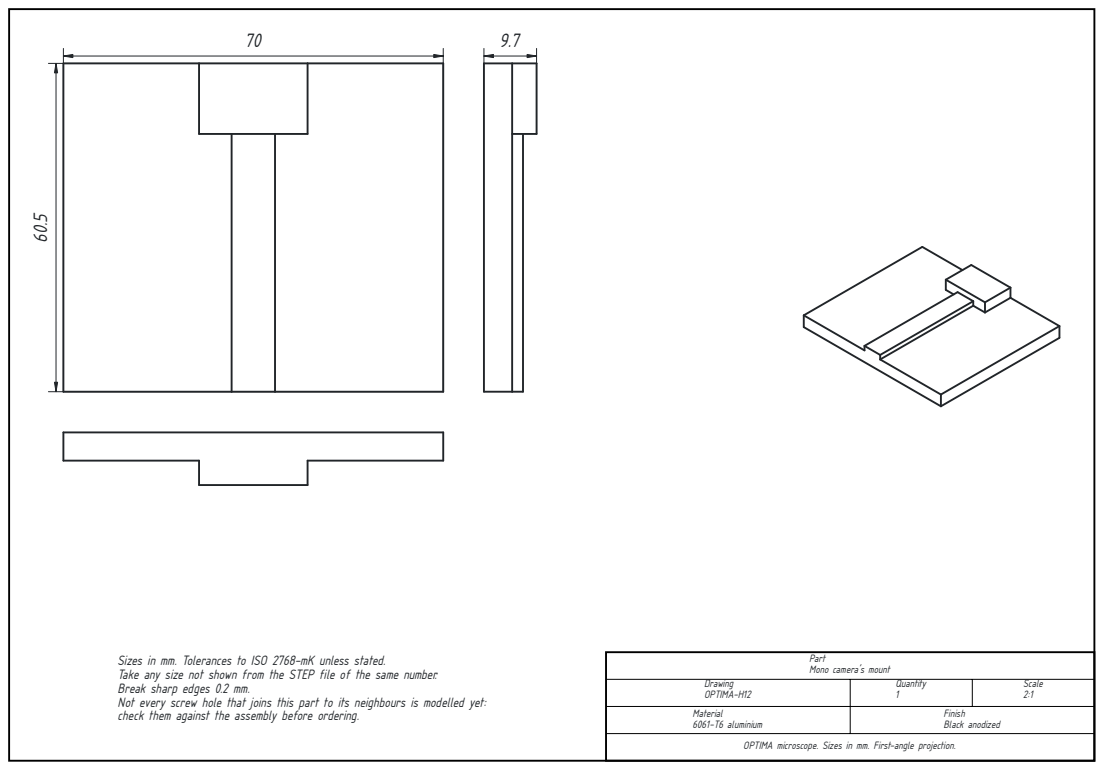
[picture p73: page 1]
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

Part
Mono camera's mount

Drawing OPTIMA-H12 | Quantity 1 | Scale 2:1

check them against the assembly before ordering.

Material 6061-T6 aluminium | Finish Black anodized

OPTIMA microscope. Sizes in mm. First-angle projection.
