lucaswewa/microscope/electronics/carrier/kicad/fab/carrier-bottom.pdf

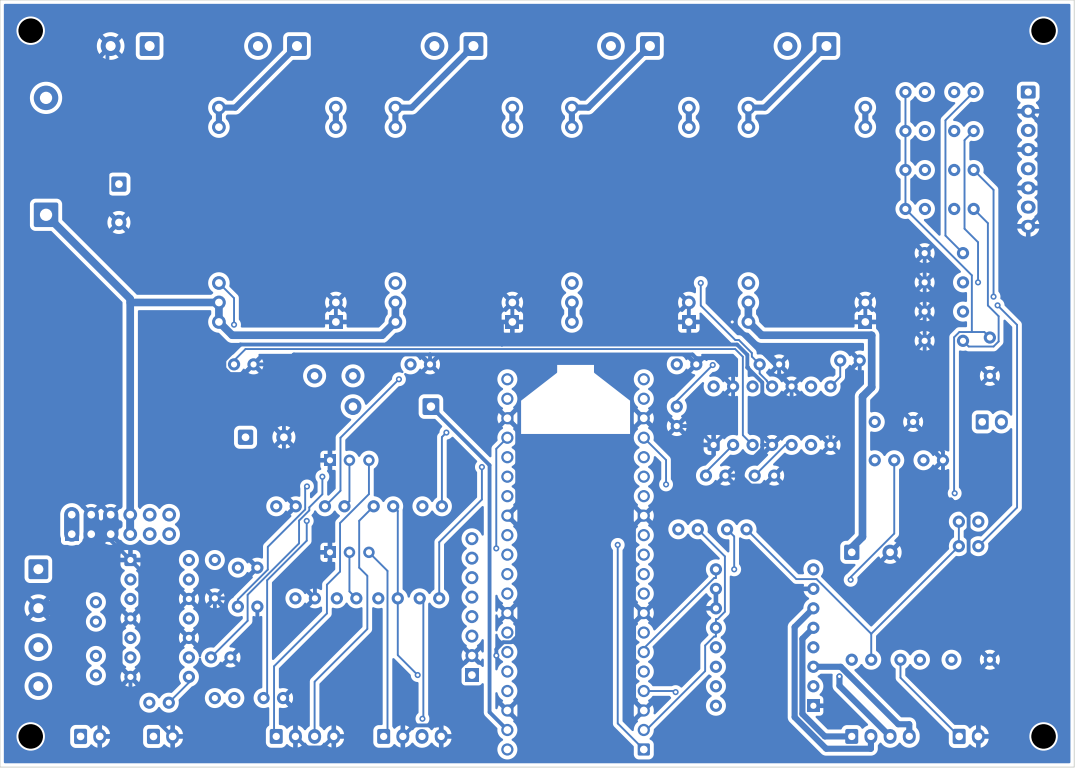
[picture p74: page 1]
