lucaswewa/microscope/electronics/carrier/kicad/fab/carrier-top.pdf

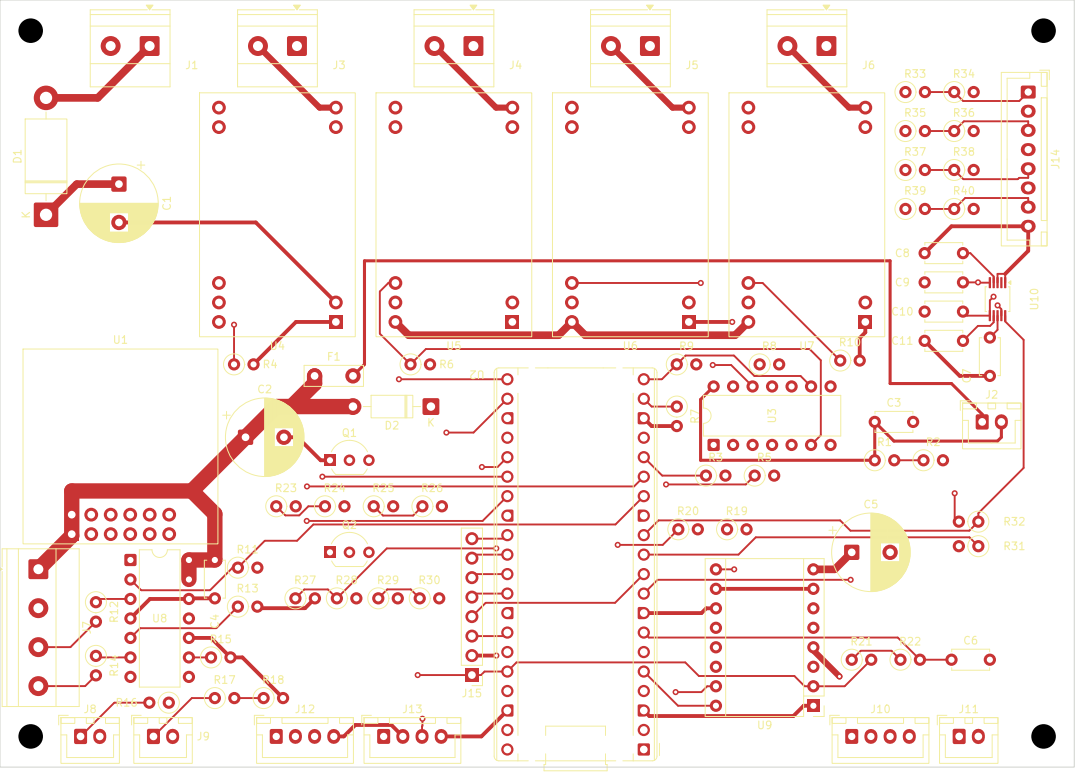
[picture p75: page 1]
