lucaswewa/microscope/electronics/carrier/kicad/carrier.kicad_pcb

## KiCad design electronics/carrier/kicad/carrier.kicad_pcb (2026-11-02)

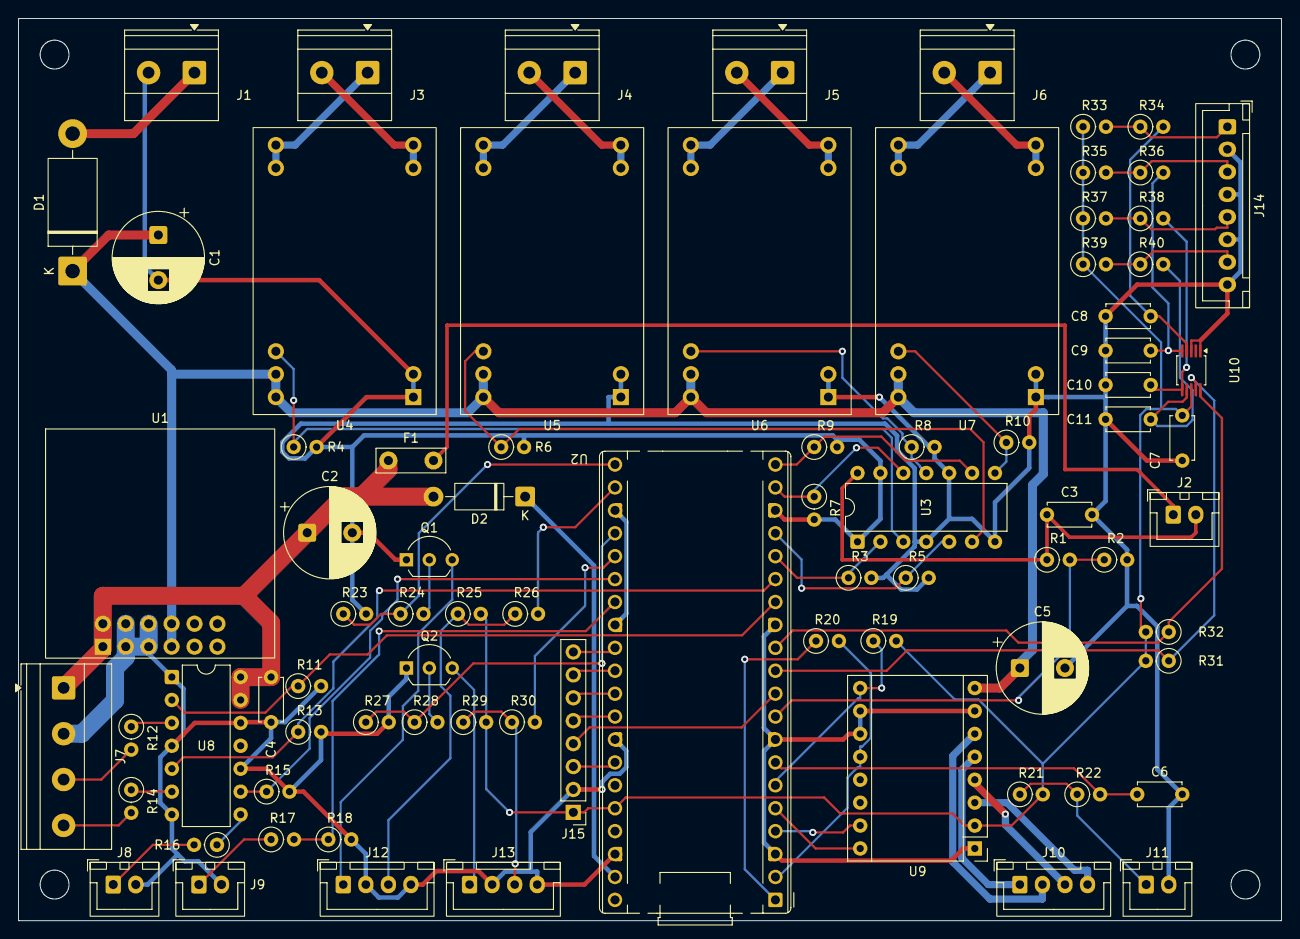
[picture p76: board carrier.kicad_pcb from above]

Board: 2 copper layers, 140.0 x 100.0 mm, 85 parts (0 on the bottom side), 73 nets.

Parts:
C1, C5: 100uF 35 V; CP_Radial_D10.0mm_P5.00mm
C2: 470uF 16 V; CP_Radial_D10.0mm_P5.00mm
C3, C4, C6, C7, C8, C9, C10, C11: 100nF; C_Disc_D4.7mm_W2.5mm_P5.00mm
D1: 1N5822; D_DO-201AD_P15.24mm_Horizontal
D2: 1N5817; D_DO-41_SOD81_P10.16mm_Horizontal
F1: PTC, 0.1 A hold; C_Disc_D7.5mm_W2.5mm_P5.00mm
H1, H2, H3, H4: MountingHole_3.2mm_M3
J1: W08: 24 V in, fuse F2; TerminalBlock_Phoenix_MKDS-1,5-2-5.08_1x02_P5.08mm_Horizont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
J2: W35: door switch; JST_XH_B2B-XH-A_1x02_P2.50mm_Vertical
J3: W23: 395 nm; TerminalBlock_Phoenix_MKDS-1,5-2-5.08_1x02_P5.08mm_Horizont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
J4: W24: 470 nm; TerminalBlock_Phoenix_MKDS-1,5-2-5.08_1x02_P5.08mm_Horizont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
J5: W25: 565 nm; TerminalBlock_Phoenix_MKDS-1,5-2-5.08_1x02_P5.08mm_Horizont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
J6: W26: 625 nm; TerminalBlock_Phoenix_MKDS-1,5-2-5.08_1x02_P5.08mm_Horizont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
J7: W30: LED matrix; TerminalBlock_Phoenix_MKDS-1,5-4-5.08_1x04_P5.08mm_Horizont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
J8: W33: port, DIG I/O 1; JST_XH_B2B-XH-A_1x02_P2.50mm_Vertical
J9: W34: port, DIG I/O 2; JST_XH_B2B-XH-A_1x02_P2.50mm_Vertical
J10: W28: slider's motor; JST_XH_B4B-XH-A_1x04_P2.50mm_Vertical
J11: W29: slider's home switch; JST_XH_B2B-XH-A_1x02_P2.50mm_Vertical
J12: W31: mono camera; JST_XH_B4B-XH-A_1x04_P2.50mm_Vertical
J13: W32: colour camera; JST_XH_B4B-XH-A_1x04_P2.50mm_Vertical
J14: W27: thermistors; JST_XH_B8B-XH-A_1x08_P2.50mm_Vertical
J15: Spare pins; PinHeader_1x08_P2.54mm_Vertical
Q1, Q2: 2N3904; TO-92_Inline_Wide
R1, R17: 3.9k; R_Axial_DIN0207_L6.3mm_D2.5mm_P2.54mm_Vertical
R2, R18: 6.8k; R_Axial_DIN0207_L6.3mm_D2.5mm_P2.54mm_Vertical
R3, R5, R7, R9, R11, R13, R15, R23, R25, R27, R29, R31, R32: 4.7k; R_Axial_DIN0207_L6.3mm_D2.5mm_P2.54mm_Vertical
R4, R6, R8, R10, R20, R22, R26, R30, R34, R36, R38, R40: 1k; R_Axial_DIN0207_L6.3mm_D2.5mm_P2.54mm_Vertical
R12, R14, R16: 47; R_Axial_DIN0207_L6.3mm_D2.5mm_P2.54mm_Vertical
R19, R21: 10k; R_Axial_DIN0207_L6.3mm_D2.5mm_P2.54mm_Vertical
R24, R28: 2.2k; R_Axial_DIN0207_L6.3mm_D2.5mm_P2.54mm_Vertical
R33, R35, R37, R39: 10k 1%; R_Axial_DIN0207_L6.3mm_D2.5mm_P2.54mm_Vertical
U1: D36V50F5, 5 V; D36V50F5
U2: Raspberry Pi Pico 2; RaspberryPi_Pico_Common_THT
U3, U8: 74AHCT125; DIP-14_W7.62mm
U4, U5, U6, U7: LDD-1000H; LDD-H
U9: BTT TMC2209 V1.3; Pololu_Breakout-16_15.2x20.3mm
U10: ADS1115; TSSOP-10_3x3mm_P0.5mm

Connections:
/+3V3: C7.1, J15.1, R19.2, R21.2, R25.2, R29.2, R31.2, R32.2, R33.1, R35.1, R37.1, R39.1, U2.36, U9.2, U10.8
/+5V: C2.1, C4.1, D2.2, F1.1, J7.1, U1.6, U1.7, U8.13, U8.14
/+24V: C1.1, C5.1, D1.1, U1.1, U1.2, U4.23, U4.24, U5.23, U5.24, U6.23, U6.24, U7.23, U7.24, U9.8
/AIN1: C8.1, R34.2, U10.4
/AIN2: C9.1, R36.2, U10.5
/AIN3: C10.1, R38.2, U10.6
/AIN4: C11.1, R40.2, U10.7
/DIM1: R4.1, U3.3, U4.22
/DIM2: R6.1, U3.6, U5.22
/DIM3: R8.1, U3.11, U6.22
/DIM4: R10.1, U3.8, U7.22
/DOOR_5V: C3.1, J2.2, R1.1, U3.14
/DOOR_FEED: F1.2, J2.1
/DOOR_SENSE: R1.2, R2.1, U2.9
/EXPO1: R26.2, U2.22
/EXPO1_IN: J12.3, R25.1, R26.1
/EXPO2: R30.2, U2.25
/EXPO2_IN: J13.3, R29.1, R30.1
/GND: C1.2, C2.2, C3.2, C4.2, C5.2, C6.2, C7.2, C8.2, C9.2, C10.2, C11.2, J1.2, J7.2, J8.2, J9.2, J11.2, J12.2, J12.4, J13.2, J13.4, J14.2, J14.4, J14.6, J14.8, J15.2, Q1.1, Q2.1, R2.2, R3.2, R4.2, R5.2, R6.2, R7.2, R8.2, R9.2, R10.2, R11.2, R13.2, R15.2, R18.2, R23.2, R27.2, U1.4, U1.5, U2.3, U2.8, U2.13, U2.18, U2.23, U2.28, U2.33, U2.38, U3.1, U3.4, U3.7, U3.10, U3.13, U4.1, U4.2, U5.1, U5.2, U6.1, U6.2, U7.1, U7.2, U8.1, U8.4, U8.7, U8.10, U8.12, U9.1, U9.7, U9.10, U9.11, U10.1, U10.3
/HOME_SW: J11.1, R21.1, R22.1
/I2C_SCL: R32.1, U2.12, U10.10
/I2C_SDA: R31.1, U2.11, U10.9
/IN_24V: D1.2, J1.1
/LED1+: J3.1, U4.13, U4.14
/LED1-: J3.2, U4.11, U4.12
/LED1_EN: R3.1, U2.16, U3.2
/LED2+: J4.1, U5.13, U5.14
/LED2-: J4.2, U5.11, U5.12
/LED2_EN: R5.1, U2.17, U3.5
/LED3+: J5.1, U6.13, U6.14
/LED3-: J5.2, U6.11, U6.12
/LED3_EN: R7.1, U2.19, U3.12
/LED4+: J6.1, U7.13, U7.14
/LED4-: J6.2, U7.11, U7.12
/LED4_EN: R9.1, U2.20, U3.9
/MATRIX_CLK: J7.3, R12.2
/MATRIX_DATA: J7.4, R14.2
/MATRIX_SCK: R11.1, U2.14, U8.2
/MATRIX_SCK_5V: R12.1, U8.3
/MATRIX_TX: R13.1, U2.15, U8.5
/MATRIX_TX_5V: R14.1, U8.6
/MOTOR_A1: J10.1, U9.5
/MOTOR_A2: J10.2, U9.6
/MOTOR_B1: J10.3, U9.4
/MOTOR_B2: J10.4, U9.3
/PORT_AT: R17.2, R18.1, U2.27
/PORT_AT_5V: J9.1, R17.1
/PORT_SET: J8.1, R16.2
/PORT_SET_3V3: R15.1, U2.26, U8.9
/PORT_SET_5V: R16.1, U8.8
/RUN: J15.7, U2.30
/SLIDE_DIR: U2.5, U9.16
/SLIDE_EN: R19.1, U2.6, U9.9
/SLIDE_HOME: C6.1, R22.2, U2.7
/SLIDE_STEP: U2.4, U9.15
/SLIDE_UART: R20.2, U2.2, U9.12
/SPARE_GP7: J15.4, U2.10
/SPARE_GP22: J15.8, U2.29
/SPARE_GP26: J15.6, U2.31
/SPARE_GP27: J15.5, U2.32
/SPARE_GP28: J15.3, U2.34
/TH1: J14.1, R33.2, R34.1
/TH2: J14.3, R35.2, R36.1
/TH3: J14.5, R37.2, R38.1
/TH4: J14.7, R39.2, R40.1
/TRIG1: R23.1, R24.1, U2.21
/TRIG1_BASE: Q1.2, R24.2
/TRIG1_OUT: J12.1, Q1.3
/TRIG2: R27.1, R28.1, U2.24
/TRIG2_BASE: Q2.2, R28.2
/TRIG2_OUT: J13.1, Q2.3
/UART_TX: R20.1, U2.1
/VSYS: D2.1, U2.39
