lucaswewa/microscope/crates/microscope-things/src/registry.rs

//! Every Thing type a configuration file can name.
//!
//! Class names look like Python import strings
//! (`microscope.system:MicroscopeSystem`), as in LabThings configuration
//! files; `teta-wot` also accepts the short Rust type name
//! (`MicroscopeSystem`). Each phase that adds a Thing registers it here and
//! names it in `configs/simulation.json`. The plan's Things, by the names
//! they will have (plan §5.3):
//!
//! | Thing | Class | Phase |
//! |---|---|---|
//! | `system` | `microscope.system:MicroscopeSystem` | P02 (here) |
//! | `stage` | `microscope.stage:SimulatedStage` | P16 (here) |
//! | `camera`, `illumination` | `microscope.camera:SimulatedCamera`, `microscope.illumination:SimulatedIllumination` | P17 (here) |
//! | `autofocus` | `microscope.autofocus:Autofocus` | P21 (here) |
//! | `camera_stage_mapping` | `microscope.camera_stage_mapping:CameraStageMapping` | P23 (here) |
//! | `bg_color_channels_luv`, `bg_channel_deviations_luv` | `microscope.background:ColourChannelDetector`, `microscope.background:ChannelDeviationDetector` | P27 (here) |
//! | `stage_measure` | `microscope.stage_measure:StageMeasure` | P30 (here) |
//! | `gallery` | `microscope.gallery:Gallery` | P31 (here) |
//! | `smart_scan`, `snake_workflow`, `raster_workflow` | `microscope.smart_scan:SmartScan`, `microscope.workflows:GridWorkflow` (with its `order`) | P35 (here) |
//! | `histo_scan_workflow`, `c_chip_workflow` | `microscope.workflows:HistoScanWorkflow`, `microscope.workflows:CChipWorkflow` | P37 (here) |
//! | `sequence` | `microscope.sequence:Sequence` | P41 (here) |
//! | `stage`, on a Zaber stage | `microscope.stage:ZaberStage` | M2 P04 (here) |
//! | `camera`, through an SDK (pylon) | `microscope.camera:SdkCamera` | M2 P07 (here) |
//!
//! The test fakes ([`crate::fakes`]) are never here.

use teta_wot::server::ThingRegistry;

use crate::autofocus::Autofocus;
use crate::background::{ChannelDeviationDetector, ColourChannelDetector};
use crate::c_chip::CChipWorkflow;
use crate::camera::SimulatedCamera;
use crate::gallery::Gallery;
use crate::histo::HistoScanWorkflow;
use crate::illumination::SimulatedIllumination;
use crate::mapping::CameraStageMapping;
use crate::sdk_camera::SdkCamera;
use crate::sequence::Sequence;
use crate::smart_scan::SmartScan;
use crate::stage::SimulatedStage;
use crate::stage_measure::StageMeasure;
use crate::system::MicroscopeSystem;
use crate::workflow::GridWorkflow;
use crate::zaber::ZaberStage;

/// Every Thing type a configuration file can name, under its class name.
pub fn registry() -> ThingRegistry {
    ThingRegistry::new()
        .register::<MicroscopeSystem>("microscope.system:MicroscopeSystem")
        .register::<SimulatedStage>("microscope.stage:SimulatedStage")
        .register::<ZaberStage>("microscope.stage:ZaberStage")
        .register::<SimulatedCamera>("microscope.camera:SimulatedCamera")
        .register::<SdkCamera>("microscope.camera:SdkCamera")
        .register::<SimulatedIllumination>("microscope.illumination:SimulatedIllumination")
        .register::<Autofocus>("microscope.autofocus:Autofocus")
        .register::<CameraStageMapping>("microscope.camera_stage_mapping:CameraStageMapping")
        .register::<ColourChannelDetector>("microscope.background:ColourChannelDetector")
        .register::<ChannelDeviationDetector>("microscope.background:ChannelDeviationDetector")
        .register::<StageMeasure>("microscope.stage_measure:StageMeasure")
        .register::<Gallery>("microscope.gallery:Gallery")
        .register::<GridWorkflow>("microscope.workflows:GridWorkflow")
        .register::<HistoScanWorkflow>("microscope.workflows:HistoScanWorkflow")
        .register::<CChipWorkflow>("microscope.workflows:CChipWorkflow")
        .register::<SmartScan>("microscope.smart_scan:SmartScan")
        .register::<Sequence>("microscope.sequence:Sequence")
}
