lucaswewa/microscope/crates/microscope-things/src/lib.rs

//! The microscope's Web of Things.
//!
//! This crate holds every `teta-wot` Thing the server offers (`camera`,
//! `stage`, `autofocus`, `camera_stage_mapping`, `smart_scan`, `gallery`, …),
//! the [`hardware`] interfaces through which Things use one another (so a
//! configuration can swap the simulator for real drivers), and the model for
//! server-described UI elements ([`ui`]). [`registry()`] lists the Things a
//! configuration can name; [`fakes`] has a test Thing for each interface.
//! The Things' names mirror the OpenFlexure Microscope's where practical.
//!
//! The algorithms live in `microscope-core` and the simulator in
//! `microscope-sim`; this crate connects them to `teta-wot`.

pub mod autofocus;
pub mod background;
pub mod c_chip;
pub mod camera;
pub mod capture;
pub mod data;
pub mod fakes;
pub mod gallery;
pub mod hardware;
pub mod histo;
pub mod illumination;
pub mod mapping;
pub mod registry;
pub mod sequence;
pub mod smart_scan;
pub mod stage;
pub mod stage_measure;
pub mod stitch;
pub mod system;
pub mod ui;
pub mod workflow;

pub use registry::registry;
