lucaswewa/microscope/(commit log)

2026-10-09 P00: Docs scaffolding and foundational ADRs (#1)
    Set up the documentation system for milestone 1 and record the decisions that frame it:
    - commit the approved milestone-1 implementation plan and phase specifications, and move goals.md to docs/milestone-1/
    - add the ADR process, template and index, with ADR-0001 to ADR-0004
    - add the implementation-notes index and template, and the P00 notes
    - add a pull request template with the Definition of Done
    - rewrite the README with the project description and doc links
2026-10-09 P01: Rust workspace and CI (#2)
    Create the Cargo workspace and the CI that enforces it:
    - workspace with microscope-core, microscope-sim, microscope-things (libraries) and microscope-server, microscope-launcher (binaries that print their version), with internal dependencies following ADR-0005
    - teta-wot as a git dependency pinned to tag v0.1.0 (teta-wot is now public, so CI needs no credentials)
    - toolchain pinned to Rust 1.98.1, rustfmt style 2024, workspace lints
    - .gitattributes for LF line endings; .gitignore for web, dev data and reference screenshots
    - GitHub Actions job on windows-latest: fmt, clippy, test, doc
    - ADR-0005, P01 notes, README development section; P00 marked Done
    Co-Au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
2026-10-09 P03: Server logging and log endpoints (#4)
    Keep a server-wide log that the app can show and download:
    - one tracing subscriber with four outputs: the console (RUST_LOG), teta-wot's invocation logs, an in-memory server log of the last 1000 records, and daily log files in log_folder
    - records in teta-wot's LogRecord shape plus sequence, name, invocation_id, thing and action; events are credited to the invocation the invocation manager knows (ADR-0008)
    - INFO and above captured; --debug adds DEBUG from this application and teta-wot only
    - GET /api/v1/log/ (JSON, oldest first, ?level=) and GET /api/v1/logfile/ (the newest file as a text attachment)
    - logging starts once the configuration names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
2026-10-09 P06: Design tokens and theme switching (#7)
    Give the app its own design tokens and a Light, Dark or Follow System theme that survives reloads:
    - tokens.css: palette and semantic tokens with light and dark themes on [data-theme], derived from the P05 measurements (ADR-0011)
    - base.css: page background, text, system fonts, light headings, focus ring, reduced motion
    - the theme store: preference in localStorage (guarded), the system's dark mode followed, data-theme applied to <html>
    - an inline bootstrap script in index.html applies the saved theme before the first paint
    - /#/dev/tokens (development builds only) shows every token in both themes
    - tests: the store; bootstrap agreement in every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
2026-10-09 P07: App shell and navigation rail (#8)
    Give the app OpenFlexure's frame, with this project's own components:
    - the navigation rail: View, Control, Slide Scan, Sequence and Gallery at the top; Settings, Logging, About and Power pinned to the bottom; icons above labels; the active item a solid accent block
    - AppIcon draws Material Symbols from their raw SVG (ADR-0012); attribution in NOTICE
    - a route and a placeholder page per destination, with ControlPane and MainView layout primitives
    - Shift+Up/Down cycle through the tabs; a notice in narrow or portrait windows; the tab-availability hook for P11
    - unit, end-to-end and visual tests, including the rail's proportions against the P05 referenc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
2026-10-09 P08: UI components I: controls (#9)
    * P08: UI components I: controls
    The controls every tab is built from, as this project's own components
    on its design tokens (ADR-0013):
    - AppButton (default, primary, danger, ghost; two sizes) and IconButton.
    - TextField, and NumberField, which commits on Enter or blur only, with
    min, max, step, arrow-key stepping and an invalid state.
    - FormField: label, help and error, wired to its control.
    - AppSelect and AppAccordion/AccordionSection on Reka UI 2.10.5.
    - AppCheckbox and AppToggle on native checkboxes.
    - ProgressBar, AppSpinner, AppCard and SectionHeading.
    - A development-only gallery at /#/dev/components, in both themes.
    Also: an ESLint rule limi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
2026-10-09 P09: UI components II: overlays and feedback (#10)
    * P09: UI components II: overlays and feedback
    The components that appear over a page, on Reka UI (ADR-0013):
    - AppDialog: a modal dialog with Escape and outside-click policies, an
    alert-dialog mode, and focus starting on its first field or button.
    - useConfirm(): a promise-based confirmation with rich content, queued.
    - useToast(): success, info and error toasts with folded details.
    - AppTooltip, which IconButton now uses in place of title.
    - ErrorDetails and describeError(), for teta-wot's {detail}, 422 and
    problem bodies, text, Errors and anything else.
    - OverlayProvider in App.vue, and an Overlays section in the gallery.
    P09 is sp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
2026-10-09 P09b: UI components III: menus, lists and shortcuts (#13)
    * P09b: UI components III: menus, lists and shortcuts
    - AppMenu and ButtonMenu on Reka UI's DropdownMenu: actions with icons,
    disabled and destructive states, and separators.
    - AppPagination on Reka UI's Pagination, as a "Pages" navigation region.
    - MultiSelect on Reka UI's Select with multiple: values kept in the
    options' order, labels shown without flicker, aria-multiselectable.
    - The keyboard-shortcut registry (provideShortcuts, useShortcut, keysOf):
    conflicts refused, typing and dialogs left alone, shortcuts removed
    with their component. Shift+Up/Down tab switching now runs on it, and
    ? opens a dialog listing every shor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
2026-10-09 P11: Connection management (#15)
    * P11: Connection management
    Connect to the server that served the page, or to another microscope by
    its address, and keep the rest of the app unaware of where it is
    (ADR-0015):
    - Profiles: this server, or a remote origin typed as lab-pc:5000;
    ?microscope= in the page's address; recent connections remembered.
    - A connection store: idle, connecting, connected, lost, reconnecting;
    the client, cached descriptions and host name; a heartbeat every 5 s;
    retries after 1 s doubling to 10 s; Retry; late answers to abandoned
    attempts ignored; the window title.
    - The /#/connect screen, a connection indicator in the rail, and an
    offline overlay with Retry. Ta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
2026-10-09 P12: Serve the web app from the backend (#16)
    * P12: Serve the web app from the backend
    microscope-server now serves the web app at / as well as the API
    (ADR-0016):
    - /, /index.html, /assets/{*path} and /favicon.svg from web/dist:
    embedded in release builds (rust-embed 8.12), read from disk in
    debug builds, or from --webapp-dir; a placeholder page without a
    build. index.html is never cached; hashed assets are immutable.
    - Paths that could leave the build are refused.
    - A build script rebuilds the server when web/dist changes.
    - A favicon: Material Symbols' biotech, in the accent colour.
    - The end-to-end tests run against the app as the server serves it;
    a new CI job builds the web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
2026-10-09 P13: Simulation world, optics and blob specimen (#17)
    * P13: Simulation world, optics and blob specimen
    The pure-Rust core of the image simulator, in microscope-sim
    (ADR-0017):
    - Units: stage steps with a per-axis um scale, the sample plane in um,
    and image pixels (pixel pitch over magnification).
    - The Specimen trait: any region at any scale, deterministic, with
    sub-pixel detail drawn as its average.
    - BlobSpecimen: procedural coloured blobs from hashed grid cells;
    finite with an empty margin, or repeating.
    - Optics: 4x to 100x objectives, field of view, depth of field, and
    blur from the diffraction limit and the defocus cone, as three box
    blurs per direction on a frame with a m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
2026-10-09 P14: Simulated stage motion model (#18)
    * P14: Simulated stage motion model
    A model of an XYZ stage in microscope-sim, with imperfections that can
    be switched on and off:
    - Three positions per axis, in steps: the motors', the carriage's (the
    true position) and the reported one (motors minus a zero offset).
    - Timed moves in a straight line at each axis's speed; every call takes
    the time, and a new command interrupts the current move from where
    the motors are (the latest wins); stop() lands on whole steps.
    - Backlash per axis: the carriage stays within half the play of the
    motors.
    - Travel limits per axis: a move stops where the first axis reaches its
    limit, and reports LimitReache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
    [clock.rs, lib.rs, stage.rs]
2026-10-10 P15: Hardware interfaces and units (#20)
    * P15: Hardware interfaces and units
    The seams that let milestone-2 drivers replace the simulator through
    configuration alone (ADR-0018, ADR-0019):
    - StageApi, CameraApi and IlluminationApi as teta-wot interfaces, with
    Position (whole steps per axis), AxisScale (um per step where known),
    CaptureMetadata, Capture and StreamInfo.
    - The conventions: one Thing type per driver, shared behaviour in plain
    structs, SDKs behind Device<D> actors, OpenFlexure's names.
    - Test fakes for each interface, outside the server's registry.
    - registry() moves to its own module, with the plan's Things.
    - A test shows configuration alone choosing the hardware.
    Mark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
    [camera.rs, fakes.rs, hardware.rs, illumination.rs, lib.rs, registry.rs, stage.rs]
2026-10-10 P16: Simulated stage Thing (#21)
    * P16: Simulated stage Thing
    The `stage` Thing, SimulatedStage, on the P14 stage model, mirroring
    OpenFlexure's stage and providing StageApi: moves that wait and can be
    cancelled, jogs where the latest wins, halt, axis inversion, the z-direction
    check, persistent settings (including the simulation's speed, backlash and
    travel limits), the `arrived` event, and backlash compensation through the
    shared BacklashCompensation struct. The shipped configuration runs it.
    * P16: Link the pull request in the notes
    ---------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
    [lib.rs, registry.rs, stage.rs]
2026-10-10 P17: Simulated camera and illumination Things (#22)
    * P17: Simulated camera and illumination Things
    The `camera` Thing, SimulatedCamera, shows the sample where the simulated
    stage really is. A preview thread draws about 10 frames a second into
    mjpeg_stream and lores_mjpeg_stream through the shared PreviewFrames struct
    (ADR-0020), with two streaming modes, JPEG grabs, settings for the
    objective, sample, noise, exposure and gain, and sample removal. It provides
    CameraApi, including captures with metadata. The `illumination` Thing,
    SimulatedIllumination, has set_led and flash; frames are black while its
    LED is off. The web app now requires `camera`.
    P17 is split at the owner's choice: the cap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
    [camera.rs, illumination.rs, lib.rs, optics.rs, registry.rs]
2026-10-10 P17b: Capture buffer and settling (#23)
    * P17b: Capture buffer and settling
    The camera holds captures in memory through the shared CaptureBuffer
    struct: capture_to_memory returns an id and keeps at most buffer_max,
    save_from_memory saves one to a path inside the data folder as a JPEG or
    PNG without the global lock, and clear_buffers empties memory. settle waits
    settling_time and then discard_frames, which waits for any frame being
    drawn, so the next frame shows the stage where it is.
    The data folder comes from application_config, with its default shared
    with the server. The harness tests now switch the global lock on, as the
    shipped configuration does, which makes P16's lock-free jog and h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
2026-10-10 P18: MJPEG streaming in the client (#24)
    * P18: MJPEG streaming in the client
    The web app reads the camera's MJPEG streams with fetch. A multipart parser
    reads parts split anywhere between chunks, honours Content-Length, and hands
    on a JPEG as soon as it is complete. WotClient.frames() follows a stream with
    the client's headers and reconnects like its server-sent events, and
    ConsumedThing.streamUrl() finds a stream through the TD's links. watchStream
    shares one request per URL between viewers, decodes each frame once with
    createImageBitmap, keeps only the newest while decoding, caps the frame rate,
    and stops a second after the last viewer leaves.
    P18 is split at the owner's choice: LiveIma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
2026-10-10 P18b: View tab: live image (#25)
    * P18b: View tab: live image
    The View tab shows the camera's live image, full window. LiveImage draws the
    shared MJPEG stream to a canvas, contain-fit with letterboxing, and says why
    when there is no image: connecting, turned off, no connection, or an error.
    It pauses its stream while off screen or while the page is hidden, and
    flashes when flashLiveImage() is called for a capture. A "Disable stream"
    button turns the stream off and on, remembered in this browser.
    On the development machine the View tab runs at 9.9 fps, using 9.3% of one
    core across the browser's processes.
    * P18b: Link the pull reque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
2026-10-10 P19: Generated API types and typed facades (#26)
    * P19: Generated API types and typed facades
    The web app's API types now come from the server's OpenAPI document.
    microscope-server --print-openapi writes the configured Things' document
    without starting them; npm run api:openapi and api:types turn it into the
    committed web/src/api/generated/openapi.json and schema.d.ts. The server's
    CLI tests fail when the document is stale, and CI's web job fails when the
    types are. TypedThing<'stage'> and useThing() wrap the P10 client with
    names and values typed from the generated schemas: unknown affordances,
    writes to read-only properties, wrong values and missing required inputs
    are compile errors (ADR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
2026-10-10 P20: Control tab: stage navigation (#27)
    * P20: Control tab: stage navigation
    The Control tab puts a narrow control pane beside the live image. Its
    Position section shows the live position over SSE, has x, y and z fields
    with Refresh, a cancellable Move, Set Home, and Move Home behind a "remove
    your sample" confirmation. A d-pad and focus buttons, and the arrow keys
    and PgUp/PgDn, jog the stage through a tested jog controller: a tap moves
    one step, holding renews the jog every 300 ms until release stops it, and
    presses combine. The keys are listed in the ? dialog.
    P20 is split at the owner's choice: wheel focus and the navigation
    preferences move to P20b, which closes Checkpoint A (plan Ap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
2026-10-10 P20b: Control tab: wheel focus and navigation preferences (#28)
    * P20b: Control tab: wheel focus and navigation preferences
    The mouse wheel over the live image focuses: turning it away focuses up a
    z step a notch, with the turns added up and sent as one jog every 100 ms.
    Navigation preferences (a step size and an inversion for each axis) are
    kept in this browser, checked when read, used by the d-pad, the keys and
    the wheel, and set in a collapsed Navigation section of the control pane.
    This closes Checkpoint A: the live image, the buttons, keys, wheel and
    typed coordinates are each tested end to end. It also marks P20 Done.
    * P20b: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
2026-10-10 P21: Autofocus (#29)
    * P21: Autofocus
    The autofocus Thing sweeps the stage through focus while watching the
    live stream, as OpenFlexure's does: sharpness is the JPEG size of the
    camera's small preview frames, each frame's z is interpolated from the
    stage sampled every 20 ms, and the stage approaches the sharpest point from
    below so backlash lies the same way. fast_autofocus, looping_autofocus and
    z_move_and_measure_sharpness each return a focus curve, and work through
    CameraApi (which gains lores_stream) and StageApi alone. Frames are now
    timestamped when taken. The Control tab gains an Autofocus button and the
    a key (ADR-0022; the behaviour spec opens the P21 notes).
    This also marks P20b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
    [autofocus.rs, camera.rs, fakes.rs, lib.rs, registry.rs]
2026-10-11 P22: Image registration core (#30)
    * P22: Image registration core
    microscope-core can now measure how far an image's content moved between
    two frames, by phase correlation: shrink, cut a centred power-of-two
    square, window it, take the normalised cross-power spectrum, and find the
    peak, refined by a parabola to about 0.05 px, with a confidence from the
    next highest peak that falls for periodic patterns, unrelated images and
    empty fields. A radix-2 FFT keeps the core free of dependencies. An example
    in microscope-sim registers rendered frames to within 0.2 px of the
    stage's move, in about 9.5 ms (ADR-0023).
    This also marks P21 Done.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
2026-10-11 P23: Camera–stage mapping (#31)
    * P23: Camera–stage mapping
    Add the camera_stage_mapping Thing. calibrate_xy sizes a step for each
    axis, measures four runs of five moves by image registration, estimates
    backlash, and fits the image-to-stage displacement matrix. It saves every
    move as JSON in the data folder. move_in_image_coordinates and the two
    conversions use the matrix.
    Untrusted registrations are left out rather than failing the
    calibration, and the step is scaled to the target, so sparse places on
    the sample still calibrate. An axis with fewer than five usable moves
    fails.
    The simulated camera gains an orientation setting (rotation and mirror),
    so the matrix is more than a scale.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
2026-10-11 P23b: Click-to-move (#32)
    * P23b: Click-to-move
    Double-clicking the live image on the Control tab now moves the stage so
    that the point double-clicked comes to the centre, through the camera-stage
    mapping. LiveImage reports the point on the contain-fit image as shares of
    its size, ignoring the letterboxing. The Control tab scales the point to the
    calibration's image resolution, and ignores double-clicks while a move runs.
    If the mapping isn't calibrated, it says so.
    Mark P23 Done, and P23b In review.
    * P23b: Link the pull request in the notes
    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
2026-10-11 P24b: Server-described action and download buttons (#34)
    * P24b: Server-described action and download buttons
    A Thing's panel can now hold buttons that run its actions and download its
    files (ADR-0024).
    ActionButton asks a question first if the panel gives one. While the
    action runs, it shows its progress beside the button, or in a dialog with
    the log and a camera's small live stream. It can be cancelled unless the
    panel says not. It reports success with a message or the action's output,
    and asks for the panel to be refreshed when the panel says to.
    DownloadButton saves what a Thing's GET endpoint answers, or the file an
    action returns, through WotClient.download and the host.
    ThingUi ch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
2026-10-11 P25: Specimens II and optical effects (#35)
    * P25: Specimens II and optical effects
    The simulated microscope gets realistic samples and imperfect optics, all
    switchable while it runs.
    microscope-sim gains:
    - TissueSpecimen: H&E-like stroma with fibres, nuclei and gaps, with a
    coverage setting;
    - ImageSpecimen: a PNG, JPEG or TIFF picture at a scale, with mip levels
    and bounds;
    - Effects: a focal surface that tilts and waves, vignetting, uneven
    lighting, and exposure and gain, with gain brightening the noise too.
    Tissue samples its slowly varying fields on a grid fixed to the slide, so
    a preview frame takes 30-46 ms.
    The camera has a sample type and settings for each of these. It lo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
2026-10-11 P26: Capture to the data folder (#36)
    * P26: Capture to the data folder
    The camera's new capture action takes an image at full resolution
    (standard) or the stream's size (quick). With retain_image, it saves the
    image to the data folder's captures/ as a JPEG with a JSON sidecar
    (ADR-0025). Either way, it returns the image as a Blob to download.
    The sidecar records:
    - the time;
    - the stage position, in steps and in um;
    - the camera's settings;
    - the camera-stage mapping, once calibrated;
    - the simulator's state.
    Captures are named by their UTC time to the second. A second capture in
    the same second gets -2, then -3, and no file is ever overwritten. Saving
    lives in microscope_things::capture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
2026-10-11 P27: Background detection and camera calibration (#37)
    * P27: Background detection and camera calibration
    The microscope can now tell sample from the empty slide, and the
    simulated camera can be calibrated for it.
    microscope_core::background converts sRGB to CIE L*u*v*. It compares an
    image with a background in two ways: by each pixel's colour
    (ColourStatistics) and by each region's texture over an 8 x 8 grid
    (TextureStatistics).
    Two detector Things, bg_color_channels_luv and bg_channel_deviations_luv,
    sit behind a BackgroundDetector interface. Each has tolerance and
    coverage settings, stored statistics, and a settings_ui panel.
    The camera uses one detector, named by background_detector_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
2026-10-11 P28: Settings tab (#38)
    * P28: Settings tab
    The Settings tab replaces its placeholder. Its sections are listed in
    the control pane, and the chosen one is in the address, such as
    /#/settings/camera.
    Application: Display (the theme, full screen, and turning the live image
    off), Stage control (the navigation preferences), and Connection (the
    Connect screen, embedded, staying in Settings after connecting).
    Microscope: a disabled Calibration wizard button for P29; Camera, with a
    mini stream and the camera's and its background detector's
    server-described panels; Stage, with whether z is inverted and Invert z;
    and Camera-stage mapping, with Calibrate, the matrix, the scale, the
    field of view and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
2026-10-11 P29: Calibration wizard (#39)
    * P29: Calibration wizard
    The calibration wizard guides the user through every calibration the
    microscope needs: a dialog of tasks made of steps, with Back, Next, Skip
    and Finish.
    Tasks are found as OpenFlexure finds them. A task is offered for the
    stage, the camera and the camera-stage mapping when the server has the
    Thing, it has calibration_required, and can_calibrate isn't false. On
    connecting, once for each connection, the wizard opens with a welcome and
    the tasks that need doing. Settings opens it with every task. Closing it
    early asks first.
    The simulated stage has no z gear to watch, so it describes its own check
    in a panel, z_direction_check (ADR-002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
2026-10-12 P30: Stage measurement tools (#40)
    * P30: Stage measurement tools
    stage_measure finds how far the stage travels in x and y by watching the
    image, and recentres it. The behaviour spec opens the P30 notes.
    perform_rom_test steps towards each end of each axis, a big step then a
    check step that it measures by registering the frames before and after,
    until the image no longer follows. It then steps back until the image
    moves again, and the end is where that step started from: the position
    after it plus the motion it made. With autofocus, it measures how far the
    focus moved at each end. The range is kept as calibrated_range.
    perform_recentre moves to the middle of the range and makes it the
    sta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
2026-10-13 Fix the range-of-motion test on sparse samples (#41)
    On the default sample, about 1 check step in 65 lands on a field whose
    middle has no blobs, so registration can't measure it, and that ended the
    whole test. Where a check step can't be measured, the test now steps
    aside, across the axis, to a fresh field and carries on, up to 10 times
    for each end. Its errors say where the stage was.
2026-10-13 P32: Gallery tab (#43)
    The Gallery tab shows everything the microscope has saved (ADR-0026) as
    cards, newest first, 18 or 25 to a page, detailed or thumbnails only,
    with "Showing a-b of n", page buttons and Refresh. Each card has its
    thumbnail (or a placeholder), its name and time, its download (a button,
    or a menu of several), its actions, View and Delete (which asks first),
    its info lines and its warnings. A sidebar chooses the types shown and
    the cards per page, runs the bulk actions, and deletes everything of the
    types shown, after a question that lists them. View shows the image in a
    dialog until the viewer (P33).
    The server-UI download logic moves into useDownload, shared by panels'
    b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
2026-10-13 P33: Image and deep-zoom viewer (#44)
    The gallery's View opens a viewer on OpenSeadragon (ADR-0027), loaded
    when first needed: one image, a deep-zoom (DZI) image, or a sequence of
    images stepped through with a slider. The wheel, a pinch and the buttons
    zoom, dragging pans, and "Show it all" fits the image again. Brightness,
    contrast and saturation have sliders, with Reset, and the viewer can
    fill the screen. Its controls are the app's own, so they follow the
    theme.
    AppSlider joins the UI components, and AppDialog gains a full size. The
    gallery's viewer data gains dzi and directory kinds, for scans (P38) and
    sequences (P41). A small DZI fixture, drawn by the simulator, serves the
    end-to-end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
2026-10-13 P34: Scan planners (#46)
    microscope_core::scan says where a scan goes next (ADR-0028), as pure
    code from the behaviour spec that opens the P34 notes. A Planner hands
    out sites, stage positions in steps, each with a z to start focusing
    from, and is told what happened at each.
    - Step::from_overlap: the field of view less the overlap, through the
    camera-stage mapping, keeping signs and handling a quarter turn;
    Step::equal makes the steps equal.
    - RegularGrid: raster or snake, and the C-Chip pattern (5 x 7 at 0.1).
    - SmartSpiral: grows out around the sample, skips background, fills the
    gaps at its edge, stays within its range and says why it finished.
    - z estimates from nearby focused sit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
2026-10-13 P35: Scan engine with snake and raster workflows (#47)
    smart_scan runs the chosen workflow over its sites (ADR-0029). The
    ScanWorkflow interface has begin, which gets ready and fixes the
    settings and the planner (P34), and acquire, which focuses and saves
    the images at a site. GridWorkflow is configured as snake_workflow and
    raster_workflow, with OpenFlexure's settings, ready and settings_ui.
    sample_scan runs one scan at a time under a checked name made unique.
    At each site it moves at the planner's suggested z, then autofocuses
    and captures. The scan's folder in scans/ keeps the images with their
    sidecars, the record (scan.json) and the log (scan.log). However the
    scan ends, the stage goes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
2026-10-14 P36: Smart z-stacks (#49)
    autofocus.run_smart_stack climbs through focus dz at a time, judging
    its latest images by sharpness, retries from a new autofocus when focus
    is out of reach, and saves the sharpest images, centred on the
    sharpest. run_basic_stack takes and saves a set number about z. The
    snake and raster workflows take a smart stack at each site, with the
    stack settings in their panel and the scan's record.
    The judging is pure, in microscope-core. Testing on the simulator's
    default sample changed two rules of the spec: a window must rise by 3%,
    and the fitted parabola need only curve downwards.
    Marks P35b Done.
2026-10-14 P37: Histo smart-spiral and C-Chip workflows (#50)
    histo_scan_workflow spirals out over a tissue section from the start,
    skipping sites that look like background and taking a smart stack where
    there's sample. It has its own background detector, with set_background
    and check_background, and a panel with Background detect and Scan
    settings sections. It's now the default workflow.
    c_chip_workflow takes a basic stack at each site of the C-Chip pattern,
    every stack centred on the start's focus.
    Action buttons say an output's message, if it has one, rather than its
    JSON.
    Marks P36 Done.
2026-10-14 P38: Mosaic and deep-zoom pyramid core (#51)
    microscope-core places scan images by stage position through the
    camera-stage mapping, blends them where they overlap, and draws a
    reduced preview or writes a DZI pyramid as the gallery's viewer reads
    it, with an overview and a thumbnail. The pyramid is written a row of
    tiles at a time, so memory grows with the mosaic's width, not its area.
    Files go through the caller, so the crate stays free of I/O.
    ADR-0030 records the decision. examples/mosaic.rs writes and times a
    made-up scan. Marks P37 Done.
2026-10-14 P39: Live and final stitching (#52)
    While a scan runs, its live preview is drawn again after each site,
    at smart_scan/latest_preview_stitch.jpg, with its time in the live
    details. Once it ends, it's stitched in the background into its
    stitched/ folder if stitch_automatically is set. stitch_scan,
    stitch_all_scans and download_stitched_zip run without the global
    lock. A stitched scan's gallery card opens its mosaic in the deep-zoom
    viewer and offers its overview and tiles; an unstitched one has a
    Stitch button.
    Marks P38 Done.
2026-10-14 P40: Slide Scan tab (#53)
    The Slide Scan tab runs a scan from the app. Before one, it chooses the
    workflow, with what it does and its server-described settings, the
    stitching settings, whose title says when they've changed, and a sample
    ID. While one runs, wherever it was started, it shows the live
    stitching preview, a mini stream, the scan's details, settings dialog
    and log, and a Cancel that names its phase. Once it ends, Download ZIP
    and Close. Each workflow now says what it does, through
    smart_scan.workflow_descriptions.
    An end-to-end test runs a scan from the tab and finds it stitched in
    the gallery: Checkpoint D. Marks P39 Done.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
2026-10-14 P44: Sidecar process contract (#57)
    With --managed, the server prints MICROSCOPE_READY with its URL, process
    ID and version once its Things have started, and stops gracefully when
    standard input closes. The system Thing gains managed, shutdown (exit
    code 0) and restart (exit code 75, only when managed), which don't take
    the global lock. ADR-0032 records the contract for the launcher and,
    later, Tauri.
    Marks P43 Done.
2026-10-15 P46: About and Power tabs (#59)
    About shows the microscope's computer, address, server version and
    source, operating system, whether the launcher manages it, its hardware
    types and Flash illumination, our intended-use statement, and links to
    the repository and its issues. Power shuts the server down after asking,
    then shows it has stopped with Reconnect; restarts it when managed; and
    disconnects from another microscope. With every tab built, the
    placeholder page goes.
    The launcher now prefers the port the server last served on, so the app
    finds it again after a restart when port 5000 was taken.
    Marks P45 Done.
2026-10-15 P48: End-to-end, soak and performance (#61)
    A workflow suite against the real server: a first session from
    connecting to a capture in the gallery, a histo scan ending stitched, and
    Restart through the launcher, beside the earlier end-to-end tests. A soak
    test streams and scans for 30 minutes and checks the server's memory and
    handles by their trend; budget tests measure the preview's frame rate, a
    scan's time per tile and tab changes. A nightly workflow runs both
    against a release build and keeps their measurements.
    Marks P47 Done.
2026-10-15 P50: Control pane: a steady layout and the wide pane (#63)
    "Moving..." now sits in the live position's row, which is always there,
    so the pane no longer jumps as the stage starts and stops; it's a
    screen-reader status. The Control tab's pane is wide, as Slide Scan's and
    Sequence's are, with the Position section's fields and buttons in rows of
    three. The plan gains Stage 9 (P50-P54), added after v0.1.0.
2026-10-15 P51: Slide Scan: an autofocus switch (#64)
    smart_scan.autofocus_enabled, on by default, is passed to the workflow
    when a scan begins and at each site. Off, a scan doesn't autofocus at its
    start, and takes one image at each site where the stage is instead of a
    smart z-stack; C-Chip keeps its basic stack. The scan's record and log say
    so, and the Slide Scan tab has a switch. P50 is marked Done.
2026-10-15 P52: Sequence viewer: smooth switching and playback (#65)
    A sequence's images are kept in one OpenSeadragon world, hidden until
    shown: a new image is shown once it's fully loaded, and only then is the
    one before hidden, so the view never empties and the zoom and pan stay.
    The next two load ahead. The viewer gains Play/Pause, the seconds each
    image shows from when it's drawn, and Loop. P51 is marked Done.
2026-10-16 P53b: Overlay layers in the deep-zoom viewer (#67)
    The gallery's deep-zoom viewer gains the path of a stitched scan's
    tiles.json, and the viewer draws its image outlines over the mosaic,
    placed again on every viewport update so they follow pans and zooms, with
    a Layers menu beside the zoom buttons. A scan stitched before P53 offers
    Stitch again, and its stamp includes tiles.json. Menus and selects get a
    layer above dialogs (--z-menu). P53 is marked Done.
2026-10-16 P54: Autofocus accuracy (#68)
    A benchmark on the simulator (tests/autofocus_bench.rs, ignored by
    default) measured autofocus 6-9 µm out at some sites, where a sweep's
    frames missed the narrow sharpness peak and took a side of the hump around
    it, and up to 46 µm out on empty fields. Focus is now the curve's centroid
    above half height (microscope_core::focus::peak), and a curve rising by
    less than 3% has nothing to focus on: fast autofocus goes back where it
    began, looping stops after one sweep, and the Control tab says so. A
    smart stack keeps the image nearest its curve's centroid. Fast and looping
    autofocus now end a mean of 0.2 µm from focus (ADR-0037, superseding
    ADR-0022 in part). P53b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
2026-10-16 Keep a scrolling pane's controls at their heights; mark P54 Done (#69)
    Slide Scan and Sequence lay their control pane out as a flex column, so
    when its contents were taller than the pane, flex items shrank to fit:
    with the histo scan's and the stitching's settings open, Start Smart
    Scan shrank to 19.5 px. ControlPane now keeps its slotted children from
    shrinking, and the pane scrolls as it was meant to. An end-to-end test
    follows the steps in a short window. P54 is marked Done.
2026-10-16 Milestone 2 plan (#70)
    The owner's goals, the implementation plan and the phase specifications
    for milestone 2: Basler (pylon), Allied Vision (Vimba X) and Pi cameras;
    Zaber stages through their ASCII protocol and the Sangaboard; Linux and
    the Raspberry Pi 5; correlation stitching; token authentication; mDNS
    adverts; and the Tauri desktop app with discovery and signed installers.
    21 phases in 9 stages, hardware first. Docs only.
2026-10-16 M2 P00: Milestone 2 groundwork (#71)
    ADR-0038 sets milestone 2's platforms (Windows x86_64, Linux x86_64 and
    Linux ARM64 on a Raspberry Pi 5, with CI on all three), superseding
    ADR-0003. Milestone 2's notes folder, with a template whose Hardware
    section records what each phase was tried on; hardware.md with the SDKs
    found on the owner's PC and the hardware tests' variables; and CLAUDE.md
    for milestone 2: its plan, branches, platforms and hardware rules. The
    plan is marked approved, with the review points' outcome.
2026-10-21 P03a: Device actors and serial ports (#75)
    - The device-actor pattern for drivers (ADR-0041): a teta-wot Device<D>
    made from the Thing's configuration, device_error for actions' errors,
    and a reconnect action that resets the device.
    - drivers::serial: Line, a conversation in text lines; SerialPort over
    serial2 (BSD-2-Clause or Apache-2.0); and Script, a fake device that
    follows a script, for protocol tests.
    - drivers::hardware_device: hardware tests run only where a variable
    names their device.
    - configs/README.md: a configuration per hardware set, a stage by its
    port and a camera by its serial number.
    - release/about.toml lists the Linux targets' crates too.
    - ADR-0041, for P03a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
2026-10-21 P03b: The SDKs at run time, and listing devices (#76)
    * P03b: The SDKs at run time, and listing devices
    - microscope-sdk: pylon's and Vimba X's C APIs, loaded at run time
    with libloading (ISC). The one crate allowed unsafe code (ADR-0041);
    each unsafe block has a SAFETY comment. A missing SDK is an error
    that says where it was looked for and how to get it.
    - One SDK starts at a time: started at once on two threads, Vimba X
    missed the cameras it found when they started one after the other.
    - drivers::list_devices and microscope-server --list-devices: the
    serial ports, and each SDK's cameras, or why it can't look.
    - The release accepts ISC. CLAUDE.md: unsafe code only in
    microscop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
2026-10-21 P04: Zaber stages (#77)
    - drivers::zaber: Zaber's ASCII protocol, from its documentation, over
    Line: commands with ids, replies found by address and id among alerts
    and other devices' lines, refusals and warning flags explained.
    - ZaberStage: StageApi over a daisy-chained XYZ stage (devices 1-3 by
    default). Moves poll until idle, so the position is read while moving
    and halt gets through; jogs; home; reconnect; a zero and inverted axes
    kept in the driver; faults end moves, warnings are logged once.
    Microstep sizes from the configuration make it um-native.
    - The settings panel: top speeds and accelerations in steps a second,
    read from the devices and written to them, and homing.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
2026-10-21 Flaky tests: a race in property controls, and tests that say why (#78)
    * Flaky tests: a race in property controls, and tests that say why
    - PropertyControl: values the Thing sends while a write is on its way
    are older than the edit, so they're passed over, and the value is read
    once the last write is done. Before, the Thing's echo of one edit could
    undo the next: the timelapse test's hour became 1:10:00.
    - The timelapse test cancels its hour-long sequence if it fails, so its
    retries find the microscope free.
    - The camera's save test gives the save 4 s rather than 1.
    - The scan that fails at the second column checks that it did; the
    smart-stack test says how a stack failed; the ran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
2026-10-21 P06: The SDK camera pipeline (#79)
    * P06: The SDK camera pipeline
    - microscope_core::pixels: an SDK's pixels as 8-bit RGB. Mono and
    deeper mono scaled, RGB and BGR, and Bayer mosaics in four
    arrangements and 8 to 16 bits, demosaicked bilinearly; GenICam's names.
    - hardware::FramePipeline: frames from an SDK's callback to the preview
    (at most one every 100 ms, shrunk to fit 1024 x 1024, through
    PreviewFrames to both streams and autofocus) and to captures (the next
    frame whole, with its metadata). Skipped frames aren't converted.
    - hardware::settings_panel: the standard features every SDK camera's
    Thing has properties for, made into its settings panel from the
    features its SDK r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
2026-10-21 P07: Basler cameras (#80)
    - microscope-sdk::pylon: pylon's camera API. Cameras listed by serial
    number and model; one opened by its serial number; its features read
    and written as text by GenICam name, and an enumeration's choices;
    continuous grabbing on a thread of its own into four queued buffers,
    rows unpadded; pylon's own error messages. AcquisitionMode Continuous
    and TriggerMode Off before grabbing.
    - SdkCamera, one camera Thing for every SDK (ADR-0044), over CameraSdk:
    its streams and captures through FramePipeline, its standard features
    as properties and a panel, background detection, calibration through
    the camera's own automatic exposure and white balance, a format t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
2026-10-24 P12: Correlation placement (#81)
    * P12: Correlation placement
    Where each image of a mosaic really is, from its overlaps (ADR-0046):
    each overlapping pair is registered twice by phase correlation, unsure
    or too-large corrections are rejected, and one least-squares solve,
    weighted by confidence, places every image. The simulated stage can
    drift, losing steps and creeping, switched at run time.
    * P12: the notes link their pull request
    ---------
2026-10-24 Correlation: drop pairs that disagree with the solve (#84)
    * Correlation: drop pairs that disagree with the solve
    A confident but wrong pair (0.36 sure, 33 px from the truth) could move
    an image, and P13's drifting-scan test failed on CI. Now the used pair
    that disagrees most with where the solve put its two images, by more
    than 3 px, is dropped, and the images are solved again, until none does.
    * The drifting-scan test in a file of its own
    Autofocused and captured whole, it slowed smart_scan.rs's other scans
    beside it, and one of their cameras timed out on CI. As
    tests/correlation.rs, CI runs it in "the rest", where each test file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
2026-10-31 OPTIMA's features, and a hardware design for an upright build (#88)
    docs/misc/optima.md lists OPTIMA's features. The design proposes an
    upright, automated microscope with those features from off-the-shelf
    parts: Mitutoyo 5x/10x/20x objectives, a Thorlabs TTL200-A tube lens,
    the ToupTek CTR3CMOS45000KMA and a colour camera, an LED matrix and
    four-LED epi-fluorescence, and Standa stages. It covers the optics,
    illumination, motion, electronics, software, tests, risks, and a bill
    of materials with the decisions left for the owner.
2026-11-01 C01: Tooling and the optical layout (#89)
    The first phase of OPTIMA's CAD plan (docs/misc/optima_cad_plan.md):
    Python scripts in cad/optima build FreeCAD 1.1 documents offscreen,
    reproducibly, and check them. make.py writes cad/optima/models and its
    REPORT.md, and --check fails if they're out of date or a check fails.
    optical-layout.FCStd holds the optics: the sample and fields, the
    three objectives on the changer, the tube lens and both mirrors, the
    light folded to both cameras, the camera bodies, the epi illuminator,
    the LED matrix, and the space the changer and slider sweep. Its ten
    checks cover vignetting, mirror apertures, collisions, the stack along
    the axis, the LED image and the mat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
2026-11-01 C02: Bought parts: stages and cameras (#90)
    Simplified models of the Standa 8MTF-102LS05 XY stage and 8MVT100-25-1
    lift, the mono and colour ToupTek cameras and an assumed overview camera,
    each in its own document and checked against its vendor's drawing. The
    optical layout uses the real camera bodies. Rebuilds stay byte-identical,
    and make.py stops FreeCAD if it hangs on its way out.
2026-11-01 C03: Bought parts: optics, motion and electronics (#91)
    Simplified models of the Mitutoyo objectives, the TTL200-A, the fold
    mirror's cage cube and the MFF102/M camera port, the epi parts, the
    MGN12 guide and NEMA 11 stepper, the Adafruit 2734 matrix and the
    electronics, in six documents with their checks. The optical layout
    uses the objectives, the tube lens and the matrix from them.
    The matrix's pitch is 10 mm, not 5 mm, so it moves to 80 mm below the
    sample for the same NAs, and the changer's rail grows to 150 mm.
2026-11-01 C04: The optical head (#92)
    Adds optical-head.FCStd: the head plate, the decks, the objective
    changer with its detent, the filter slider, the fold mirror's mount,
    the camera port's bracket, the camera mounts with focus slides and the
    epi plate, with the bought parts in place. Its checks cover every moving
    part across its travel, and the layout's light against the parts.
    Modelling the head moved some parts of the design:
    - The camera port hangs upside down, so its body clears the slider, and
    the colour camera moves to the right, so its swing clears the fold
    mirror's mount.
    - The flip mirror sits 42 mm after the fold, not 50, so the swing
    clears the mono camera.
    - The slider and the epi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
2026-11-01 C05: Stage stack, base and column (#93)
    Adds stand.FCStd and sample-inserts.FCStd, built by stand.py and inserts.py.
    The stand: a 465 x 425 mm base plate on feet; a column of two 40 x 80 mm
    extrusions that the head plate bolts to; the Z lift carrying a plate, the
    LED matrix on its mount, and the XY stage on four spacers; an adapter in
    the top plate's pockets with the four-slide insert; and the overview
    camera on a bracket from the upper deck. Its checks cover the lift's
    range for every sample, overlaps, the stack's sweep over the lift's and
    the stage's travel, the column's interface, the lift's load, and the
    overview camera's view and clearance from the head.
    The inserts: four slides, a 96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
2026-11-01 C06: The assembly and its motion (#94)
    Adds instrument.FCStd, built by assembly.py: the optical head on the
    stand, with every part in the same groups as their own documents.
    Its checks: the head and the stand don't overlap, with the head's moving
    parts across their travel; each insert and its labware clear the head
    and the overview camera across the stage's and the lift's travel and the
    objective changes; the stage's openings pass the 5x's and the 10x's
    brightfield light at every target and the 20x's at every target's
    centre, traced from each LED; and everything stays over the base plate.
    Its facts give the envelope (465 x 425 x 598 mm) and the mass (30.4 kg
    before the enclosure and the ele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
2026-11-01 C07: Enclosure and electronics (#95)
    Adds enclosure.py, and the enclosure and the electronics to
    instrument.FCStd.
    The cover is a frame of 20 x 20 mm extrusions with 1.5 mm aluminium
    panels, standing on the table over the instrument on a foam strip, apart
    from it, so it lifts off. The front is a door hinged on the left, whose
    interlock switch the shut door presses. Air comes in through a baffled
    intake low on the right and leaves through a baffled 120 mm fan behind
    the mono camera; the head plate gets an opening behind the camera's fan
    and two cable slots into a duct behind it. The electronics sit on a tray
    on the base plate under the stage.
    Its checks: the cover clears the instrument, its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
2026-11-01 C08: Manufacturing outputs (#96)
    Adds drawings.py and cad/optima/outputs/: a PDF drawing and a STEP file
    for each of the 32 custom parts, and a bill of materials (CSV) with the
    custom parts and 33 lines of bought parts, built from the same scripts.
    Each drawing is a TechDraw page on this project's own A3 sheet: the part
    in first-angle projection, drawn as it sits in the instrument, with an
    isometric view, its overall sizes, its notes and a title block. Any size
    not shown comes from the STEP file of the same number.
    The checks: every part has a drawing, a STEP file and a BOM row; each
    drawing's sizes, measured by TechDraw, are its part's; each STEP file
    reads back with the same solids and v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
2026-11-01 C09: Screw holes (#97)
    Adds fasteners.py: a Screw is data (size, seat, axis, grip, depth, the
    parts it clamps and goes into), and each part's builder cuts the holes
    that name it. head.py, stand.py and enclosure.py list 197 screws, so the
    models, drawings and STEP files all have their holes.
    A new part, the epi plate's bracket (H16), holds the epi plate on the
    head plate. The guides' rails are counterbored, the slider's nut block
    is shorter so the carriage's screws clear it, and the supply and the
    drivers' carrier move back on the tray, clear of its screws.
    The instrument model checks that every screw clears the parts, those on
    fixed parts across the moving parts' travel, and that its head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
2026-11-01 The OPTIMA electronics plan (#98)
    Adds docs/misc/optima_electronics_plan.md: the proposed decisions, the
    architecture (power, interlock, grounding, USB), eight phases from the
    electrical design to bench bring-up, and the decisions the owner needs
    to make first. The hardware design's §8 links to it.
    Marks C09 Done in the CAD plan.
2026-11-01 E01: The electrical design (#99)
    Adds docs/misc/optima_electrical_design.md: the power tree with its
    budget, fuses and wire gauges; the grounding; the interlock circuit,
    which turns the epi LEDs off in hardware whatever the firmware does; and
    each board's inputs and outputs.
    It takes the plan's recommendations for a 24-to-12 V converter and a
    powered USB hub, puts the four LED drivers on the one carrier board, and
    lists what's still open. The plan records the owner's decisions and
    E01's status.
2026-11-02 E02: Cables (#100)
    Every cable in the instrument, with its length taken from the CAD model:
    cables.py routes each one across the base, through the ducts and up the
    riser to the head, and writes outputs/cables.csv. It checks the
    conductors' ratings, the power runs' voltage drops, the bought cables'
    lengths and USB's. The harnesses' pins are in docs/misc/optima_cables.md.
    The CAD gets a power tray and a control tray in place of the one, the
    single carrier board, a mains inlet on a bracket in the cover's notch,
    the earth stud and a duct behind the lift.
    The camera port needs 15 V, which E01 missed: a DDR-30G-15 behind a
    fifth fuse supplies it. Marks E01 Done.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
2026-11-02 E03: The motion controller (#101)
    The SKR Pico's pin map and grblHAL settings, worked out from the stages'
    data and checked by the CAD build, a loader that sends them and reads
    them back, how to build and flash grblHAL, and a bench test. Nothing has
    run on hardware yet. Marks E02 Done.
2026-11-02 E04: The carrier board's schematic (#102)
    The circuit in Python, drawn as a KiCad schematic with its netlist and a
    clean electrical rules check, and checks that KiCad reads back the same
    circuit, that the interlock can't be bypassed on the board, and that the
    pins, levels and connectors are right. The cable list names the board's
    connectors. It also fixes the CAD build's occasional false mismatch, from
    tree ranks FreeCAD sometimes saves. Marks E03 approved; its bench test
    waits for the parts. Over the M size budget: 706 lines.
2026-11-02 Links to the OPTIMA design's parts (#104)
    Adds a "Where to find the parts" section to the hardware design: the parts
    it names, examples for those it only describes, and those left unlinked.
    Adds links to the text of section 5.2, and repairs the Chroma, ProScan,
    BIOS-105S and grblHAL links in the sources.
2026-11-02 E05: The carrier board's layout (#103)
    Places the parts by script and routes the board: 140 x 100 mm, two layers,
    with the high-current paths and longest runs laid out and locked, and
    FreeRouting's tracks kept in routes.ses. Adds the fabrication files, and
    gives the CAD the board's size, layout and tall parts.
    For the layout, GPIO 17 and 18 swap, U3's third and fourth gates swap, and
    J15's pins are reordered. F1 moves by the buck, so 5 V stays far from the
    door's rail.
2026-11-02 E06: The optics firmware, part 1 (#105)
    Adds the optics controller's firmware, in its own workspace: the LED
    channels with the interlock, the camera triggers and the exposure inputs,
    over a documented serial protocol. The logic is in a no_std library tested
    on a PC, and a new CI job builds the firmware and keeps its UF2 file.
    Records the decision to allow unsafe code in the firmware, with the
    workspace and the protocol, in ADRs 0048 to 0050. Marks E05 Done.
    It hasn't run on a chip yet: its bench test waits for a Pico 2.
